lachlanhurst/dukki/scripts/mjcf_to_f360/README.md

# mjcf_to_f360

Rebuilds a MuJoCo MJCF robot (for example the microduck model in
`microduck_rl`) inside Autodesk Fusion 360 as a positioned, jointed assembly
of mesh bodies. Nothing is converted to solid CAD geometry. The result is a
reference assembly to remodel parts against.

What you get in Fusion:

- One "link" component per MJCF body (named `<body>_link`), placed at the
  body's world pose in the zero configuration, all directly under the root.
  Links attached to the world (the trunk) are grounded.
- One "part" component per mesh asset, nested inside the links, holding a
  single mesh body in the mesh's own frame and coloured from the MJCF
  material. A part that appears several times (servos, bearings) is one
  component with several occurrences, so redrawing it once as solid geometry
  updates every instance. Each occurrence carries the geom's body-relative
  pose.
- A rigid group per link (named `<link>_rigid`) binding the link's parts to
  it. Fusion's motion solver works on the flattened assembly, so without this
  the parts would stay behind when a joint is driven.
- An as-built revolute joint for every hinge (slider for every slide) between
  child and parent links, with MJCF joint ranges applied as limits. A
  construction sketch line named `axis_<joint>` in the child link marks each
  axis.

The browser tree therefore looks like:

```
root
  trunk_base_link            (grounded)
    trunk_base:1
    xl330:1
    xl330:2
    seeed_bearing__configuration__22x16x4:1
    ...
  yaw2roll_link
    yaw2roll:1
    xl330:3
    ...
```

## Files

| File | Runs where | Purpose |
| --- | --- | --- |
| `mjcf_to_f360.py` | Fusion 360 | The script. Entry point is `run(context)`. |
| `mjcf_to_f360.manifest` | Fusion 360 | Required by Fusion to recognise the folder as a script. |
| `mjcf_model.py` | both | MJCF reader, standard library only. |
| `stl_tools.py` | both | STL read/transform/write, used to bake geom poses into mesh copies. |
| `dump_assembly.py` | any Python 3 | Prints the tree and joints as the script will build them. `--bake` writes positioned STLs and `assembly.json`. |
| `check_against_mujoco.py` | needs `mujoco` | Verifies the reader against MuJoCo's own kinematics. |

## Running in Fusion 360

1. Copy this whole folder to the Fusion machine. Keep the folder name
   `mjcf_to_f360`; Fusion requires the folder, script and manifest to share it.
2. Also copy the MJCF file and its mesh folder. Mesh paths are resolved
   relative to the MJCF file through `meshdir`, so the easiest option is to
   check out `microduck_rl` on that machine.
3. In Fusion create a new empty design and save it.
4. Utilities > Add-Ins > Scripts tab > the green `+` next to "My Scripts",
   choose this folder. It appears as `mjcf_to_f360`.
5. Select it and press Run. A file dialog asks for the MJCF file. Pick
   `src/mjlab_microduck/robot/microduck/robot_walk.xml` or another variant.
6. Wait for the progress dialog. A summary lists components, mesh bodies,
   joints and warnings. The full log and the baked STL copies are written to
   the system temp folder under `mjcf_to_f360/<model name>/` unless
   `BAKE_DIR` is set.

Settings live at the top of `mjcf_to_f360.py`:

- `MJCF_PATH`: hard-code the file to skip the dialog.
- `INCLUDE_GEOM_GROUPS`: `(0, 1, 2)` imports visual meshes only. Add `3` to
  include collision meshes (in this model those duplicate visual parts).
- `SKIP_MESHES`: mesh asset names to leave out, for example `("xl330",)` when
  you would rather place a J288 model yourself.
- `CREATE_JOINTS`, `CREATE_RIGID_GROUPS`, `GROUND_ROOT_BODIES`, `APPLY_COLOURS`: switch features off
  if they cause trouble on your Fusion version.
- `SHARE_REPEATED_PARTS`: `True` gives one component per mesh asset reused
  by every occurrence. `False` gives every geom its own component, which you
  want only if instances of a part need to diverge.
- `LINK_NAME_FORMAT`, `PART_NAME_FORMAT`: component naming. Links default to
  `<body>_link` because several MJCF bodies share their name with a mesh
  asset (for example `trunk_base`), and Fusion needs component names to be
  unique.
- `RECOLOUR_ONLY`: set to `True` and run again on a design built by this
  script to apply colours without re-importing. It matches part components
  by name. The log lists which appearance library and base appearance were
  used, which helps if colours still fail.
- `SWITCH_TO_DIRECT_MODELLING`: the API only allows mesh bodies in a
  parametric design inside a base feature, so the script creates one base
  feature per part. Set this to `True` to convert the empty design to direct
  modelling instead. Direct designs have no timeline and no position
  snapshots, which sidesteps the repeat-occurrence placement problem
  described below. As-built joints exist only in parametric designs, so with
  `PARAMETRIC_AFTER_PLACEMENT` on (the default) the script converts the
  design back to parametric once all parts are placed and verified, then
  creates the joints; the placed assembly becomes the base state of the
  timeline. If that conversion is refused, or you turn the option off, the
  script creates regular joints instead, drawing the axis line at the same
  world location in both links so that applying the joint moves nothing.

## Checking the model before you go to the Fusion machine

```sh
python3 scripts/mjcf_to_f360/dump_assembly.py \
    ../microduck_rl/src/mjlab_microduck/robot/microduck/robot_walk.xml

cd ../microduck_rl && uv run python \
    ../microduck-unitree/scripts/mjcf_to_f360/check_against_mujoco.py \
    src/mjlab_microduck/robot/microduck/robot_walk.xml
```

The first command prints every body with its world position and quaternion,
every joint with its world origin and axis, and every geom that will be
imported or skipped. The second compares those numbers with MuJoCo and
reports the worst error.

## Fallback without the script

`dump_assembly.py --bake OUT_DIR --units mm` writes one STL per geom with the
body-relative pose baked in, plus `assembly.json` listing each body's world
matrix and each joint's world origin and axis. Those files can be inserted
into Fusion manually if the API route misbehaves.

## Units and conventions

- MJCF lengths are metres. The Fusion API works in centimetres. Baked STLs
  are written in millimetres by default and imported as millimetres.
- MuJoCo quaternions are `(w, x, y, z)`; the reader also accepts `euler`,
  `axisangle`, `xyaxes` and `zaxis` and follows the `<compiler>` settings for
  angle units and Euler sequence.
- Links sit flat under the root rather than nested in the kinematic tree,
  because as-built joints are simplest to create between occurrences in the
  same context. The MJCF parent is recorded in each link's description.
- Part occurrences are created with the link-relative pose, then all of them
  are moved in one call to the root component's `transformOccurrences`, which
  works on the flattened assembly with every transform relative to the root.
  Per-occurrence transform properties behaved differently for the first and
  for repeated occurrences of a shared component, so they are only a
  fallback. In a parametric design the positions are then captured with a
  snapshot so the timeline cannot revert them.
- With `VERIFY_PLACEMENT` on, the script compares every part's root-context
  bounding box in Fusion against the baked mesh under the MJCF pose and logs
  `verify ...: ok` or `OFF by ... cm` per part. The check is geometric and
  independent of transform semantics. Misplaced parts are then retried
  through a sequence of alternative placement strategies (set the proxy's
  world pose, set the native occurrence's local pose, recreate the occurrence
  in the link, recreate it under the root) until one verifies; the log
  records `repaired ... via ...` for each, checks again after the position
  capture, and runs a final check after the joints. In practice only repeated
  occurrences of shared components have been affected, and the evidence so
  far points at the parametric position capture moving them after they were
  correctly placed. Two ways around it: run with
  `SWITCH_TO_DIRECT_MODELLING = True`, or set `SHARE_REPEATED_PARTS = False`
  so no component has more than one occurrence.

## Known limits

- Only mesh geoms are imported. Primitive geoms (box, capsule, sphere) are
  listed as skipped by `dump_assembly.py`.
- Ball joints, equality constraints and sites are not created. Sites appear
  in `dump_assembly.py` output only through their parent body.
- Mesh `refpos`/`refquat` attributes are ignored.
- Baked STL copies now only carry MJCF mesh scale and the unit conversion,
  not the geom pose. `dump_assembly.py --bake` still writes fully positioned
  copies, which suits manual insertion better.
- The Fusion API calls (mesh import, mesh body appearance, joint limits) are
  wrapped so a failure produces a warning in the log rather than aborting the
  import. Check the warnings list if something looks off.
- The MJCF reading and mesh baking are verified against MuJoCo on this side.
  The flat structure and the link-and-part structure both build correctly in
  Fusion; the first link-and-part run placed parts wrongly because a
  link-relative pose was set on a root-context proxy, which is now fixed. The log file records the exact call that failed if
  anything does.
