lachlanhurst/dukki/docs/bridge-pcb.md

# Bridge carrier PCB

Design note for a trunk PCB that carries the bridge: the WeAct STM32G474 core board, the LSM6DSV16X breakout, a 5 V supply from the 6S pack, a soft start on plug-in, and the power distribution to the servo segments and the head. It replaces the trunk buck, the distribution board and the point-to-point wiring of `hardware.md` sections 5.8, 10 and 11.2 with one board.

Date: 24/10/2026. Status: rev B (section 6.6) made and assembled by JLC, ordered 17/10/2026 with the head_ext board (tag `jlc-order-2026-10-17`), and tested on the bench: the soft power switch, the PC4 hold, the PA0 rail reading and the 3 s shutdown (section 6.5), all 15 servos answering on segments A, C and D, and the head powered and linked through J6 (`hardware.md` 5.8). One fault found in bring-up: the J288 pigtail has pin 1 GND, not SIGNAL as the board was laid out for, so the segment headers are fitted turned 180 degrees. The G marks are still right; the footprints and housing outlines need turning in the next revision.

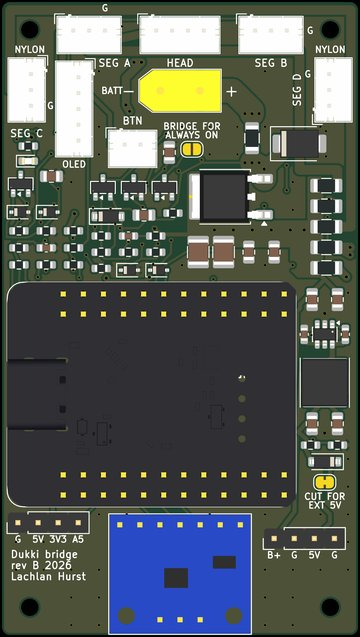
[picture p1: docs/pictures/bridge-3d-top.jpeg]
3D render of the bridge board, top face: the JST segment, head, display and button headers and the XT30 pads along the top, the soft start and buck in the middle, the WeAct core board and the LSM6DSV16X breakout at the bottom


Rev B, top face, from `hardware/bridge/bridge-3d-top.png`.

## 1. Requirements

From the decisions so far:

- Modules: the WeAct STM32G474 core board (QFN48) and the LSM6DSV16X breakout already on hand, soldered to the carrier on short sections of header pin with about a 1 mm gap underneath, so tracks and tented vias may run under them but no parts. On the bench build they sit on female headers instead.
- Battery in on a male XT30, the solder-cup cable connector (XT30U-M), not a PCB-mount part. It stands straight up from the board face, centred near the top edge: its two solder cups (2.2 mm diameter, 5.0 mm apart, measured) go through KiCad's stock XT30U-M footprint, 2.7 mm plated holes on 3.8 mm pads, soldered by hand from the back. Not fitted by JLCPCB.
- A soft start so plugging the pack in does not spark. Since rev A (12/10/2026) the soft start is also a soft power switch with a button (section 6.5); JP2 bridged restores the original always-on behaviour.
- A 5 V buck from the pack for the WeAct board's VCC input.
- SMD fuses. No current sensing.
- Every other connector is JST PH 2.0, vertical through hole (B2B/B3B/B4B/B5B-PH-K-S), soldered by hand, not by JLC. The plug enters from above, perpendicular to the board:

| Ref | Pins | Use | Pin order |
|---|---|---|---|
| J2 to J5 (segments A to D) | 3 | servo segments A to D (D not used on this robot) | board pads 1 SIGNAL, 2 +BATT, 3 GND. The J288 pigtail is the other way round, pin 1 GND (found 23/10/2026), so on rev B the header is fitted turned 180 degrees from its silkscreen outline |
| J6 (head) | 4 | head bundle (`hardware.md` 11.3) | 1 head buck +BATT, 2 GND, 3 bridge TX (PA9) to head UART7 RX, 4 bridge RX (PA10) from head UART7 TX |
| J7 (display) | 5 | status display | 1 GND, 2 3.3 V, 3 SCL (PA15), 4 SDA (PB7), the module's own order; 5 not connected. Five pins so the head bundle's 4-pin plug cannot go in it (16/10/2026) |
| J8 (button) | 2 | power and shutdown button | 1 BTN_A, 2 BTN_B: the button joins them (section 6.5) |

- Servo +BATT and GND carried on wide pours on both layers, stitched with vias.
- Board 45 mm wide by 80 mm tall, with a mounting hole in each corner. Everything tall (connectors, XT30, any capacitor over about 3 mm) in the top 20 mm; the flat modules and low parts below.
- Built by JLCPCB PCBA, parts on the top side only, preferring Basic parts. Each Extended part type adds a feeder fee of about AUD 4.60 (US$3).

## 2. Block diagram

```text
 XT30 --+-- F1 main --+-- Q1 soft start (P-FET) --+== +BATT_SW pour (both layers) ==+
        |             |                            |                                 |
       GND           TVS                        bulk C                     +--F2--> J2  seg A (PB3)
                                                   |                       +--F3--> J3  seg B (PB9)
                                                   |                       +--F4--> J4  seg C (PA2)
                                                   |                       +--F5--> J5  seg D (PC10)
                                                   |                       +--F6--> J6  head, pin 1
                                                   |
                                   U1 buck 5 V ----+---> WeAct VCC (P1-1, P1-2)
                                                          WeAct 3V3 --> IMU, OLED
                                   +BATT_SW --100k--+--10k-- GND
                                                    +--> PA0 (pack voltage), 100 nF
```

One ground node throughout: the soft start switches the positive side, so the pack's negative, the servo ground, the head's ground and the bridge's ground stay one net, as `hardware.md` 11.3 relies on.

## 3. Power

### 3.1 Current budget

PH 2.0 contacts are rated about 2 A, so the five branches cap continuous current near 9 A, with leg peaks of 2 to 3 A for short periods (`hardware.md` 11.3). The main path (XT30, F1, Q1, pours) is designed for 10 A continuous. Fifteen servos at their 1.92 A limit together (29 A) cannot pass through the connectors and is not a design case.

### 3.2 Fuses

A main fuse and one per branch. A short in a leg harness, wired in PH crimp wire, would burn the wire long before a 10 A main fuse opened, so each branch gets its own.

| Fuse | Rating | Candidate |
|---|---|---|
| F1 main | 10 A, 1206, time lag, 32 V DC, 150 A breaking | BHFUSE BSMD1206C-2100T, C41367232, Extended |
| F2 to F5 segments | 4 A, 1206, time lag, 72 V DC | BHFUSE BSMD1206C-1400T, C41367227, Extended |
| F6 head buck feed | 2 A, 1206, time lag, 72 V DC | BHFUSE BSMD1206C-1200T, C41367223, Extended |

All three are BHFUSE's BSMD1206C time-lag series (12/10/2026). The Littelfuse 0458 parts first chosen turned out to be very fast-acting, which opens within milliseconds at two to three times rating; a leg of five servos can in principle draw about 9.6 A in a stall, so a time-lag part rides through peaks a fast one would not. F1's 150 A breaking capacity is below what a 6S pack can deliver into a dead short; every 1206 fuse is in that range, and a larger fuse body (2410, or a blade) would be the step up if it ever matters. 4 A sits above the PH contact's 2 A on purpose: the fuse protects the harness wire against a short, and the contact's rating is a thermal one that short peaks do not reach. Revisit both with the measured walking draw (open item in `hardware.md` section 13). F6 went from 1 A to 2 A on 12/10/2026: the head carrier's 5 V, 3 A buck draws about 0.85 A from a nearly flat pack (about 20 V) before amplifier peaks, too close to a 1 A rating.

### 3.3 Soft start

A high-side P-channel MOSFET (Q1) whose gate is pulled down slowly, so the switched rail rises over about 30 ms instead of in microseconds. Inrush is then the downstream capacitance times the ramp rate, and the only capacitance on the XT30 side of Q1 is the TVS and the FET itself, so the plug barely arcs.

```text
 +BATT_IN ---+--------------+------ S  Q1  D ------+---- +BATT_SW
             |              |          G           |
             R2 470k     C1 2.2u       |     R3 1k + C2 47n (Miller)
             |              |          |           |
             +------+-------+----------+-----------+
                    |       |
               D1 15 V      R1 470k
              (Vgs clamp)   |
                           GND
```

- R1 and R2 set the on-state gate drive: half the pack, 10.5 to 12.6 V across a 6S discharge, inside the FET's ±20 V. D1 clamps transients.
- C2, gate to drain through R3 (1 k, which keeps C2 from loading the gate at high frequency), sets the ramp. During the Miller plateau about 38 µA leaves the gate node, so the drain rises at about 810 V/s: 25 V in about 31 ms. Inrush is about 0.8 A per mF of downstream capacitance.
- C1, gate to source, stops the FET switching on at the instant of plug-in. Without it, C2 would hold the gate at the drain's 0 V while the source jumped to 25 V. With 2.2 µF against 47 nF, the gate starts within 0.6 V of the source, below the threshold.
- Turn-on delay before the ramp is about 0.2 s, set by R1, R2 and C1.
- The FET dissipates the energy stored in the downstream capacitance during the ramp, ½CV², over 30 ms, plus whatever the servos draw as they wake. Q1's single-pulse SOA at 10 to 100 ms has to cover it. Measured 10/10/2026 with a meter's capacitance range across VCC and GND, unpowered: 64, 60 and 56 µF on three J288s, so about 60 µF each, ordinary electrolytic spread. Fifteen servos make about 0.9 mF, and the board's bulk (section 3.4) brings the worst case to about 1.2 mF. That gives about 1 A of inrush and about 0.4 J at 25 V, well under the 2 mF (0.6 J) first assumed here.

Chosen: NCE40P70K (C130101, Extended, 5,600 in stock), 40 V, 10 mΩ at 10 V, TO-252, pin 1 gate, tab drain, pin 3 source. KiCad's stock library has the TO-252 footprint and the larger package gives more pulse margin than the Diodes DMP4015SPSQ (C384564, 7 mΩ, PowerDI5060-8), which needs a footprint drawn from its datasheet; it stays the alternative if the band runs short of room. At 10 A Q1 dissipates about 1 W, which its drain pour has to spread; average current is far lower.

A TVS on the input (SMBJ26A, 26 V standoff, 28.9 V minimum breakdown) protects Q1 from plug-in ringing and regeneration spikes; it cannot protect the servos, whose 25.2 V limit is too close to a full pack for any TVS. The SMBJ30A first fitted could clamp at up to 48 V at full surge current, above Q1's 40 V; the 26 V part clamps at 42 V at its full 14 A rating and near 30 V at the currents plug-in ringing gives (changed 16/10/2026).

### 3.4 Bulk capacitance

In the schematic: two 10 µF 50 V X7R 1210 MLCCs (C3, C4) and two 2.2 µF 50 V MLCCs (C5, C6). The polymer capacitors were dropped at layout: at 7.7 mm tall they needed the top band, which the connectors fill. The servos carry about 0.9 mF between them, so the board's own bulk was only ever a supplement.

After Q1, to absorb regeneration when servos brake and to stiffen the rail at the branch connectors. Two ways, depending on height:

- Low profile: four to six 10 µF 50 V X7R 1210 MLCCs (2.5 mm tall, so they can sit outside the tall band). At 25 V they keep about 3 to 4 µF each.
- Tall: one or two 35 V polymer capacitors, 100 µF in 6.3 x 7 mm (C2982822, 66,000 in stock) or 220 µF in 8 x 9 mm, inside the tall band.

The servos carry their own input capacitors and a LiPo absorbs regeneration well, so the board's bulk is a supplement. Start with the MLCCs plus one polymer if it fits.

### 3.5 5 V buck

TI LMR51606XDBVR (C21260865, Extended, about 9,700 in stock): 4 to 65 V in, 600 mA, SOT-23-6, 400 kHz, light-load efficient mode. A 65 V rating leaves margin over a full pack plus transients, where 36 V parts such as the TPS560430 sit too close. Load is the WeAct board, IMU and OLED, under 150 mA. Output to the WeAct's VCC pins (P1-1, P1-2) through D8 and JP1; the board's own LDO makes 3.3 V. Capacitors from TI's datasheet; the inductor is TI's 33 µH in a 6 x 6 x 4.5 mm Sunlord SWPA6045S330MT (1.65 A saturation), above the converter's 1.4 A maximum current limit so a 5 V short cannot saturate it (the 4 x 4 mm SWPA4030S first chosen saturated at 1.1 A; changed 16/10/2026). Feedback 130k/22k sets 5.53 V at the buck, about 5.2 V on the rail after D8.

USB. The WeAct board feeds its USB 5 V to VCC through its own Schottky (D4, B5819W), so USB can stay plugged in with the pack connected: the buck's 5.2 V holds that diode off and nothing flows into the computer, even if a fault put pack voltage on the 5 V rail. Without D8, USB alone would feed back through the buck: from its output through L1 and the high-side switch's body diode onto the switched rail at about 4 V, charging the servos' input capacitors (about 0.9 mF) and running fifteen J288s below their 6.4 V minimum from the USB port, with a few volts on the XT30's + pin. D8 (B5819W, C8598, Basic) between the buck's output and JP1 blocks that path. With both connected, the buck and USB share through their two diodes.

### 3.6 Backup 5 V

In case the on-board buck does not work, the board can take an external step-down instead:

- J9, four plated wire pads at 2.54 mm in the bottom-right corner, silkscreened B+ G 5V G: pin 1 is the switched rail (+BATT_SW, after the soft start, so the external module also gets the inrush limit), 2 ground, 3 the 5 V rail in, 4 ground.
- JP1, a solder jumper bridged by a copper trace, joins the buck's output (net 5V_BUCK: L1, C11, C12 and the feedback divider, then through D8) to the 5 V rail that feeds the WeAct board. Silkscreen beside it: CUT FOR EXT 5V. Cutting it isolates the buck, which then regulates only its own output capacitors.
- To use the backup: cut JP1, wire the external module's input to J9 pins 1 and 2 and its output to pins 3 and 4. The switched rail and the servos are unaffected.
- If the soft start itself ever fails, the servos lose power regardless of the 5 V; the fix then is a wire across Q1, from its source pad to its tab.

### 3.7 Pack voltage

100 k from +BATT_SW, 10 k to ground, 100 nF at PA0, as `hardware.md` 5.8 specifies. Full scale 36 V.

## 4. Signals

The pin allocation is `hardware.md` section 5.8, with the carrier's additions: PC4 the power hold, PB5 the button sense through Q3, PA5 the J10 breakout, and fused +BATT on each segment connector's pin 2 (5.8 notes them).

| Net | WeAct pin | To |
|---|---|---|
| Segment A, B, C, D data | PB3, PB9, PA2, PC10 | J2 to J5 pin 1, each through a 0 R link with room for a series resistor (hardware.md 5.6). The 5.6 V zener footprints first planned were dropped 12/10/2026 to make room for the soft power switch; they were never fitted and the bench runs without them |
| Link TX, RX | PA9, PA10 | J6 pins 3 and 4 |
| IMU SCK, MOSI, MISO, CS, INT1 | PB13, PB15, PB14, PA4, PA8 | breakout SCL, SDA, AD0, CS, INT1; VCC to 3V3 |
| OLED SCL, SDA | PA15, PB7 | J7 |
| Button sense | PB5 | Q3 drain (J8 is BTN_A and BTN_B, section 6.5) |
| Power hold | PC4 | D11 to PWR_ON (section 6.5) |
| PA5 breakout | PA5 | J10 |
| Pack voltage | PA0 | divider |

The IMU breakout's three-pin row (SDX, SCX, INT2), measured 12.0 mm from the 7-pin row, gets plated holes but no connections: header pins there support the breakout against vibration (footprint in `hardware/kicad/`, see its README).

## 5. Floor plan

As laid out (11/10/2026), board coordinates in mm from the top-left corner:

```text
  0 +---------------------------------------------+  top edge
    | (o)  SEG A      HEAD      SEG B         (o) |  row 1: J2, J6, J3
    | SEG C OLED  BATT [ XT30 ]           SEG D   |  J4, J7, J1, J5: side connectors and the display turned along their edges
    |               BTN          F1  TVS          |  J8, main fuse, input TVS
 20 +---------------------------------------------+  end of the tall band
    | LED, divider,  gate     Q1        branch    |  low parts only
    | data-line      network  (TO-252)  fuses     |
    | R, power switch        bulk MLCC F2..F6     |
 36 +------------------------------------+--------+
    |                                    |        |
    |  WeAct G474 core board, horizontal | 5 V    |  1 mm stand-off
    |  36.3 x 28.1, USB-C at left edge   | buck   |
    |                                    | JP1    |
 64 +-------+--------------------+-------+--------+
    |       |  LSM6DSV16X        |                |
    | (o)   |  breakout, pins up |  J9 backup (o) |  between the lower holes
 80 +-------+--------------------+----------------+  bottom edge
```

- (o) are the four M2 mounting holes (2.2 mm), centres 3.5 mm from each edge. Use nylon screws (or nylon washers) in the top two, H1 and H2, marked NYLON on the silkscreen: segment C's fused +BATT feed runs round the top edge under their screw heads, about 1.9 mm from the hole centres.
- The head connector is top centre and the XT30 second-row centre (swapped 11/10/2026 for better head and battery cable runs).
- SEG C and SEG D are turned 90° outward, pin rows along the left and right edges with the housing's latch side facing the edge. The display connector (J7) is turned the same way as SEG C and stands beside it.
- Ground pins that carry current connect solid to both pours, not through thermal spokes: the XT30's ground pad, the ground pins of the five servo and head connectors, and the WeAct board's ground header pins. Spokes (0.5 mm, at most four a layer) would have choked the battery return, about 10 A through one pad. Solid pads take a hotter iron: 60 W or more and a large tip for the XT30.
- Locked 2.5 mm ground copper on both layers runs from the XT30's ground pad towards the + pad and up and down, so no signal track passes between or beside the pads, and stitching vias ring the pad.
- The WeAct board is horizontal, as the user asked, with its USB-C at the left board edge so a cable reaches it from the side. Its long side does not fit between the corner holes, so it sits between the top band and the IMU.
- The IMU breakout sits at the bottom, centred between the lower holes, turned 180° so its pin row faces the WeAct's P1 row (PB13 to PB15 and PA8 are there). In this orientation the chip's X axis points left and Y down the board; the mount quaternion must use that (hardware.md 6.1).
- The high-current path (XT30 +, F1, Q1, the switched-rail trunk and the fuse column) stays in the top band and the right of the middle band.

### 5.1 Fitting the tall band

The through-hole PH connectors (9.0 x 5.6 mm courtyard for 3 pins, 11.0 x 5.6 for 4) are far smaller than the SMD ones first chosen (11.4 x 8.5), which let the display and button return to connectors and still leaves room in the band for F1 and the TVS.

## 6. Parts so far

| Function | Part | LCSC | Library |
|---|---|---|---|
| 5 V buck | TI LMR51606XDBVR | C21260865 | Extended |
| Buck inductor | Sunlord SWPA6045S330MT, 33 µH, 6 x 6 x 4.5 mm | C83451 | Extended |
| Soft-start FET | NCE40P70K, TO-252 | C130101 | Extended |
| Main fuse | BHFUSE BSMD1206C-2100T, 10 A time lag | C41367232 | Extended |
| Segment fuses | BHFUSE BSMD1206C-1400T, 4 A time lag | C41367227 | Extended |
| Head feed fuse | BHFUSE BSMD1206C-1200T, 2 A time lag | C41367223 | Extended |
| Bulk | 10 µF 50 V X7R 1210 | C596319 | Extended |
| Input TVS | SMBJ26A (hongjiacheng) | C19077580 | Preferred |
| Gate clamp | BZT52C15, SOD-123 | C19077412 | Preferred |
| Power LED | KT-0603G, green | C12624 | Extended |
| XT30, male, solder cup | Amass XT30U-M | hand fitted, cups through 2.7 mm plated holes | |
| PH connectors | JST B3B-PH-K-S (x4), B4B-PH-K-S, B5B-PH-K-S, B2B-PH-K-S | hand fitted | |

Resistors (except R9 130k and R21 2.2M, which are Preferred: no fee) and the 100 nF, 47 nF, 1 µF, 2.2 µF and 22 µF capacitors are Basic parts; the schematic carries every LCSC number. That makes 8 non-Preferred Extended part types (U1, L1, Q1, the three fuse types, the 10 µF 1210 and the LED), about AUD 37 in feeder fees per order (JLC waives the fee for Preferred parts), of which the LED (dispensable) and the three fuse types are the easiest to trim. Genuine JST through-hole PH headers fit the servo pigtails' housings for certain; buy them with the XT30.

## 6.1 Schematic

`hardware/bridge/bridge.kicad_sch` (KiCad 10), PDF beside it. Bootstrapped by `scripts/kicad/gen_bridge_sch.py`, which every pin connects through a net label, power symbol or no-connect flag, so there are no wires; from now on the schematic file is the source and the script refuses to overwrite it. ERC: no violations. Project symbols (the LMR51606, from KiCad's LMR50410 with the same pinout, and a TO-252-numbered P-MOSFET) are in `hardware/kicad/Dukki.kicad_sym`.

Not in the BOM, fitted by hand or not parts at all: the XT30 (J1), all seven PH connectors (J2 to J8), the WeAct board (U2), the IMU breakout (U3) and the mounting holes.

## 6.2 Layout

`hardware/bridge/bridge.kicad_pcb`, 2 layers, 45 x 80 mm, 1 mm corner radius. Bootstrapped by two scripts run on the KiCad VM, after which the board file is the source:

- `scripts/kicad/gen_bridge_pcb.py` builds the board from the schematic netlist, the same links "Update PCB from Schematic" makes, places every part (the `PLACE` table holds the floor plan), draws the outline and puts the hand-assembly labels on the silkscreen. Reference designators are on the fab layer only: JLC places by the CPL file.
- `scripts/kicad/route_bridge_pcb.py` sets the net classes (segment feeds 1.2 mm, head feed 1.0 mm, buck switch node 0.6 mm, other power 0.5 mm, signals 0.25 mm), draws and locks the high-current copper by hand on both layers, tied with via pairs (XT30 + to F1 and F1 to Q1's source at 3 mm each side, necking to 1.6 mm for the last 1.5 mm into the fuse's pads, which are only 2.9 mm apart; the switched-rail trunk at 2 mm on top plus its pour and 3 mm underneath; the fuse column at 2 mm on top plus the pour). By IPC-2221 one 3 mm track of 1 oz copper carries about 5 A for a 10 degree rise and 2 mm about 4 A, so a single layer would have run 40 to 50 degrees warm at the 10 A design current; two layers bring it to about 10 °C. 2 oz copper is the alternative if it is ever needed. The script also routes the four segment feeds by hand, each in its own lane (left to the autorouter, they knocked one another out once the power copper was locked; SEG C's runs round the outside of the board on the top layer, right edge, top edge, left edge, so it walls nothing off), then autoroutes the rest with Freerouting, pours ground on both layers and a solid switched-rail pour over the trunk, and stitches the ground pours with a via grid wherever clearance allows.

Freerouting 2.5.0 needs Java 25. Both live in `~/opt` on the VM (an Eclipse Temurin JRE and the release jar from GitHub, no system install). DRC on the routed board: no copper errors and nothing unconnected.

## 6.3 Fabrication package and cost

`scripts/kicad/export_jlc.py` (on the VM) writes `hardware/bridge/fab/`: `bridge-gerbers.zip` (copper, mask, paste, silkscreen, outline, separate PTH and NPTH Excellon files), `bridge-bom.csv` and `bridge-cpl.csv` in JLC's column formats. Only parts with an LCSC number, in the BOM and not DNP go to assembly.

Checked against JLC's 2-layer limits: narrowest track 0.187 mm (limit 0.127), clearance 0.2 mm (0.127), smallest via 0.6 mm on a 0.3 mm drill (ring 0.15, limit 0.13), smallest plated hole 0.75 mm, copper to edge 0.25 mm. Silkscreen text is 0.8 to 0.9 mm high (0.6 mm for the pin names inside J6 and J7), strokes 0.15 mm, against JLC's recommended 1.0 mm: legible, but small.

`hardware/bridge/bridge-polarity.png` (from `scripts/kicad/polarity_check.py`) is a top render with every assembled polarised part's pin 1 or cathode ringed and its CPL rotation labelled, to check against JLC's placement preview before confirming the order.

`scripts/kicad/jlc_cost.py` prices the BOM from JLC's live parts library (11/10/2026), with JLC's published Economic PCBA fees (US$8 setup, US$1.50 stencil, US$0.0016 a joint, US$3 per Extended part type, Preferred exempt), at A$1.44 per US$:

| Boards assembled | Parts | Fees | Assembly total |
|---|---|---|---|
| 5 | A$34 | A$49 | about A$83 |
| 2 | A$19 | A$49 | about A$68 |

Not included: the bare boards (2 layers, 45 x 80 mm, a few dollars for five), shipping to Australia and GST, which JLC's cart adds, and the hand-fitted parts (XT30U-M, seven JST PH-K headers). Of the fees, A$35 is the eight Extended part types (the buck, its inductor, Q1, three fuse values, the 10 µF bulk capacitors and the LED); dropping the LED or making the four segment fuses and the head fuse one value would each save A$4.30.

Before ordering, check in JLC's placement preview that the polarised parts sit the right way round: U1 (pin 1), Q1 (tab), D1 and D2 (cathode bar), D3 (LED cathode). KiCad and JLC disagree on the zero rotation of some packages.

## 6.4 3D model

`hardware/bridge/bridge.step` (about 3 MB, committed 22/10/2026) holds the assembled board and every part, in millimetres from the board's lower-left corner (the fab files' origin) with z = 0 on the top face. It is written by `python3 scripts/kicad/export_step.py bridge` from the repo root on the VM, which exports a temporary copy of the board with the WeAct board's model swapped for `CoreBoard_STM32G474_standin.step` (outline, MCU, USB-C receptacle and pins at the same height), as WeAct's model carries no licence and is not ours to redistribute. For a local file with WeAct's own model, run `kicad-cli pcb export step --subst-models --drill-origin -o bridge.step bridge.kicad_pcb` in `hardware/bridge/` and do not commit it. KiCad's library supplies the SMD parts, the PH headers and the wire-pad header; `scripts/kicad/gen_3d_models.py` supplies the rest: the WeAct board from WeAct's own model (or the stand-in), lifted to the 1 mm stand-off on short pins with its tall headers removed; the IMU breakout (outline, holes, chip, both pin rows, also at 1 mm); and an approximate XT30U-M (housing to the footprint outline, 11 mm tall, cups through the board), which KiCad's library lacks.

The board's drill and placement origin is its lower-left corner, and `export_jlc.py` writes the Gerbers, drill files and placement file relative to it. The first placement file measured from that corner while the Gerbers used KiCad's page coordinates; JLC flagged the offset and corrected it automatically.

## 6.5 Soft power switch and PA5 breakout (12/10/2026)

The soft start is now also an on/off switch (schematic block 9). Off means everything downstream of Q1 is off (servos, buck, bridge, LED, head feed), which answers the overnight drain in hardware.md section 10.

| Ref | Part | Job |
|---|---|---|
| Q2 | 2N7002 | grounds R1 (net PWR_LO): Q1 is on only while Q2 is on |
| JP2 | solder jumper, open | bridge it (silkscreen BRIDGE FOR ALWAYS ON) to ground PWR_LO permanently: the old behaviour, on whenever a pack is plugged in, soft start intact. It also keeps Q5 and Q4 off |
| R14, J8 | 100k, the button | the button joins BTN_A, fed from the pack through R14, to BTN_B. It switches about 250 µA, and only while held, so R14's value costs nothing at rest (470k, then 220k, until 16/10/2026: with 100k a tap of about 70 ms latches at an 18 V pack with worst-case parts and the bridge's PC4 asserted within 0.5 s, about 45 ms if PC4 is asserted early; 220k needed about 150 ms); the contacts see pack voltage while open, which any tactile switch handles at that current, and R14 limits a pinched or shorted lead to microamps. J8's pins are BTN_A and BTN_B, no longer PB5 and ground |
| D9, R15, C14 | 12 V zener, 1M, 1 µF X7R 0805 | clamp BTN_B to 12 V and hold the button sense on for about a second after release. X7R keeps most of its 1 µF at 12 V; the X5R 0603 first fitted kept about half |
| D12 | 1N4148WS | BTN_B to Q2's gate (PWR_ON) |
| D11, R13, C15 | BAT54WS, 1M, 1 µF X7R 0805 | the bridge's hold: PC4 (PWR_HOLD) to PWR_ON, about 3 V; the diode keeps BTN_B's 12 V off PC4. C15 with R13 (about 1 s) stretches a tap: a short tap charges PWR_ON to a few volts through D12 (about 11 V only after a press of half a second or more), which keeps Q2 on long enough after release for the bridge to boot and assert PC4. It also holds Q2 on through a bridge reset (watchdog, fault, software reset) for 0.22 s worst case (0.76 s typical, 1.4 s best: PWR_ON starts at 3.2 V, Q2's threshold is 1.0 to 2.6 V), so a reset does not cut the servos and the head as long as the firmware re-asserts PC4 within milliseconds. As PWR_ON decays Q5 and Q4 snap Q1 off while it is still fully on, so C15's slow decay cannot leave Q1 half on (added 16/10/2026) |
| Q3 | 2N7002 | button sense: pulls PB5 low while BTN_B is high. PB5 sees only its pull-up and Q3, and a press reads low as on the breadboard, so one firmware build runs on both. Because of C14, PB5 stays low for about a second after release |
| R20, D13, Q5 | 1M, 12 V zener, 2N7002 | with Q2 off, PWR_LO rises to Q1's gate voltage; Q5 turns on |
| Q4, R21, R22 | MMBT3906, 2.2M, 1M | Q5 turns Q4 on, pulling Q1's gate to its source in about 20 ms (C1 alone would take about a second, with Q1 half on meanwhile). Q4 also holds Q1 firmly off at plug-in |

Off-state leakage is about 20 µA (Q4's base current and R1, R20 into D13), decades for a pack, below its self-discharge. All parts are JLC Basic or Preferred: no new feeder fees.

PA5 breakout (J10): four plated wire pads at 2.54 mm in the bottom-left corner, silkscreened G 5V 3V3 A5. The board name block moved down below it.

Firmware rules, as implemented in `src/bridge/src/power.rs` and `button.rs` (23/10/2026). The same build runs on the breadboard, where PC4 and PA0 are unconnected and the hold is a no-op; tie A0 to ground through 10 k there, or the floating pin makes the boot decision a guess.

- At boot, set the PC4 hold if the button is pressed or PA0 shows the switched rail live (above 6 V; C15 has held it on through a reset). That re-latches after a watchdog or software reset, and leaves power off when only USB is plugged in. It runs as soon as the clocks are up, a few milliseconds after reset, well inside C15's 0.22 s worst case; reading PA0 needs the ADC, so it cannot come before clock setup.
- A press already down at boot does not count towards a shutdown until it is released, and neither does the press that turns the power on from USB; only a fresh press can start the 3 s shutdown hold.
- On USB with the hold off, a fresh press sets the hold and turns the robot on.
- A completed 3 s hold commits a shutdown. Release PC4 once the head reports off; at once if no compute module has spoken since the bridge started; or after the request's 10 s lapse if a running or stalled head does not acknowledge it. After that no press counts. If the bridge is still running 3 s later, the display shows "RELEASE BUTTON" if it is held, otherwise "POWER OFF, unplug pack" (USB, JP2 bridged, or the breadboard). Once the rail reads dead with the button up (on USB), the hold is off again and a fresh press turns the robot back on.
- C14 keeps PB5 low for about a second after release, so a press of a little over 2 s completes the 3 s hold, and the display's countdown runs on after release.
- The IWDG runs with a 1 s timeout, pet every 10 ms by the power task: a hung bridge resets and lets the hold go instead of keeping the robot on until the pack is unplugged. A system reset stops it, so the console's `U` and DFU flashing still work (checked 23/10/2026).
- Flash over SWD or DFU with USB connected or JP2 bridged: entering the bootloader releases PC4, and on pack power alone the board turns itself off 0.2 to 1.4 s later.
- The OLED's top line shows the switched rail from PA0, and the console's `power:` line the hold state, the rail and what the boot decision saw.
- Low-voltage shutdown, still to do: on the 10 s average of PA0 below the threshold, request the same shutdown the button does, so robotd sits the robot and halts the CM4, then release PC4. A lower hard floor (about 3.3 V a cell under load) cuts power after a short delay even if the head does not answer. The low-battery warning already reads PA0 (battery.rs): it took the servos' 0.5 V readings until 23/10/2026, and a servo that lost power kept its last reply, taken as the rail fell, so the warning came on after every power-off.

Bench check on the assembled rev B board, 23/10/2026, with no servos: the hold, the 3 s shutdown and power-on from USB all work, and PA0 reads 12.1 V from a 12 V supply.

## 6.6 Rev B: pre-order review (16/10/2026)

A review before ordering found the WeAct footprint wrong and a handful of smaller issues. The board was regenerated from the generators and re-routed; the name block now reads rev B.

- WeAct footprint: P1 (the VCC side) had its rows swapped. `gen_weact_kicad.py` assumed odd pins on the inner row of both headers, but the two headers are the same part placed the same way round, so P1's odd pins are on its outer row and P2's on its inner row; the silkscreen's two label lines read as the rows beside them, and the user confirmed PB13 on P1's inner row. On the rev A layout every P1 signal would have met its column neighbour: PA9/PA10 swapped, SPI2 SCK on PB12, segment B's data on BOOT0. The breadboard was never affected: it is wired by the labels.
- J7 (display) is a 5-pin PH, pin 5 unconnected, so the 4-pin head bundle cannot be plugged into it. With both 4-pin, the head cable in J7 shorted 3.3 V through F6, and the display cable in J6 put 25 V across the module backwards.
- C15 (1 µF on PWR_ON) holds the power switch through a bridge reset and does the tap stretching; C14 is now X7R 0805; R14 is 100k (section 6.5).
- L1 is now the SWPA6045S330MT (1.65 A saturation) and D2 an SMBJ26A (section 3.3, 3.5).
- Buck column re-laid in current order: input capacitors C7/C8 (switched-rail pads up, ground pads down), U1 turned 270 degrees so its GND pin faces them and SW and CB face the inductor, the boot capacitor C9 beside CB and SW, the 100 nF C10 beside VIN, L1 on end with its switch-node pad up, then the output capacitors, divider, D8 and JP1. The feedback trace was re-routed after a second review: it drops to the bottom layer at U1's FB pin and runs down the west side to the divider, 17 mm long and at least 1.9 mm from any switch-node copper (it had run between U1's CB and SW pins and 0.22 mm beside L1's switch pad).
- Bulk capacitors C3 to C6 stood on end under Q1: switched-rail pad up into the extended rail pour, ground pad down into ground, solid to both. Lying flat they had cut the pour into slivers.
- Ground pads of the power capacitors (C3 to C8, C10 to C12) and U1 connect solid, not through thermal spokes.
- The head feed VHEAD has its own 1.0 mm net class (it was in the 0.6 mm class and Freerouting necked it to 0.45 mm in places); two of its four layer changes have a second via (the other two had no room).
- Second review, local copper only: F3's segment B vias moved 0.15 mm off its output pad (they overlapped it, so solder could wick away from a 4 A joint); D2's ground pad solid with two stitching vias; the XT30's + pad has 0.75 mm clearance to everything else and the ground bar beside it is shorter (a slipping iron there shorts the pack); JP2's ground pad on thermal spokes so it can be bridged with an iron.
- H1 and H2 take nylon screws (section 5); segment C's feed still runs round the top edge.
- A G beside each segment connector's ground pin (pin 3), outside the housing so it shows with a plug in: a pigtail crimped the wrong way round swaps SIGNAL and GND, and the mark lets each harness be checked with a meter before it goes in.
- Pin names inside the head (J6: B+, G, TX, RX, the bridge's own TX and RX) and display (J7: G, 3V3, SCL, SDA, NC) connectors' housings on the front, in 0.6 mm text to fit between the pads and the outline (the board's minimum silkscreen height lowered to 0.5 mm for them; JLC recommends 0.8 to 1.0 mm, so they print a little soft). Hidden once the connectors are fitted: a reference on an unpopulated board.
- Pin labels for both modules on the front silkscreen (`scripts/kicad/module_labels.py`): the WeAct board's in its own style, two lines per column between the header rows with the upper line naming the upper row, so the board reads like the module sitting on it; the IMU breakout's beside each pin, vertical (the SPI half of its dual names: MISO, MOSI, SCLK). They lie under the modules once fitted, for checking orientation as each goes on.
- JP1 (cut to isolate the buck) turned 180 degrees so D8's output pad faces JP1's buck-side pad; the 5V_D feed had crossed the cut line diagonally. A top-layer keep-out strip now runs across its gap, 1.5 mm past the link either side, so nothing but the link itself lies where a knife could slip (`route_bridge_pcb.py` adds it after autorouting; JP1's two links are drawn by hand).
- Not changed: the segment connectors stay single-contact PH 2.0 (about 2 A a contact against 4 A fuses), by the user's choice.

Routing: `route_bridge_pcb.py`, then the head board's tidy script on the bridge (`python3 scripts/kicad/tidy_head_pcb.py <stage> bridge`, stages unstitch, dedupe, straighten until it reports 0, widen, stitch; not unground, since on this board the autorouted ground tracks join pockets of the packed middle band that the pours cannot reach). It straightened 231 joints and replaced the 2.2 mm stitching grid with a sparser 3.5 mm one. Its pad check was tightened: a joint on a pad of the net is never straightened (it had cut C1 out of Q1_G). `scripts/kicad/route_one_net.py` now takes `PCB=` and `W=` from the environment for stragglers; this run needed none. DRC with schematic parity: no violations, nothing unconnected. 31 BOM lines, 54 placements; the new parts are Basic (C28323, C22961) or Preferred (C19077580), so the feeder fees are unchanged.

## 7. Open items

- XT30 polarity: KiCad's XT30U-M footprint marks pad 1 (square) as − and pad 2 as +, and the schematic follows it (pin 1 GND, pin 2 +BATT). Check against the connector's moulded marks before soldering.
- Strain-relief holes beside the display and button pads, if wanted.
- Height limit outside the band: the WeAct's USB-C and buttons stand about 3.5 mm above the carrier plus the 1 mm stand-off, so anything under that should be fine.
- Review the routed board in the KiCad GUI before fabrication outputs: track routes Freerouting chose, the pours, and the silkscreen labels.
- Q1's SOA curve against about 0.4 J over 30 ms (section 3.3).
- Branch fuse ratings, from the measured walking draw.
- The WeAct board's underside: anything that stops it sitting flat.
