lachlanhurst/dukki/hardware/bridge/bridge-3d-top.png

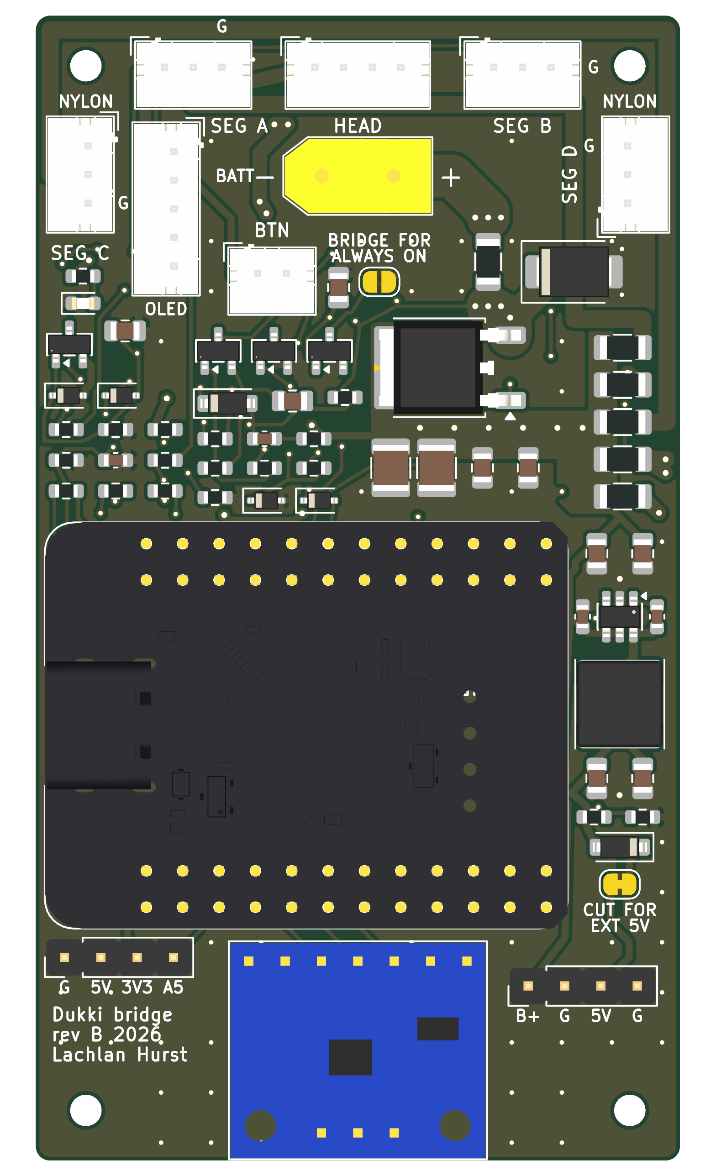
hardware/bridge/bridge-3d-top.png
