lachlanhurst/dukki/hardware/bridge/bridge-polarity.png

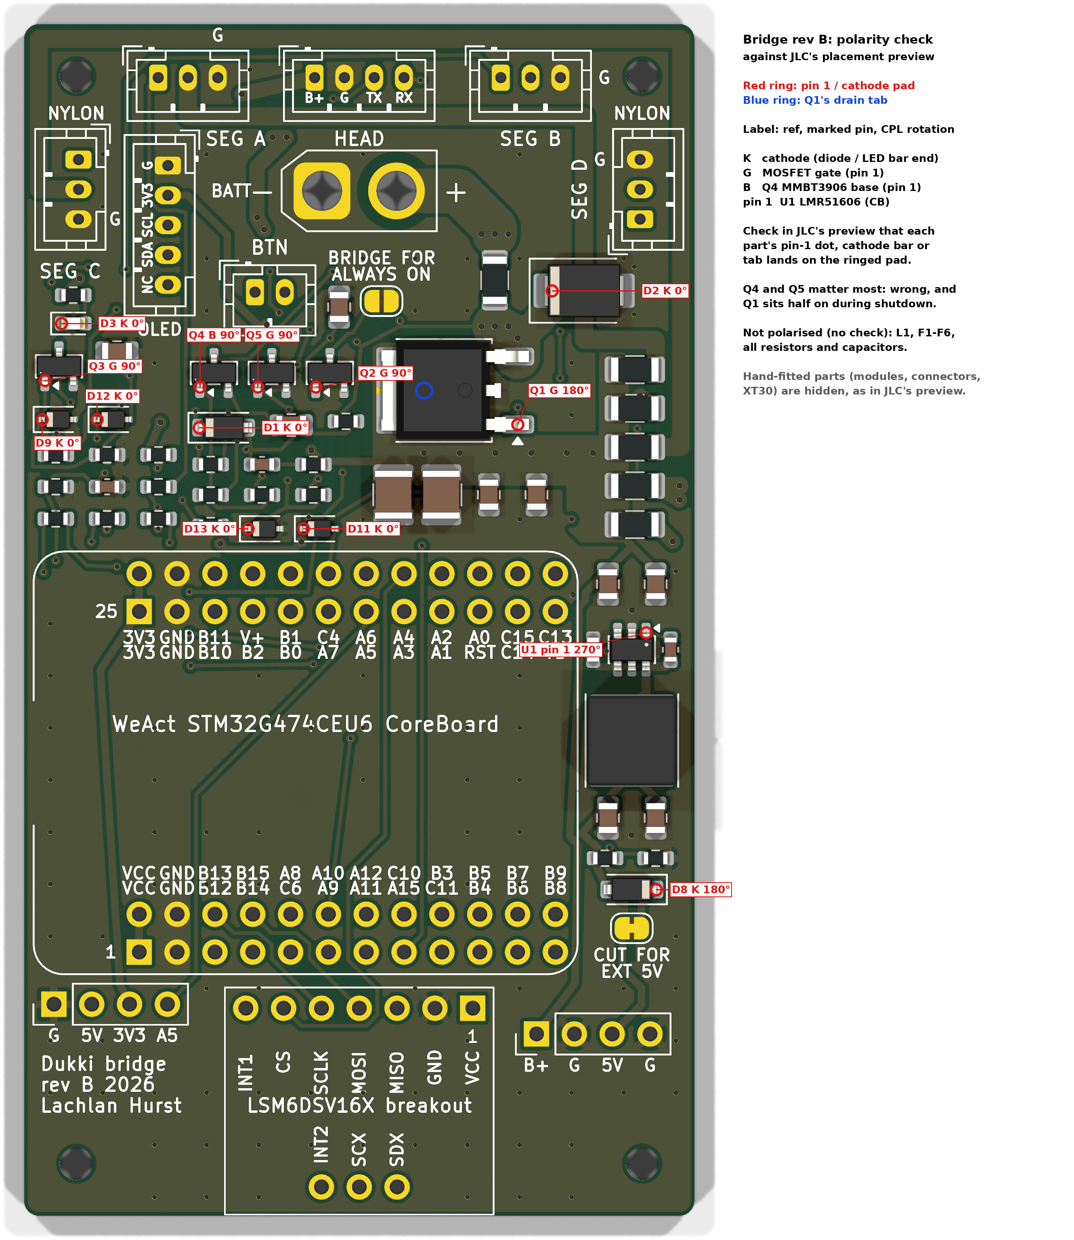
hardware/bridge/bridge-polarity.png
