lachlanhurst/dukki/hardware/head/head-3d-bottom.png

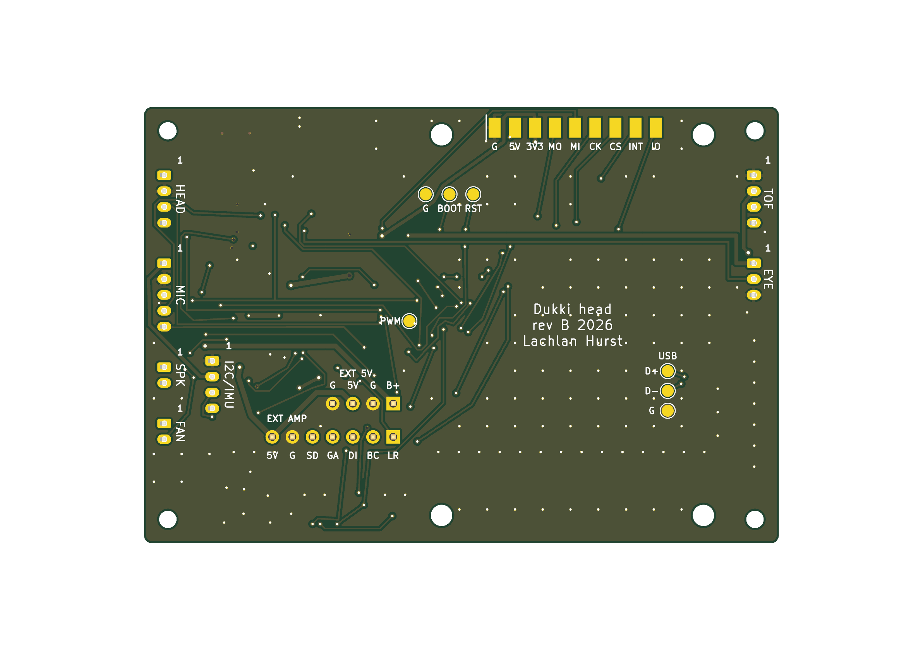
hardware/head/head-3d-bottom.png
