lachlanhurst/dukki/hardware/head/head-3d-top.png

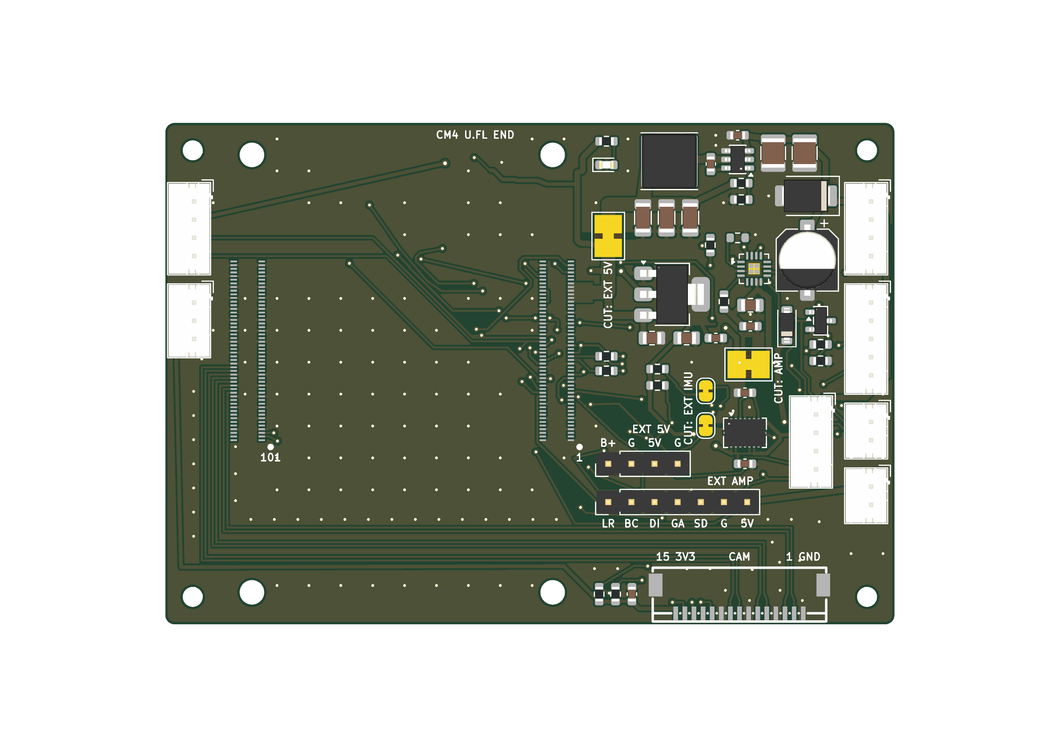
hardware/head/head-3d-top.png
