lachlanhurst/dukki/hardware/head/head-polarity.png

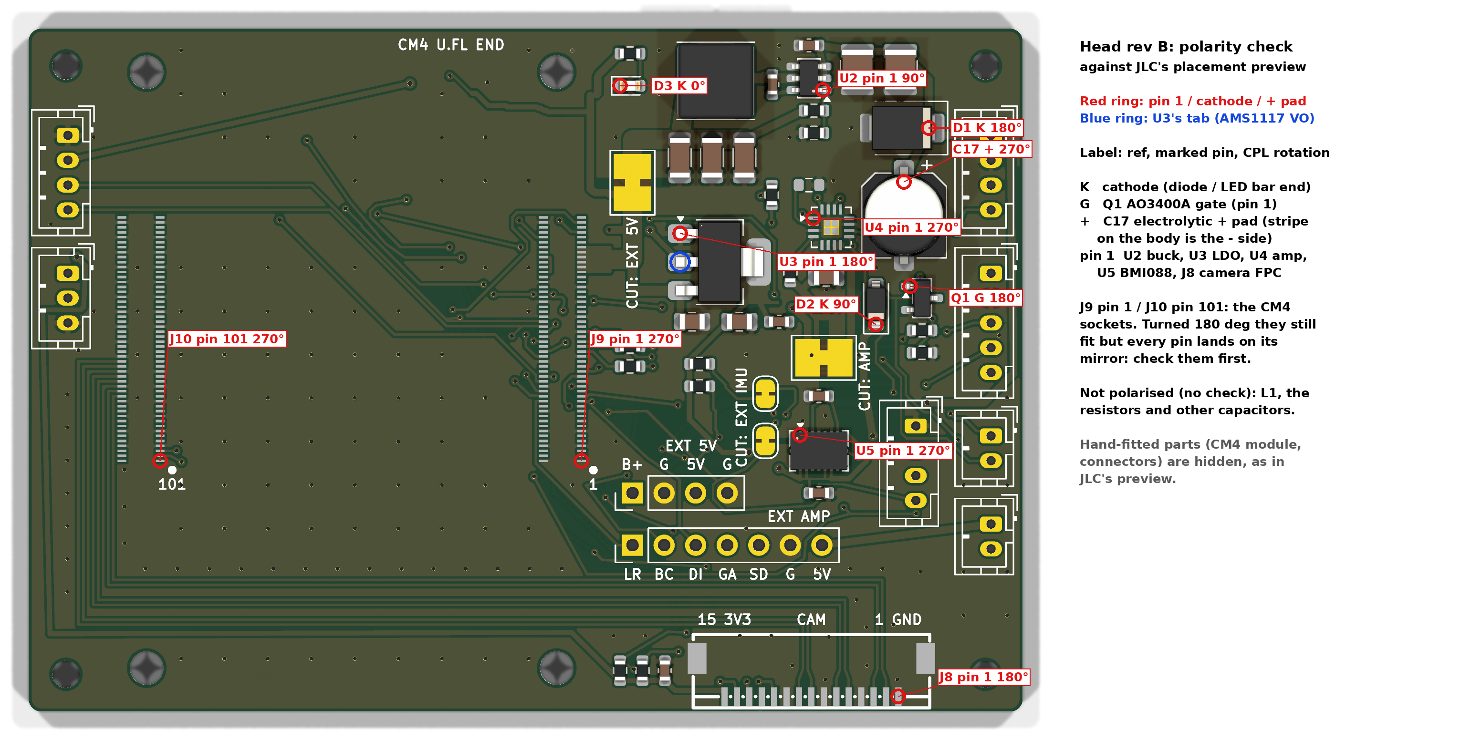
hardware/head/head-polarity.png
