lachlanhurst/dukki/hardware/head/fab/head-bom.csv

Comment | Designator | Footprint | LCSC Part #
10u 50V X7R | C1,C2 | C_1210_3225Metric | C596319
100n 50V | C4,C5,C11,C13,C14,C15,C16 | C_0603_1608Metric | C14663
47u 10V | C6,C7,C8 | C_1206_3216Metric | C96123
10u 25V | C9,C12 | C_0805_2012Metric | C15850
22u 25V | C10 | C_0805_2012Metric | C45783
47u 50V | C17 | CP_Elec_6.3x7.7 | C970679
SMBJ30A | D1 | D_SMB | C19077584
B5819W | D2 | D_SOD-123 | C8598
green | D3 | LED_0603_1608Metric | C12624
Camera | J8 | FPC_XUNPU_FPC-1.0HF-15PWAR-H20_1x15-1MP_P1.0mm | C19269369
CM4 socket 1-100 | J9 | DF40C_Socket_CM4_1-100 | C597931
CM4 socket 101-200 | J10 | DF40C_Socket_CM4_101-200 | C597931
4.7u | L1 | L_Sunlord_SWPA6045S | C78804
AO3400A | Q1 | SOT-23 | C20917
82k | R1 | R_0603_1608Metric | C23254
15k | R2 | R_0603_1608Metric | C22809
1M | R3 | R_0603_1608Metric | C22935
100R | R5 | R_0603_1608Metric | C22775
100k | R6 | R_0603_1608Metric | C25803
330R | R7,R14 | R_0603_1608Metric | C23138
4.7k | R8,R9,R10,R11 | R_0603_1608Metric | C23162
1k | R12,R13 | R_0603_1608Metric | C21190
LMR51635YDDCR | U2 | TSOT-23-6 | C45262770
AMS1117-3.3 | U3 | SOT-223-3_TabPin2 | C6186
MAX98357AETE+T | U4 | TQFN-16-1EP_3x3mm_P0.5mm_EP1.23x1.23mm | C910544
BMI088 | U5 | Bosch_LGA-16_4.5x3mm_P0.5mm_LayoutBorder7x1y_ClockwisePinNumbering | C194919
