lachlanhurst/dukki/hardware/bridge/fab/bridge-bom.csv

Comment | Designator | Footprint | LCSC Part #
2.2u 50V | C1,C5,C6,C7,C8 | C_0805_2012Metric | C377773
47n 50V | C2 | C_0603_1608Metric | C1622
10u 50V X7R | C3,C4 | C_1210_3225Metric | C596319
100n 50V | C9,C10,C13 | C_0603_1608Metric | C14663
22u 25V | C11,C12 | C_0805_2012Metric | C45783
1u 50V X7R | C14,C15 | C_0805_2012Metric | C28323
BZT52C15 | D1 | D_SOD-123 | C19077412
SMBJ26A | D2 | D_SMB | C19077580
green | D3 | LED_0603_1608Metric | C12624
B5819W | D8 | D_SOD-123 | C8598
BZT52C12S | D9,D13 | D_SOD-323 | C19077447
BAT54WS | D11 | D_SOD-323 | C7502694
1N4148WS | D12 | D_SOD-323 | C2128
10A | F1 | Fuse_1206_3216Metric | C41367232
4A | F2,F3,F4,F5 | Fuse_1206_3216Metric | C41367227
2A | F6 | Fuse_1206_3216Metric | C41367223
33u | L1 | L_Sunlord_SWPA6045S | C83451
NCE40P70K | Q1 | TO-252-2 | C130101
2N7002 | Q2,Q3,Q5 | SOT-23 | C8545
MMBT3906 | Q4 | SOT-23 | C7420354
470k | R1,R2 | R_0603_1608Metric | C23178
1k | R3 | R_0603_1608Metric | C21190
10k | R4,R12 | R_0603_1608Metric | C25804
0R | R5,R6,R7,R8 | R_0603_1608Metric | C21189
130k | R9 | R_0603_1608Metric | C22795
22k | R10 | R_0603_1608Metric | C31850
100k | R11,R14 | R_0603_1608Metric | C25803
1M | R13,R15,R20,R22 | R_0603_1608Metric | C22935
2.2M | R21 | R_0603_1608Metric | C22938
LMR51606XDBVR | U1 | SOT-23-6 | C21260865
