lachlanhurst/dukki/hardware/bridge/bridge.step

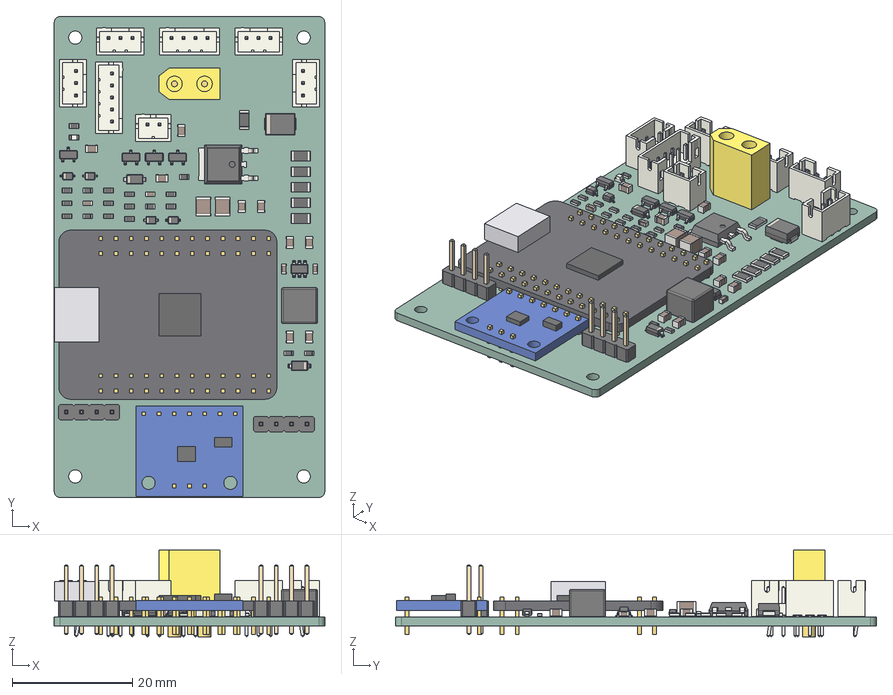
[picture p9: CAD file, 2026-10-21]
hardware/bridge/bridge.step
45.0 x 80.0 x 14.4 mm
D_SOD-323 x 4
C_1210_3225Metric x 2
C_0603_1608Metric x 4
C_0805_2012Metric x 9
JST_B3B_PH_K x 4
R_0603_1608Metric x 18
SOT-23 x 4
D_SOD-123 x 2
LED_0603_1608Metric
932d09b3-9c39-11ed-93f0-dde97e994e83_part
932d09b4-9c39-11ed-93f0-dde97e994e83_part
932d09b5-9c39-11ed-93f0-dde97e994e83_part
pcb x 2
stm32g474
usb_c
pins x 2
Fuse_1206_3216Metric x 6
a6c163e6-8551-11ed-a139-00155d22e2d7_part
a6c16512-8551-11ed-a139-00155d22e2d7_part
a6c16594-8551-11ed-a139-00155d22e2d7_part
JST_B4B_PH_K
housing
contacts
JST_B2B_PH_K
D_SMB
SOT-23-6
PinHeader_1x04_P254mm_Vertical x 2
JST_B5B_PH_K
lsm6dsv16x
regulator
bridge-step-export_PCB
