lachlanhurst/dukki/hardware/cad/stl/neck_pitch_link.stl

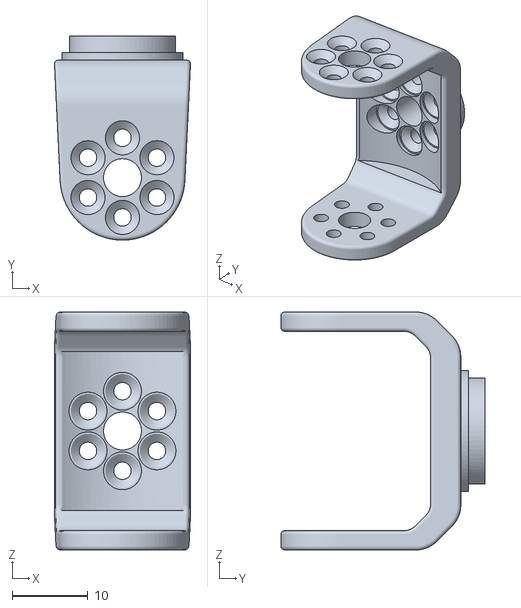
[picture p10: CAD file, 2026-11-07]
hardware/cad/stl/neck_pitch_link.stl
17.9 x 26.9 x 31.4
