lachlanhurst/dukki/hardware/head_ext/head_ext.step

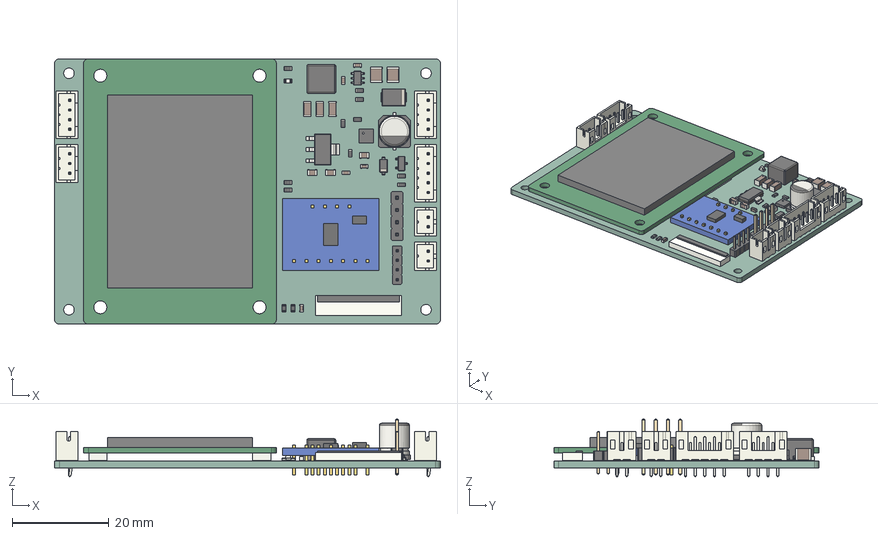
[picture p11: CAD file, 2026-10-21]
hardware/head_ext/head_ext.step
80.0 x 55.0 x 11.9 mm
pcb x 2
bmi088
regulator
pins
R_0603_1608Metric x 12
C_0603_1608Metric x 5
JST_B4B_PH_K x 2
SOT-223
SOT-23
LED_0603_1608Metric
C_1206_3216Metric x 3
D_SOD-123
JST_B2B_PH_K x 2
D_SMB
df40c_mated x 2
C_0805_2012Metric x 3
C_1210_3225Metric x 2
PinHeader_1x04_P254mm_Vertical
housing
actuator
components_envelope
TSOT-23-6
JST_B5B_PH_K
CP_Elec_63x77
PinHeader_1x04_P200mm_Vertical
TQFN_16_1EP_3x3mm_P05mm_EP16x16mm
a6c163e6-8551-11ed-a139-00155d22e2d7_part
a6c16512-8551-11ed-a139-00155d22e2d7_part
a6c16594-8551-11ed-a139-00155d22e2d7_part
JST_B3B_PH_K
head_ext-step-export_PCB
