lachlanhurst/dukki/hardware/kicad/3d/DF40C_Socket_CM4.step

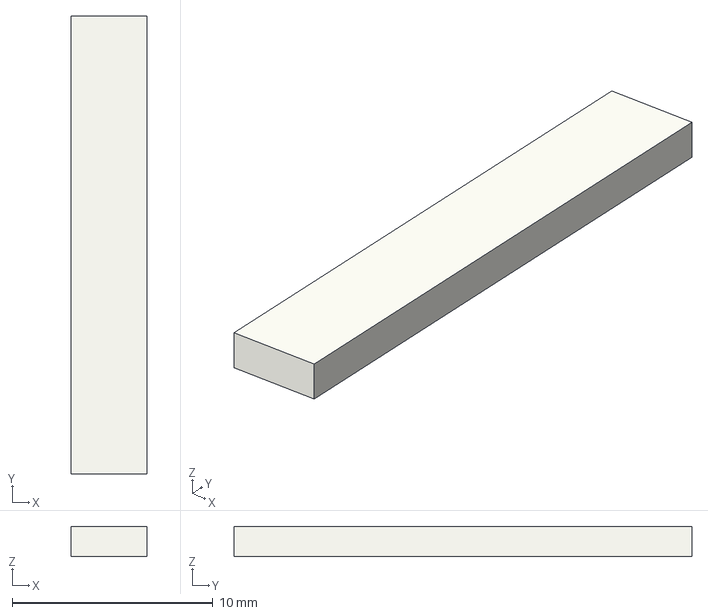
[picture p12: CAD file, 2026-10-21]
hardware/kicad/3d/DF40C_Socket_CM4.step
3.78 x 22.8 x 1.50 mm
