lachlanhurst/dukki/hardware/cad/stl/sole_left_mirrored.stl

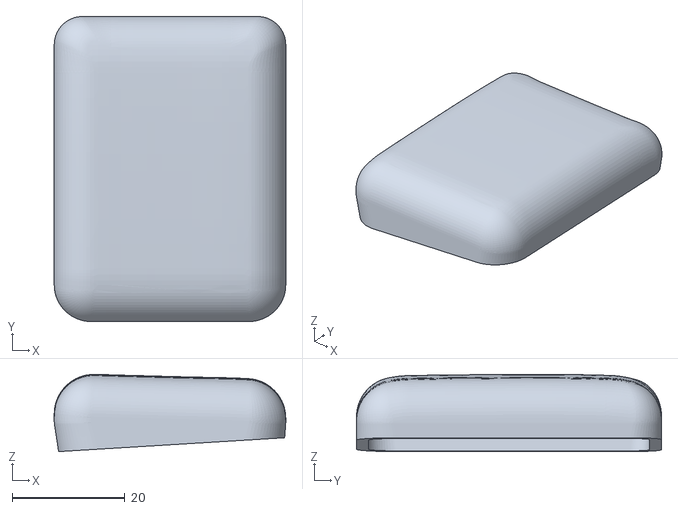
[picture p13: CAD file, 2026-11-07]
hardware/cad/stl/sole_left_mirrored.stl
41.0 x 54.0 x 13.7
