lachlanhurst/dukki/hardware/kicad/3d/BMI088_Module.step

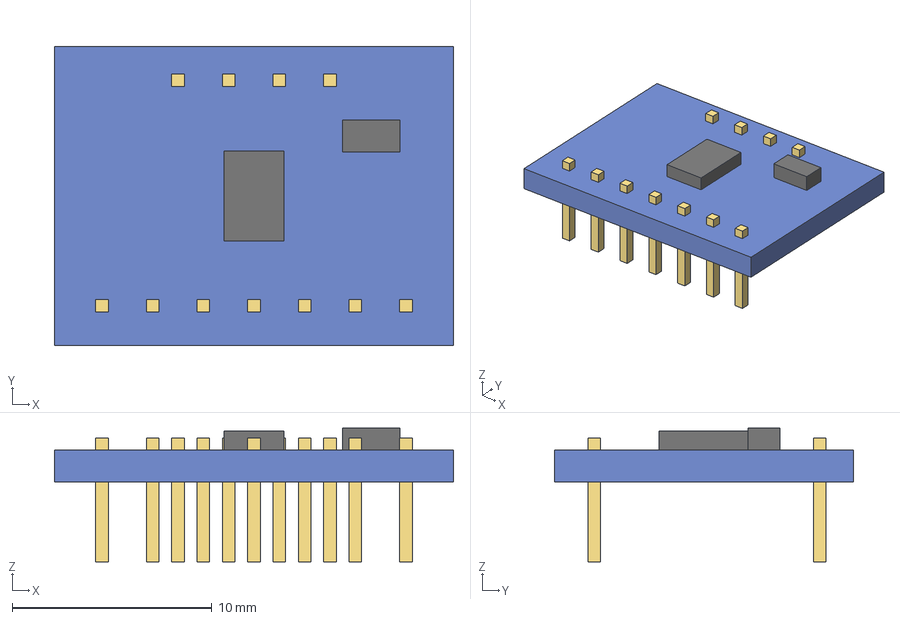
[picture p14: CAD file, 2026-10-21]
hardware/kicad/3d/BMI088_Module.step
20.0 x 15.0 x 6.70 mm
pcb
bmi088
regulator
pins
