lachlanhurst/dukki/hardware/cad/stl/bearing_roll.stl

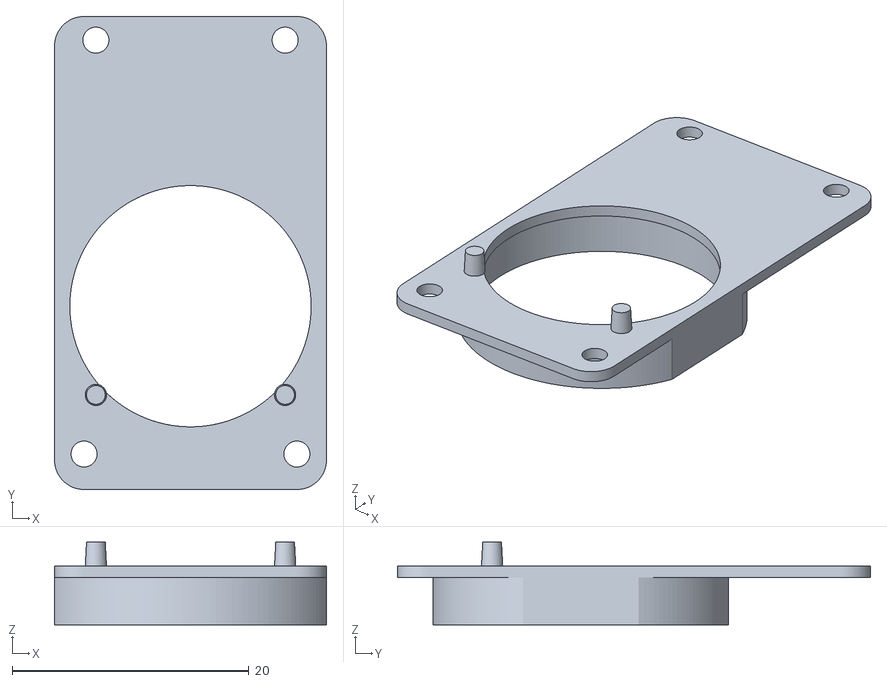
[picture p15: CAD file, 2026-11-07]
hardware/cad/stl/bearing_roll.stl
23.0 x 40.0 x 7.00
