lachlanhurst/dukki/hardware/kicad/3d/FPC_XUNPU_1x15_P1.0mm_H2.0.step

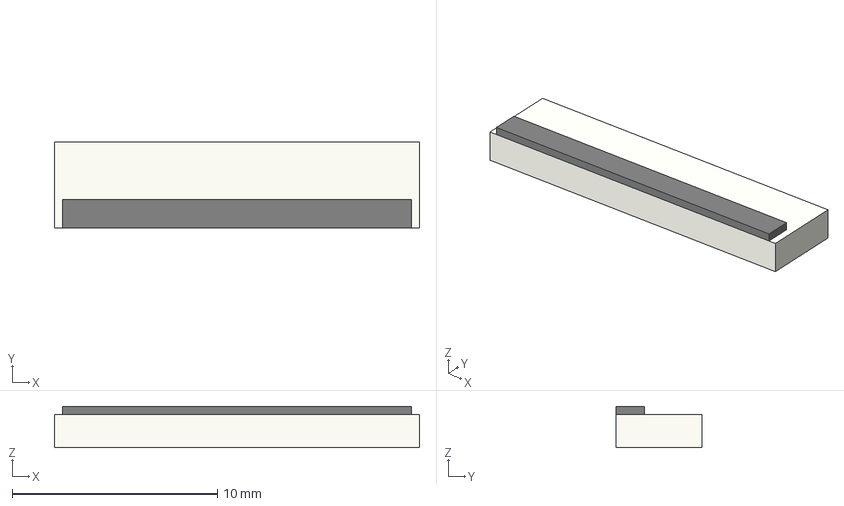
[picture p16: CAD file, 2026-10-21]
hardware/kicad/3d/FPC_XUNPU_1x15_P1.0mm_H2.0.step
17.8 x 4.20 x 2.00 mm
housing
actuator
