lachlanhurst/dukki/hardware/cad/stl/left_upper_leg_mirrored.stl

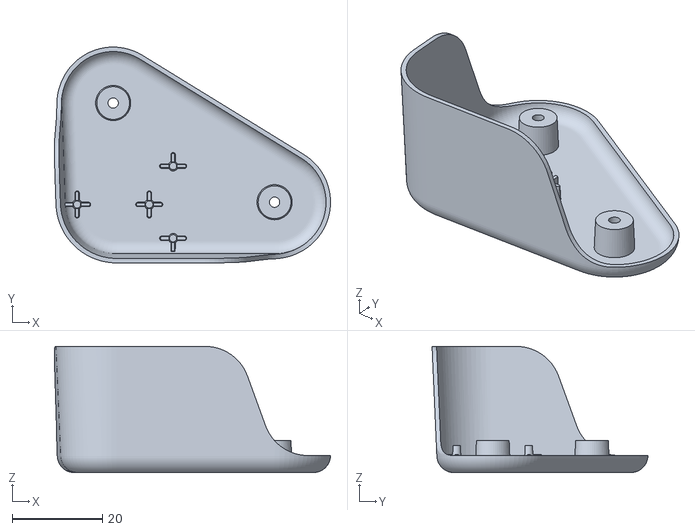
[picture p17: CAD file, 2026-11-07]
hardware/cad/stl/left_upper_leg_mirrored.stl
61.2 x 47.9 x 28.0
