lachlanhurst/dukki/hardware/kicad/3d/Radxa_CM4_Module.step

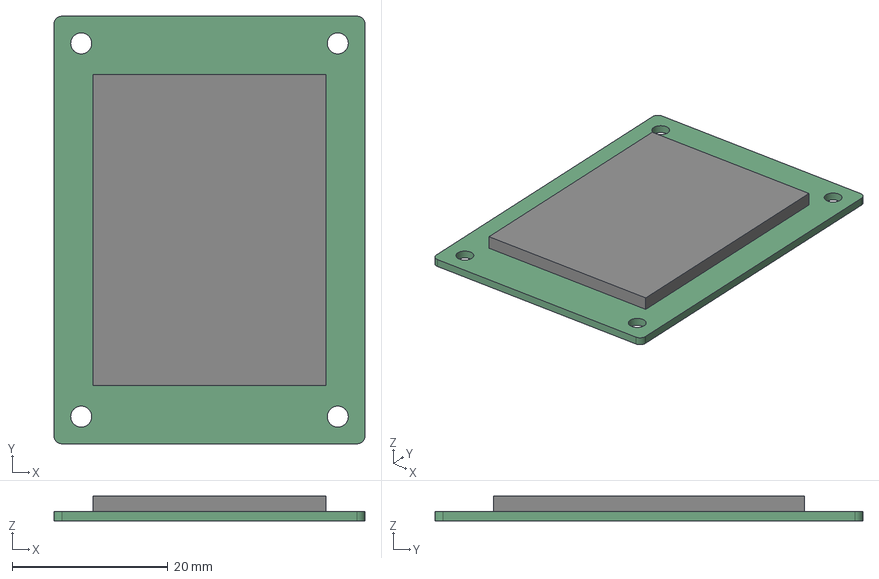
[picture p18: CAD file, 2026-10-21]
hardware/kicad/3d/Radxa_CM4_Module.step
40.0 x 55.0 x 3.20 mm
pcb
components_envelope
