lachlanhurst/dukki/hardware/cad/stl/top_head_shell.stl

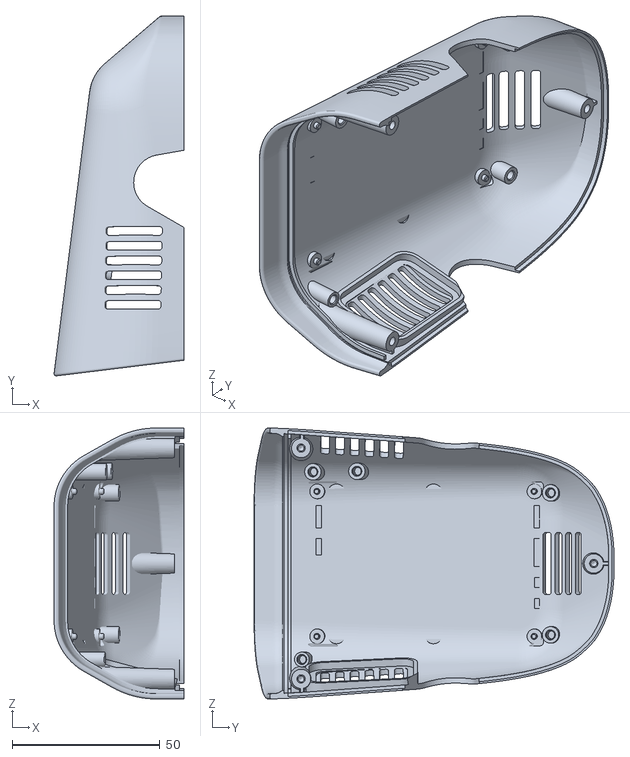
[picture p19: CAD file, 2026-11-07]
hardware/cad/stl/top_head_shell.stl
43.9 x 121.6 x 91.6
