lachlanhurst/dukki/hardware/kicad/3d/CoreBoard_STM32G474_standin.step

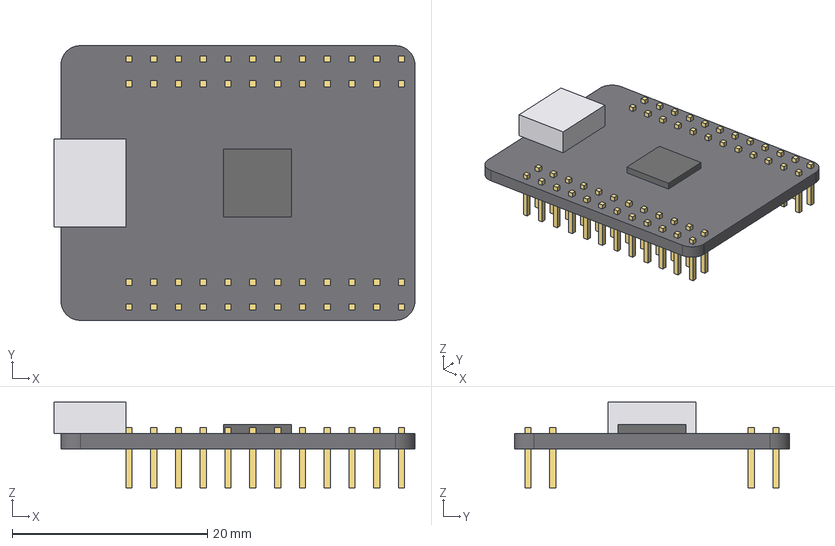
[picture p20: CAD file, 2026-10-21]
hardware/kicad/3d/CoreBoard_STM32G474_standin.step
37.0 x 28.1 x 8.79 mm
pcb
stm32g474
usb_c
pins
