lachlanhurst/dukki/hardware/cad/stl/bottom_head_shell.stl

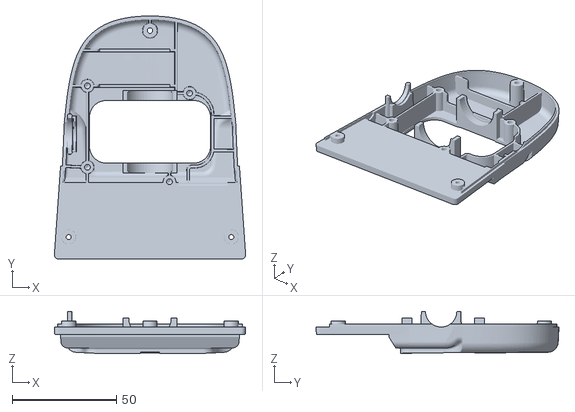
[picture p21: CAD file, 2026-11-07]
hardware/cad/stl/bottom_head_shell.stl
91.7 x 116.5 x 20.2
