lachlanhurst/dukki/hardware/kicad/3d/LSM6DSV16X_Breakout.step

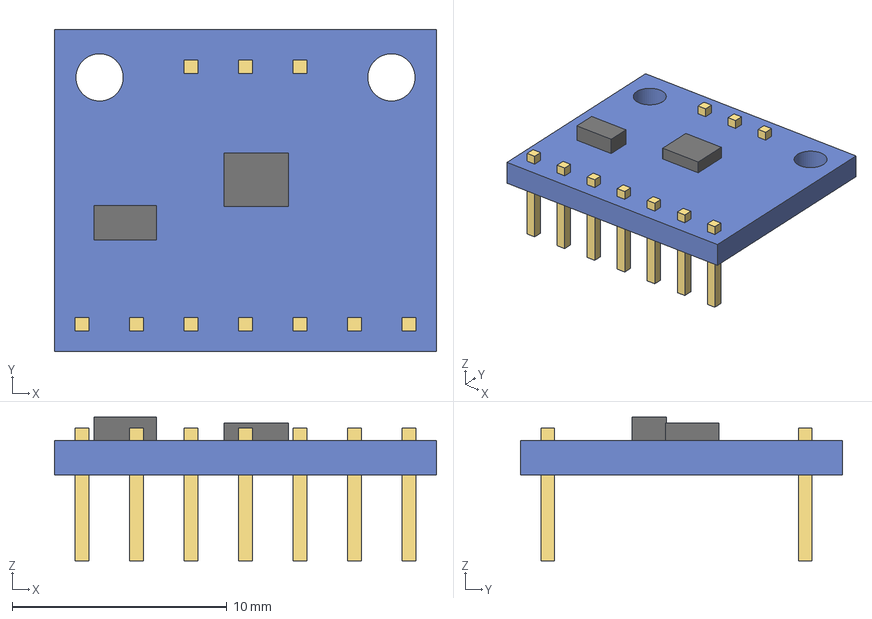
[picture p22: CAD file, 2026-10-11]
hardware/kicad/3d/LSM6DSV16X_Breakout.step
17.8 x 15.0 x 6.70 mm
pcb
lsm6dsv16x
regulator
pins
