lachlanhurst/dukki/hardware/cad/stl/leg.stl

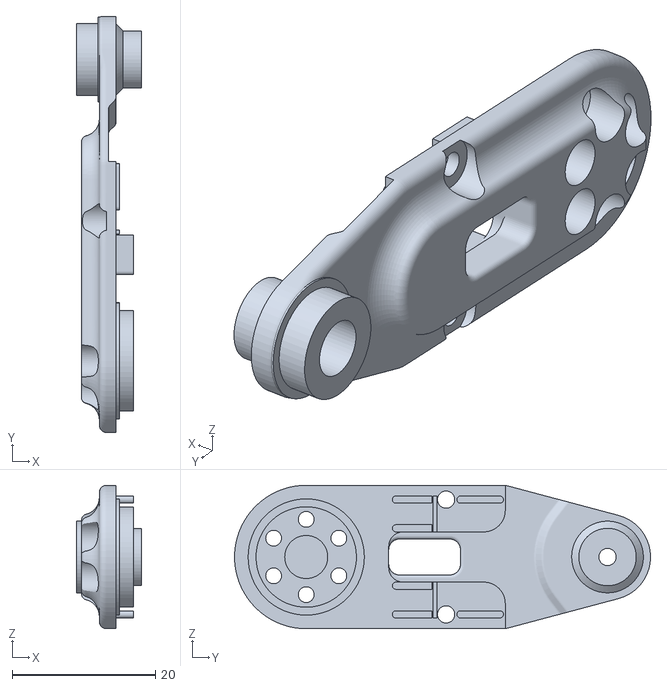
[picture p23: CAD file, 2026-11-07]
hardware/cad/stl/leg.stl
9.10 x 58.0 x 20.0
