lachlanhurst/dukki/hardware/kicad/3d/AMASS_XT30U-M.step

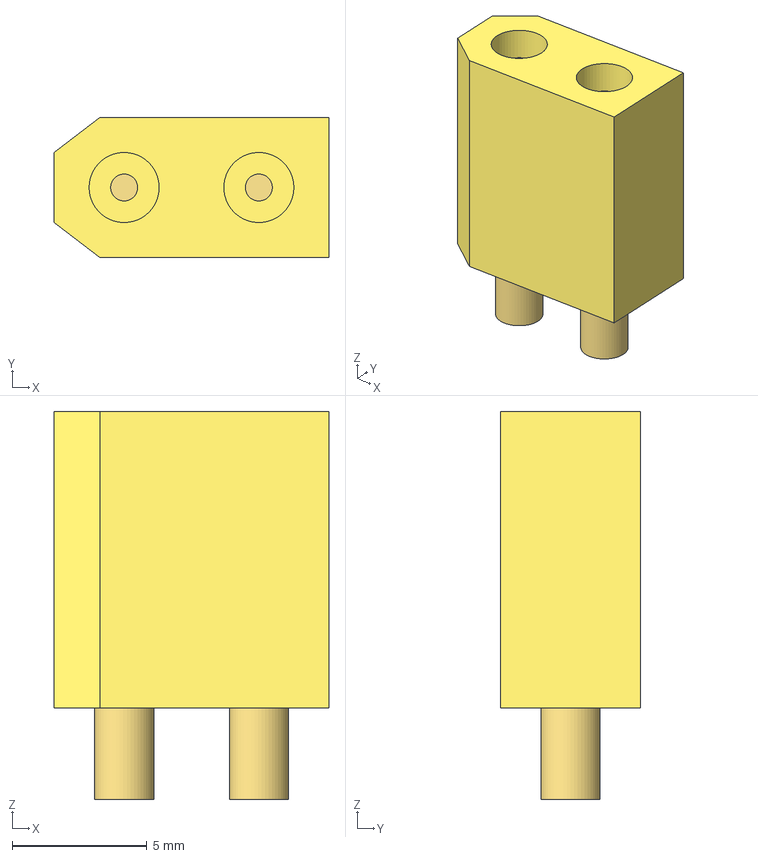
[picture p24: CAD file, 2026-10-11]
hardware/kicad/3d/AMASS_XT30U-M.step
10.2 x 5.20 x 14.4 mm
housing
contacts
