lachlanhurst/dukki/hardware/cad/stl/right_shell.stl

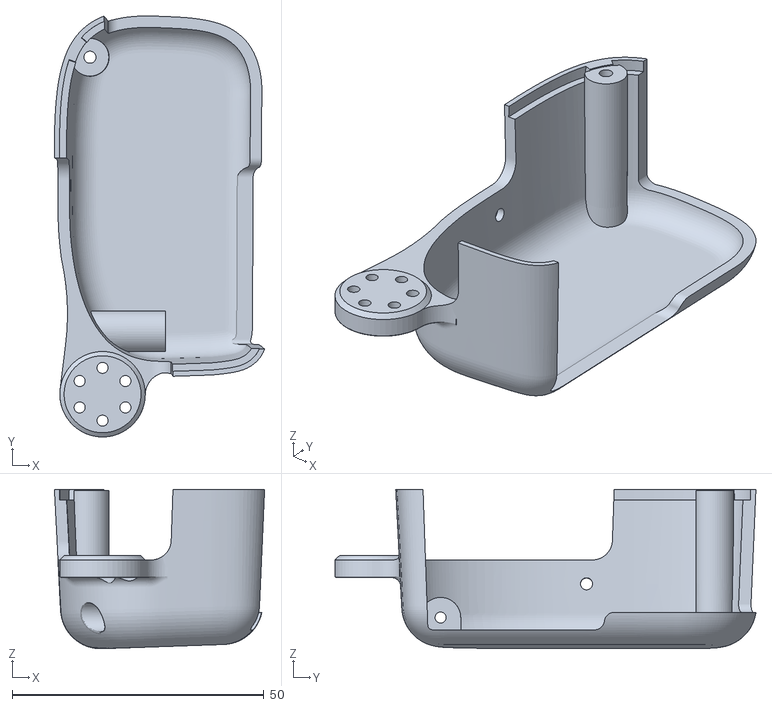
[picture p25: CAD file, 2026-11-07]
hardware/cad/stl/right_shell.stl
41.8 x 83.7 x 31.7
