lachlanhurst/dukki/hardware/cad/stl/trunk_base.stl

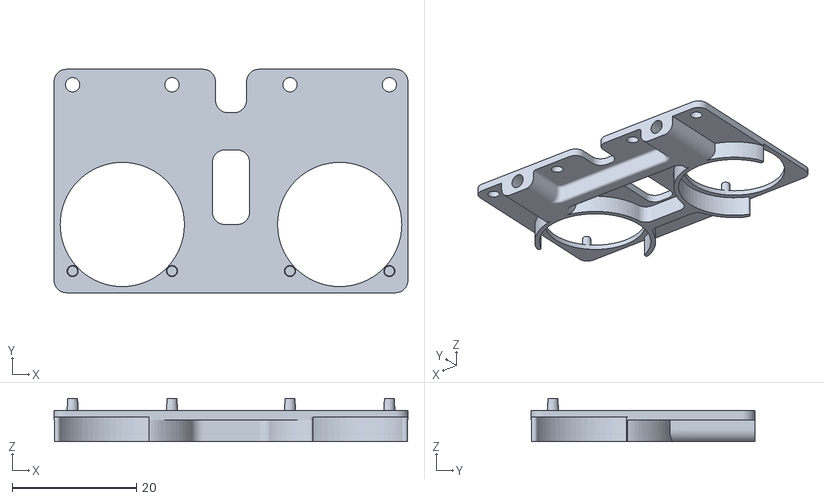
[picture p26: CAD file, 2026-11-07]
hardware/cad/stl/trunk_base.stl
57.0 x 36.0 x 7.00
