lachlanhurst/dukki/hardware/cad/stl/neck_holder.stl

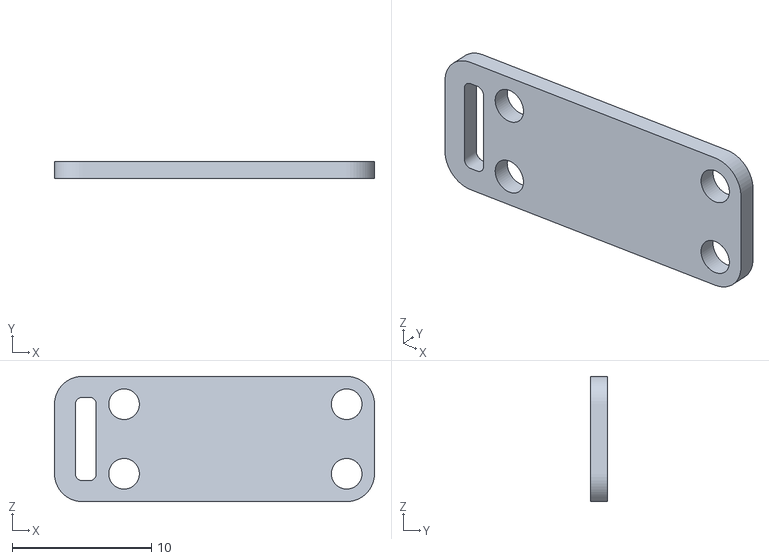
[picture p27: CAD file, 2026-11-07]
hardware/cad/stl/neck_holder.stl
23.0 x 1.20 x 9.00
