lachlanhurst/dukki/hardware/cad/stl/noenoeil.stl

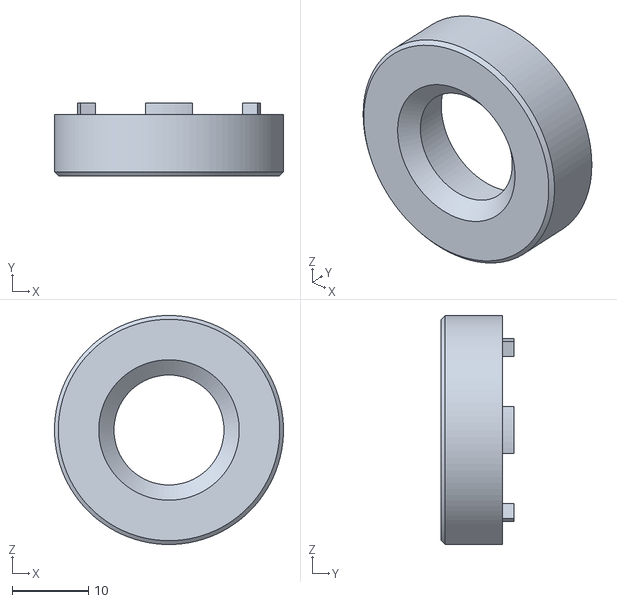
[picture p28: CAD file, 2026-11-07]
hardware/cad/stl/noenoeil.stl
30.0 x 9.50 x 30.0
