lachlanhurst/dukki/hardware/cad/stl/upper_leg_rigidity_plate_mirrored.stl

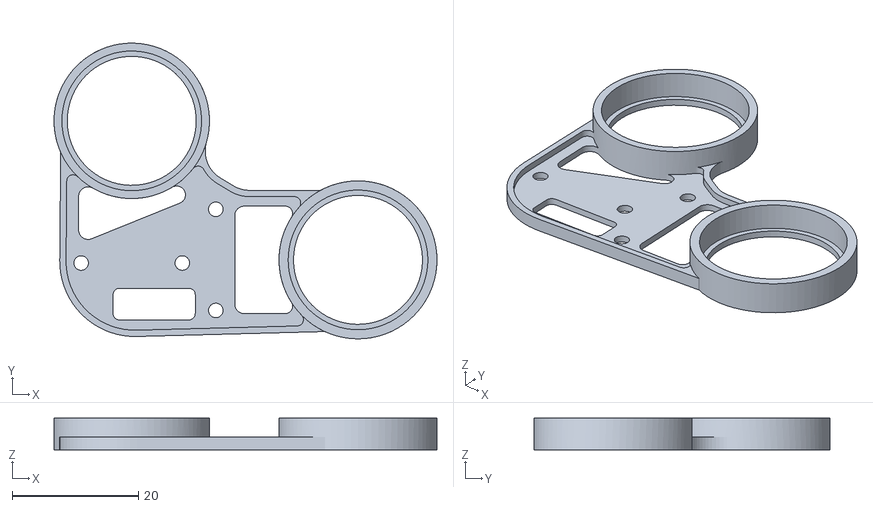
[picture p29: CAD file, 2026-11-07]
hardware/cad/stl/upper_leg_rigidity_plate_mirrored.stl
60.6 x 46.8 x 5.00
