lachlanhurst/dukki/hardware/cad/stl/hip_I.stl

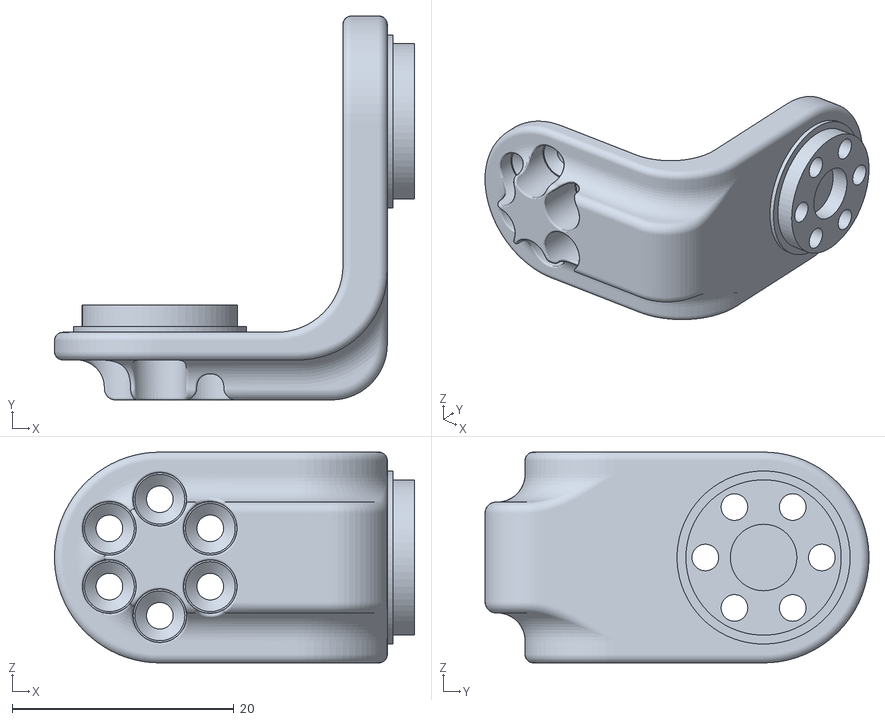
[picture p30: CAD file, 2026-11-07]
hardware/cad/stl/hip_I.stl
32.4 x 34.6 x 19.0
