lachlanhurst/dukki/hardware/cad/stl/yaw2roll.stl

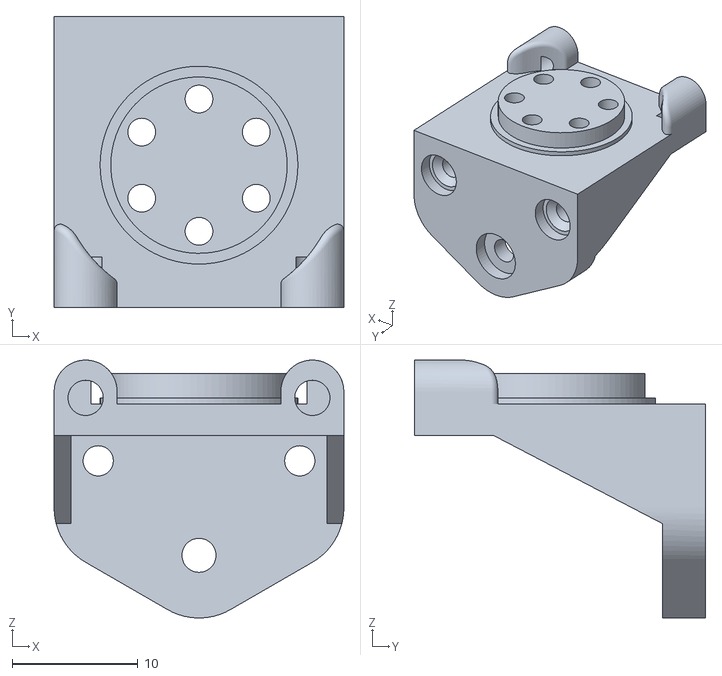
[picture p31: CAD file, 2026-11-07]
hardware/cad/stl/yaw2roll.stl
23.0 x 23.1 x 20.5
