lachlanhurst/dukki/hardware/cad/stl/bridge_mount.stl

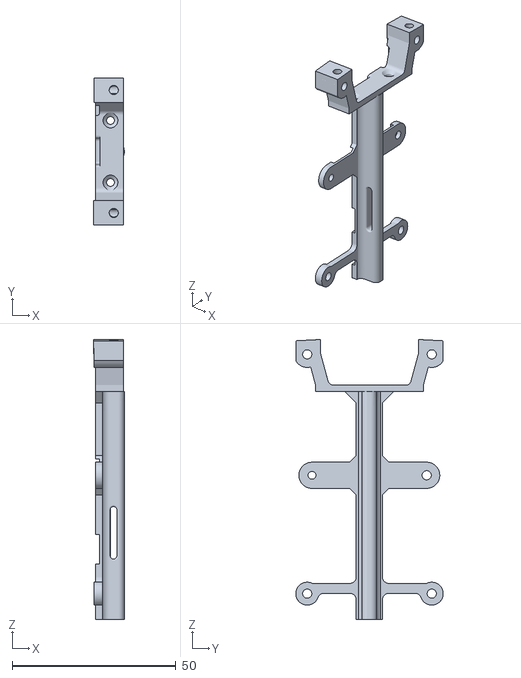
[picture p32: CAD file, 2026-11-07]
hardware/cad/stl/bridge_mount.stl
9.31 x 45.0 x 85.4
