lachlanhurst/dukki/hardware/cad/stl/jaw.stl

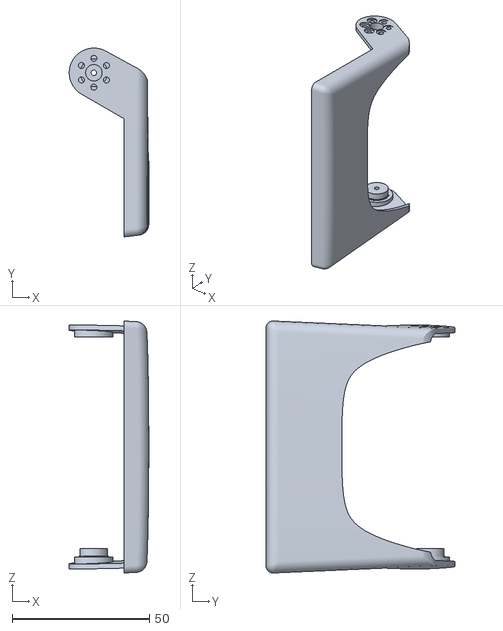
[picture p33: CAD file, 2026-11-07]
hardware/cad/stl/jaw.stl
29.0 x 68.8 x 91.8
