lachlanhurst/dukki/hardware/cad/stl/motor_support.stl

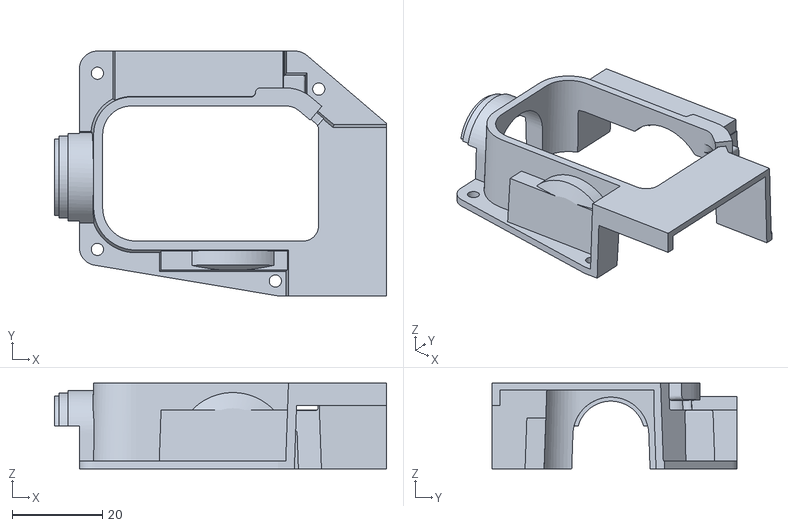
[picture p34: CAD file, 2026-11-07]
hardware/cad/stl/motor_support.stl
73.5 x 54.2 x 19.0
