lachlanhurst/dukki/hardware/cad/stl/head_compute_clamp.stl

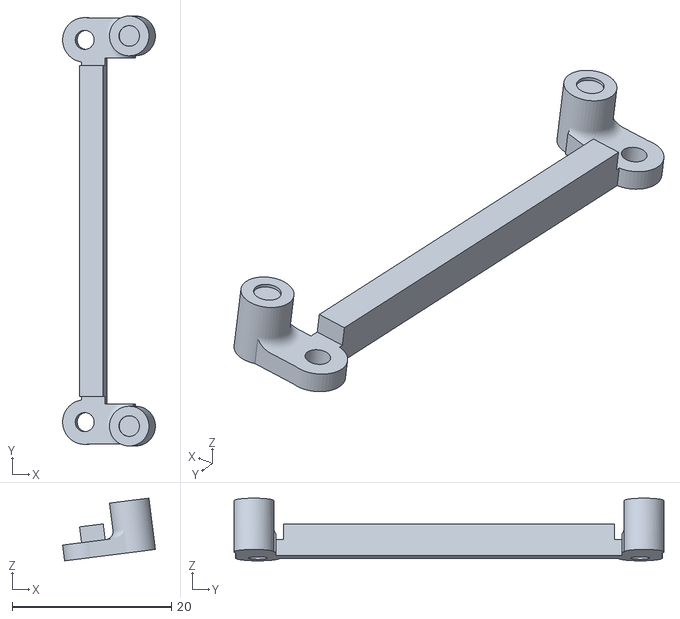
[picture p35: CAD file, 2026-11-07]
hardware/cad/stl/head_compute_clamp.stl
11.7 x 54.0 x 7.88
