lachlanhurst/dukki/hardware/cad/stl/face_part.stl

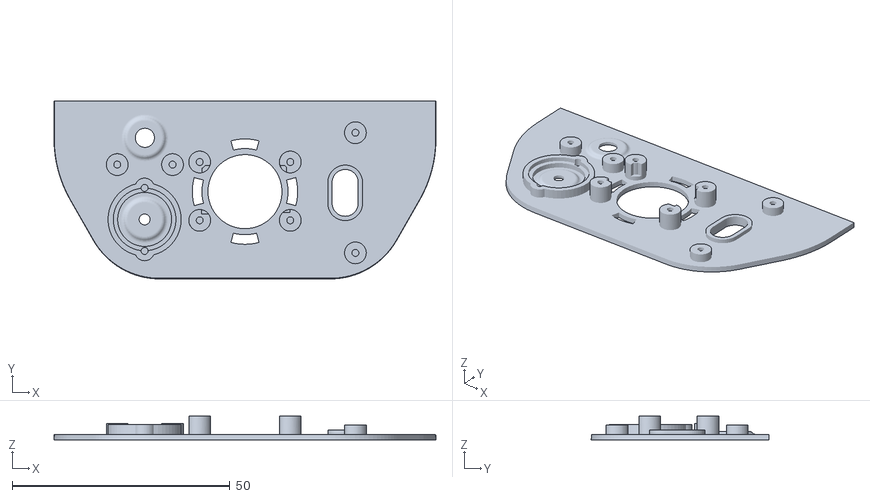
[picture p36: CAD file, 2026-11-07]
hardware/cad/stl/face_part.stl
87.7 x 40.9 x 5.50
