lachlanhurst/dukki/hardware/cad/stl/jaw_soft.stl

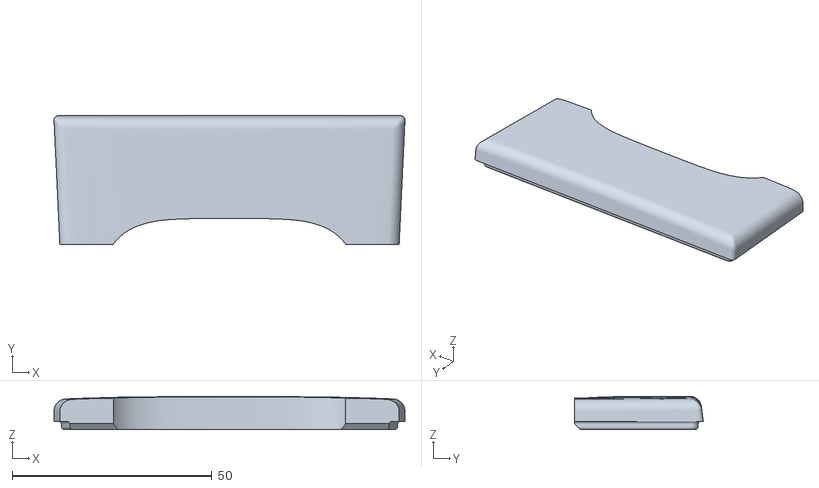
[picture p37: CAD file, 2026-11-07]
hardware/cad/stl/jaw_soft.stl
87.9 x 32.2 x 8.38
