lachlanhurst/dukki/hardware/cad/stl/yaw_roll_motion.stl

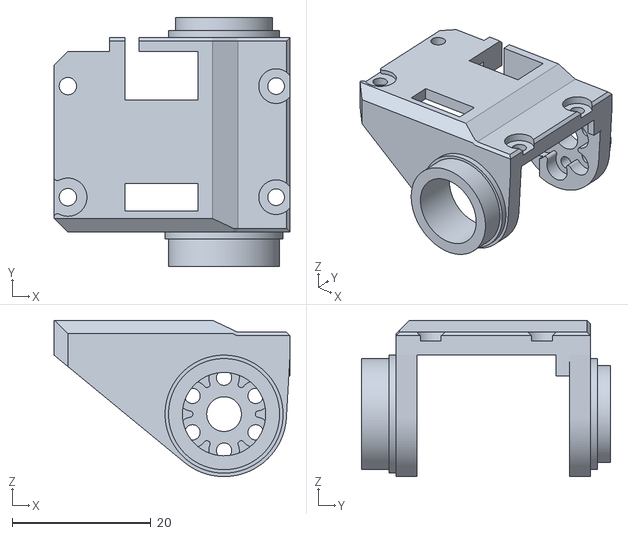
[picture p38: CAD file, 2026-11-07]
hardware/cad/stl/yaw_roll_motion.stl
34.0 x 35.9 x 22.5
