lachlanhurst/dukki/hardware/cad/stl/soft_mouth_top.stl

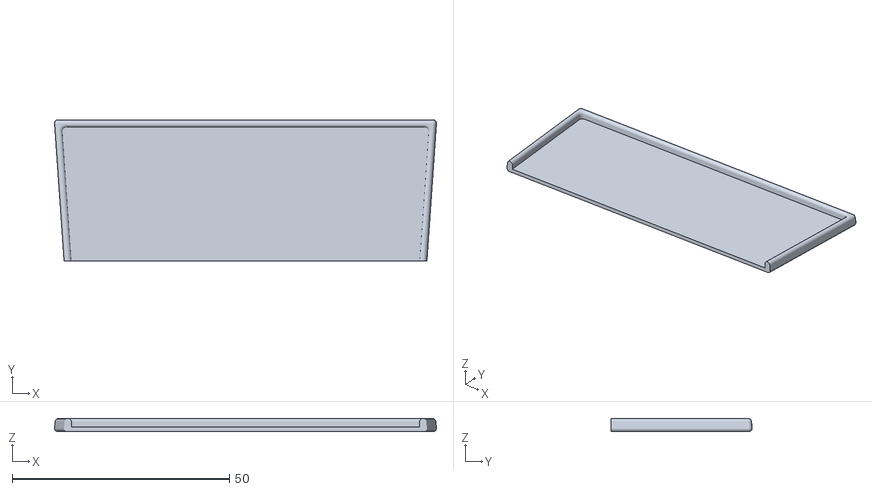
[picture p39: CAD file, 2026-11-07]
hardware/cad/stl/soft_mouth_top.stl
88.0 x 32.5 x 3.00
