lachlanhurst/dukki/hardware/cad/stl/left_shell_mirrored.stl

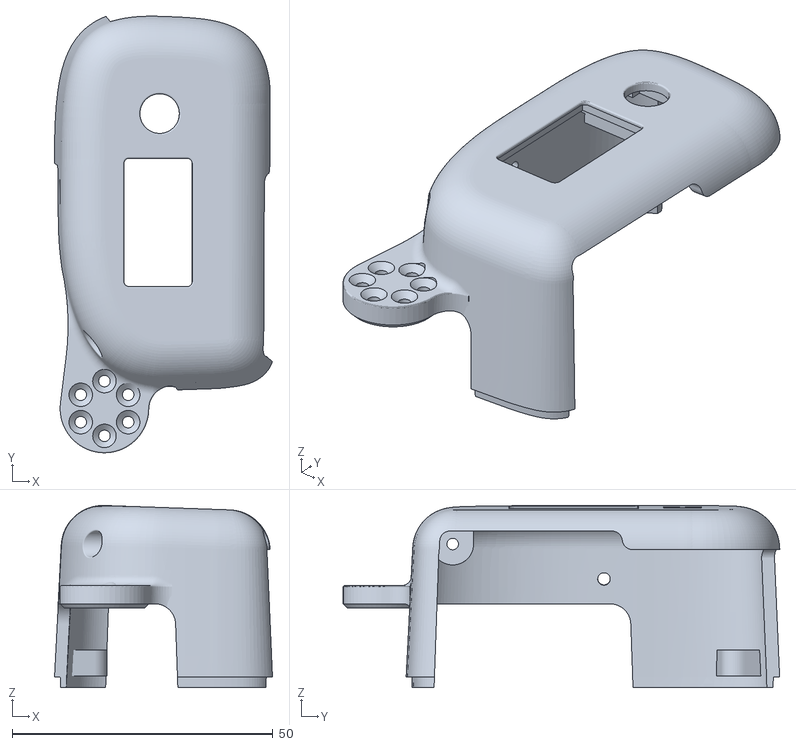
[picture p40: CAD file, 2026-11-07]
hardware/cad/stl/left_shell_mirrored.stl
41.8 x 83.7 x 34.9
