lachlanhurst/dukki/hardware/cad/stl/foot_ankle_left.stl

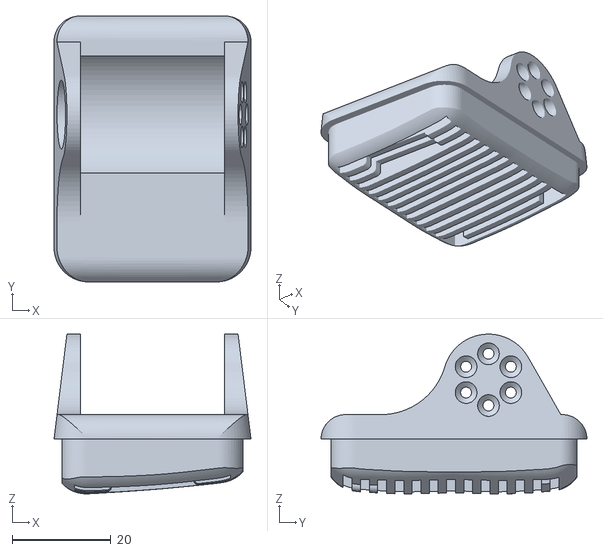
[picture p41: CAD file, 2026-11-07]
hardware/cad/stl/foot_ankle_left.stl
40.0 x 54.0 x 32.4
