lachlanhurst/dukki/hardware/cad/stl/head_compute_front_clamp.stl

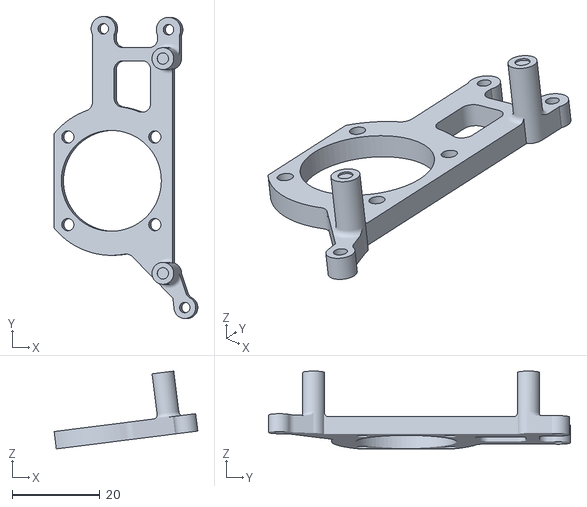
[picture p42: CAD file, 2026-11-07]
hardware/cad/stl/head_compute_front_clamp.stl
32.8 x 68.9 x 17.8
