lachlanhurst/dukki/(list of files, cad)

Other CAD files:
hardware/cad/stl/left_upper_leg.stl
hardware/cad/stl/upper_leg_rigidity_plate.stl
hardware/cad/stl/sole_left.stl
hardware/cad/stl/foot_ankle_left_mirrored.stl
