lachlanhurst/dukki/hardware/head/head-layout.pdf

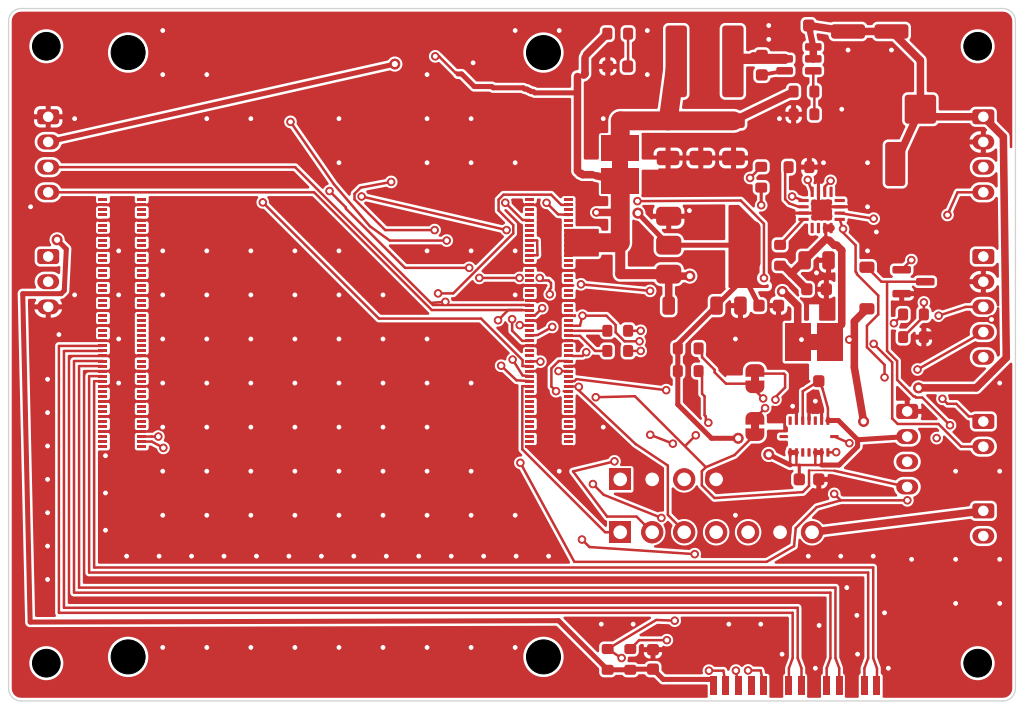
[picture p44: page 1]
D Date:; KiCad E.D.A. 10.0.6; Size: A4; Rev:; Title:; File: head.kicad_pcb; Sheet:

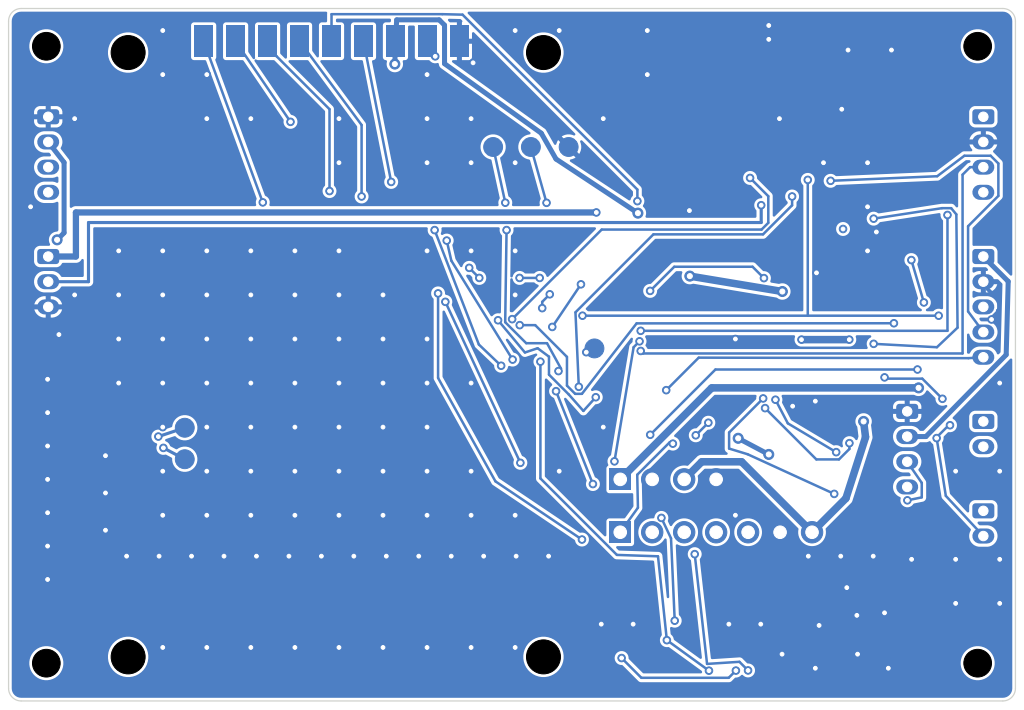
[picture p45: page 2]
D Date:; Title:; File: head.kicad_pcb; Sheet:

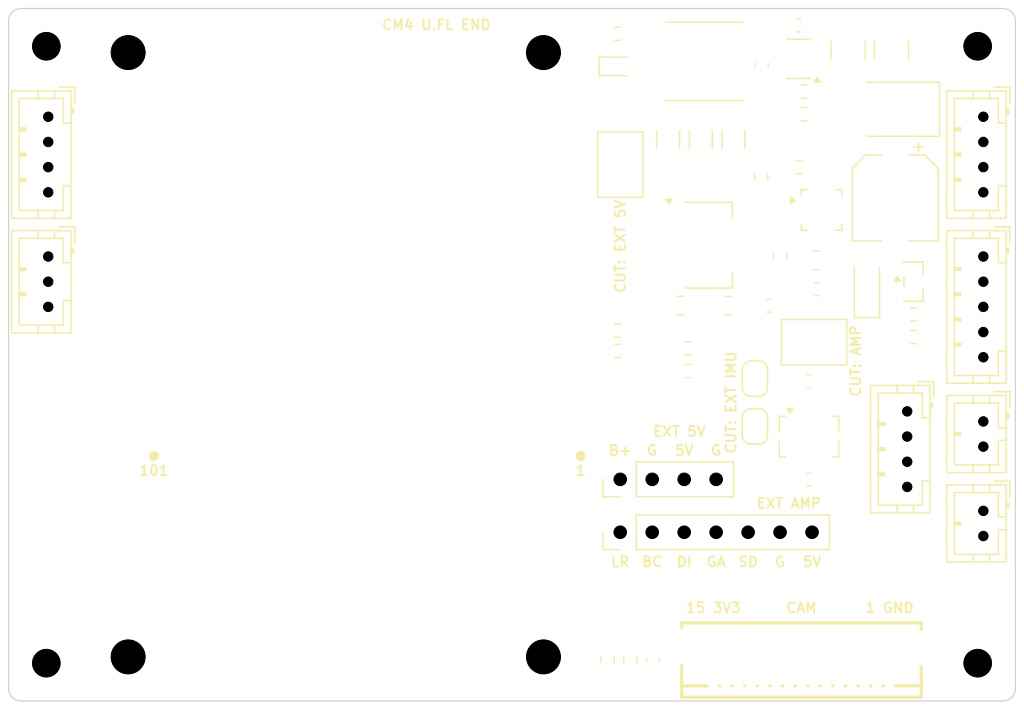
[picture p46: page 3]
D Date:; Title:; File: head.kicad_pcb; Sheet:; CM4 U.FL END; EXT 5V 5VDI15 3V3 G; EXT AMP; CAM; 1 GND CUT: EXT 5V; CUT: EXT IMU; CUT: AMP

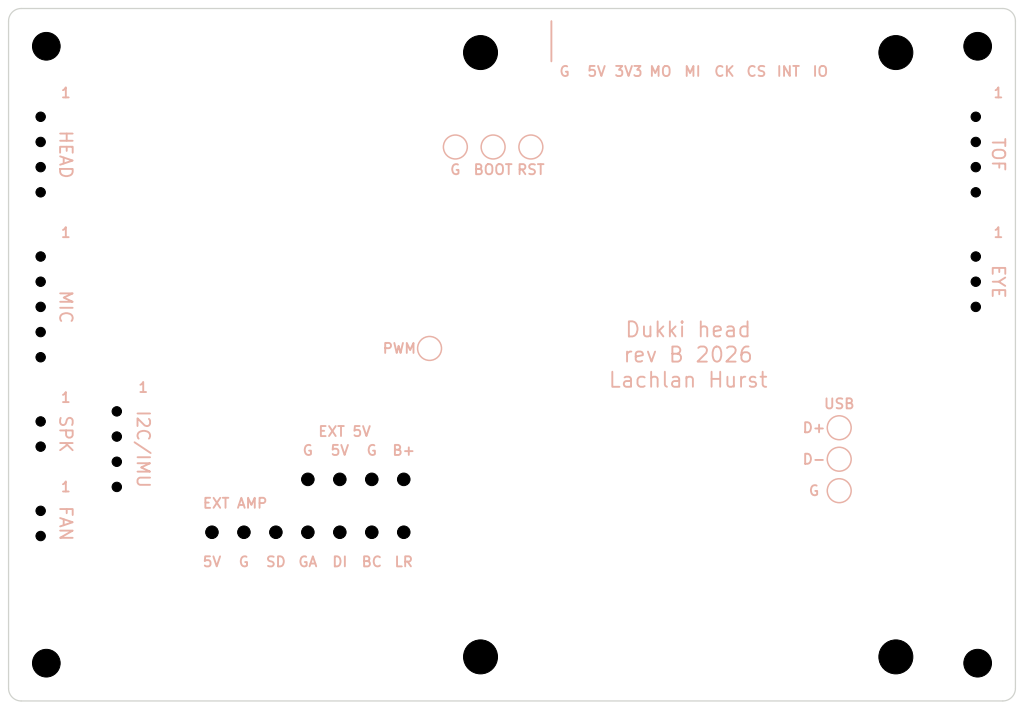
[picture p47: page 4]
D Date:; Title:; File: head.kicad_pcb; Sheet:; 1 USB; G BOOT RST B+; PWM; EXT 5V 5VDI G; TOF EYE I2C/IMU HEAD MIC SPK FAN; Dukki head; rev B 2026

Lachlan Hurst G 5V 3V3 MO MI CK CS INT IO

G SD GA EXT AMP

R6 C4

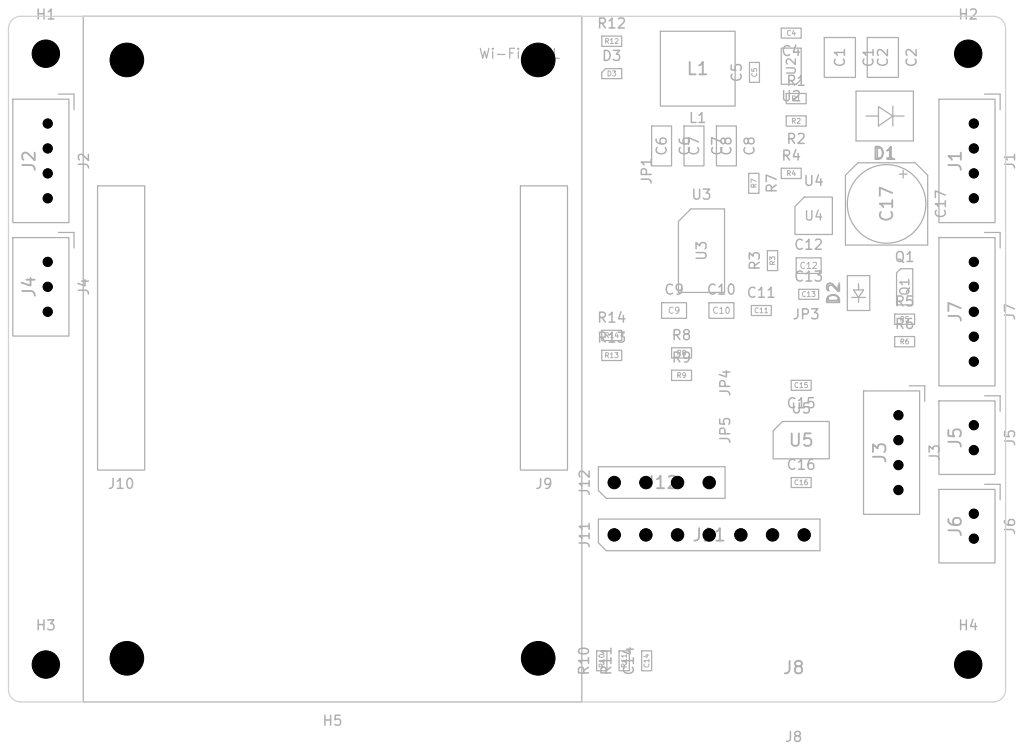
[picture p48: page 5]

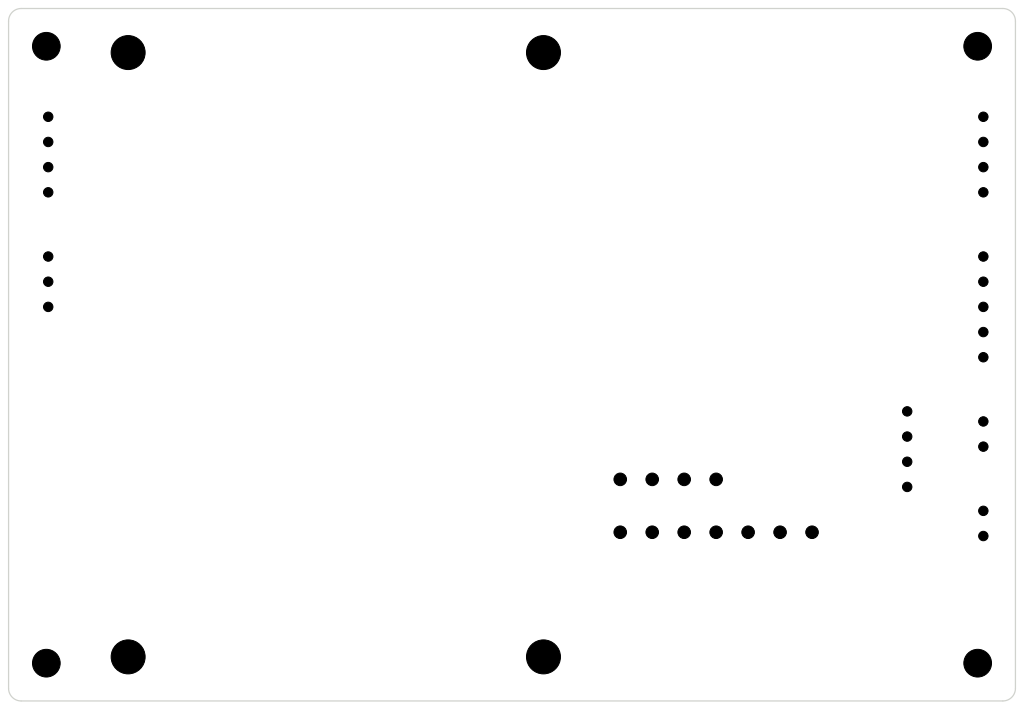
[picture p49: page 6]
D Date:; Title:; File: head.kicad_pcb; Sheet:
