lachlanhurst/dukki/hardware/head/head-schematic.pdf

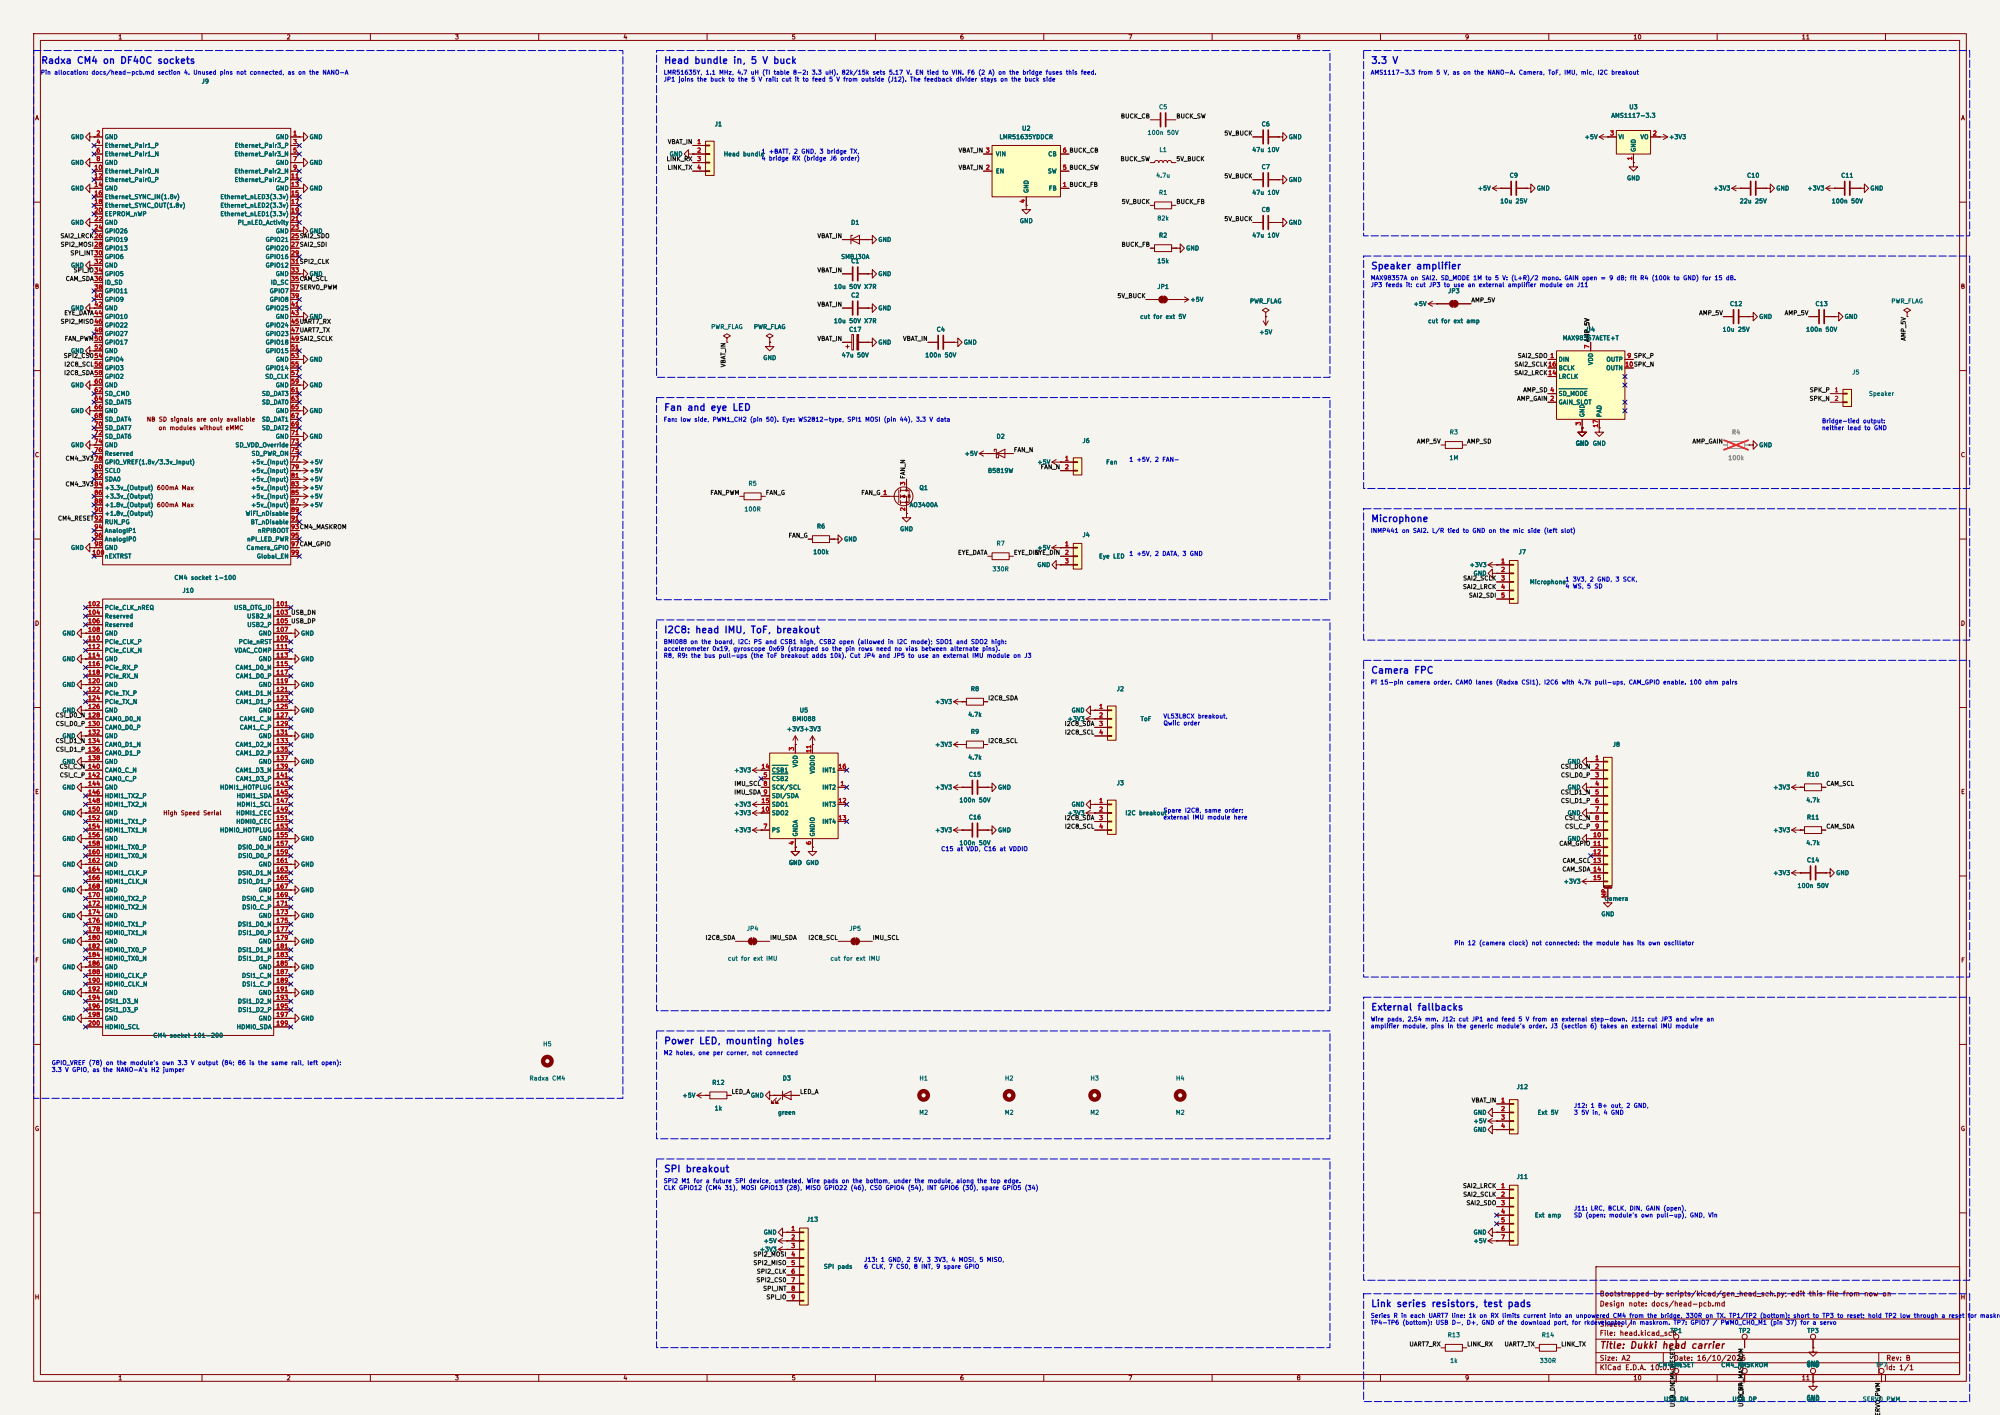
[picture p50: page 1]

Head bundle in, 5 V buck

Pin allocation: docs/head-pcb.md section 4. Unused pins not connected, as on the NANO-A

LMR51635Y, 1.1 MHz, 4.7 uH (TI table 8-2: 3.3 uH). 82k/15k sets 5.17 V. EN tied to VIN. F6 (2 A) on the bridge fuses this feed. JP1 joins the buck to the 5 V rail: cut it to feed 5 V from outside (J12). The feedback divider stays on the buck side

AMS1117-3.3 from 5 V, as on the NANO-A. Camera, ToF, IMU, mic, I2C breakout

47u 10V GND
1 +BATT, 2 GND, 3 bridge TX, 4 bridge RX (bridge J6 order)

cut for ext amp +5V 1

Fan and eye LED

600mA Max 600mA Max NB SD signals are only available on modules without eMMC

Fan: low side, PWM1_CH2 (pin 50). Eye: WS2812-type, SPI1 MOSI (pin 44), 3.3 V data

Bridge-tied output: neither lead to GND

INMP441 on SAI2. L/R tied to GND on the mic side (left slot)

1 3V3, 2 GND, 3 SCK, 4 WS, 5 SD

I2C8: head IMU, ToF, breakout

BMI088 on the board, I2C: PS and CSB1 high, CSB2 open (allowed in I2C mode); SDO1 and SDO2 high: accelerometer 0x19, gyroscope 0x69 (strapped so the pin rows need no vias between alternate pins).

R8, R9: the bus pull-ups (the ToF breakout adds 10k). Cut JP4 and JP5 to use an external IMU module on J3

Pi 15-pin camera order. CAM0 lanes (Radxa CSI1), I2C6 with 4.7k pull-ups, CAM_GPIO enable. 100 ohm pairs Pin 12 (camera clock) not connected: the module has its own oscillator

Spare I2C8, same order; external IMU module here

C15 at VDD, C16 at VDDIO

cut for ext IMU

J12: 1 B+ out, 2 GND, 3 5V in, 4 GND External fallbacks

Wire pads, 2.54 mm. J12: cut JP1 and feed 5 V from an external step-down. J11: cut JP3 and wire an
amplifier module, pins in the generic module's order. J3 (section 6) takes an external IMU module

Power LED, mounting holes

M2 holes, one per corner, not connected

GPIO_VREF (78) on the module's own 3.3 V output (84; 86 is the same rail, left open): 3.3 V GPIO, as the NANO-A's H2 jumper

SPI2 M1 for a future SPI device, untested. Wire pads on the bottom, under the module, along the top edge. CLK GPIO12 (CM4 31), MOSI GPIO13 (28), MISO GPIO22 (46), CS0 GPIO4 (54), INT GPIO6 (30), spare GPIO5 (34)

J11: LRC, BCLK, DIN, GAIN (open), SD (open: module's own pull-up), GND, Vin

J13: 1 GND, 2 5V, 3 3V3, 4 MOSI, 5 MISO, 6 CLK, 7 CS0, 8 INT, 9 spare GPIO

Bootstrapped by scripts/kicad/gen_head_sch.py; edit this file from now on

R13 | Design note: docs/head-pcb.md

Sheet: /
File: head.kicad_sch
Title: Dukki head carrier

Size: A2 | Rev: B
TP6 TP6 TP7 KiCad E.D.A. 10.0.6 | Id: 1/1
