lachlanhurst/dukki/hardware/head_ext/head_ext-layout.pdf

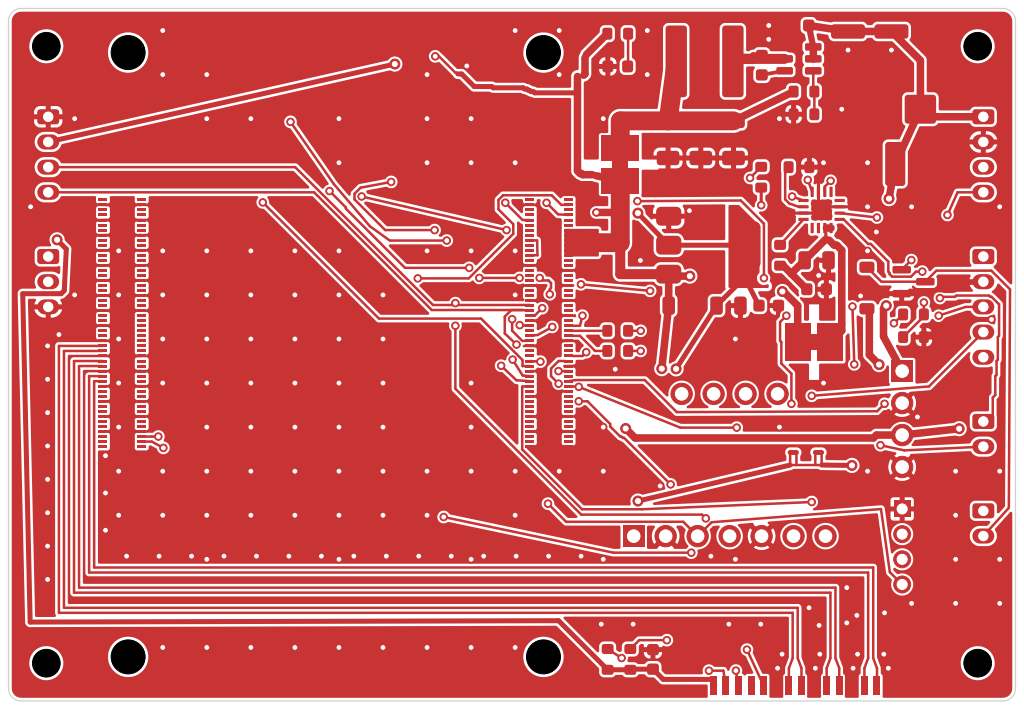
[picture p51: page 1]
D Date:; KiCad E.D.A. 10.0.6; Size: A4; Rev:; Title:; File: head_ext.kicad_pcb; Sheet:

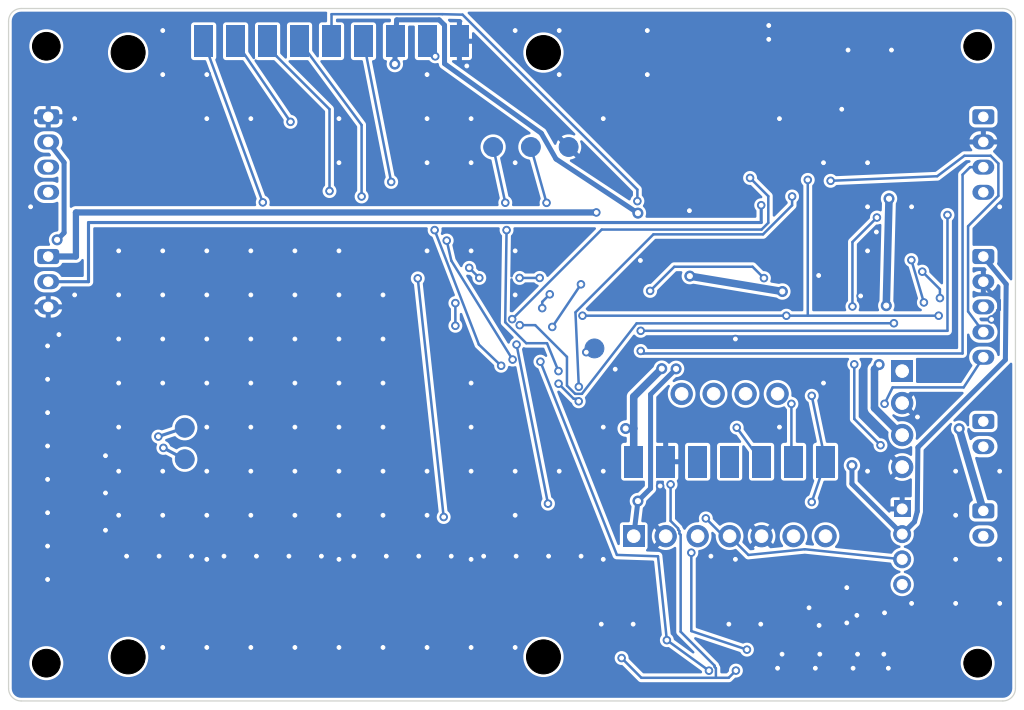
[picture p52: page 2]
D Date:; Title:; File: head_ext.kicad_pcb; Sheet:

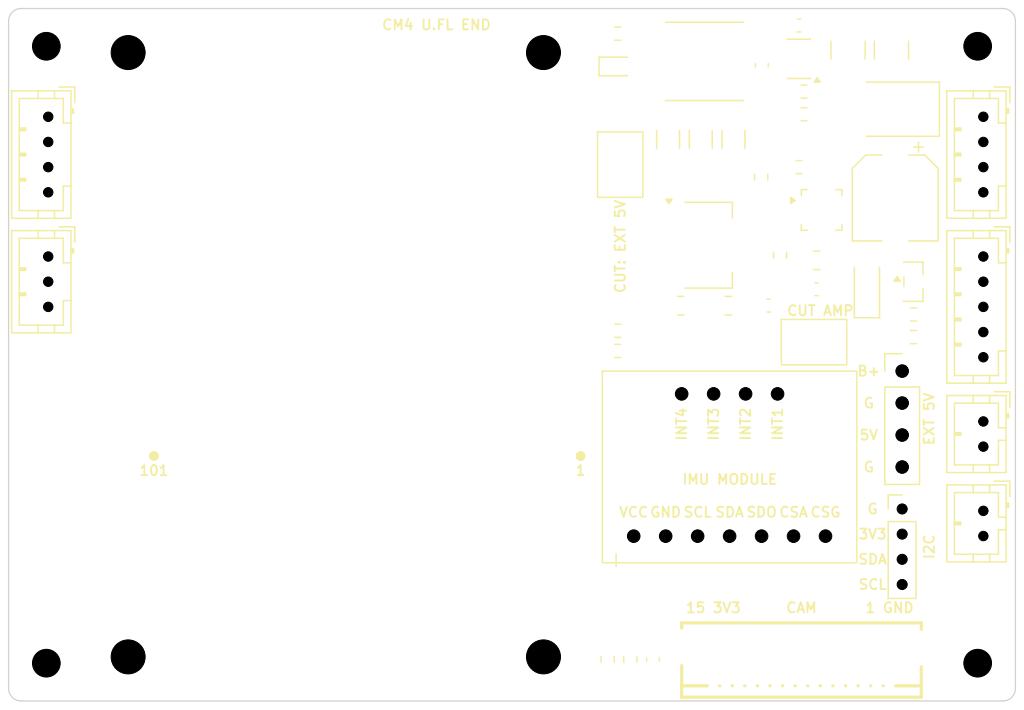
[picture p53: page 3]
D Date:; Title:; File: head_ext.kicad_pcb; Sheet:; CM4 U.FL END; SDA; CUT AMP; CSG; SDA SCL 1 GND CUT: EXT 5V; INT4; INT3; INT2; INT1; EXT 5V I2C

IMU MODULE SDO CSA CAM

VCC GND SCL 15 3V3

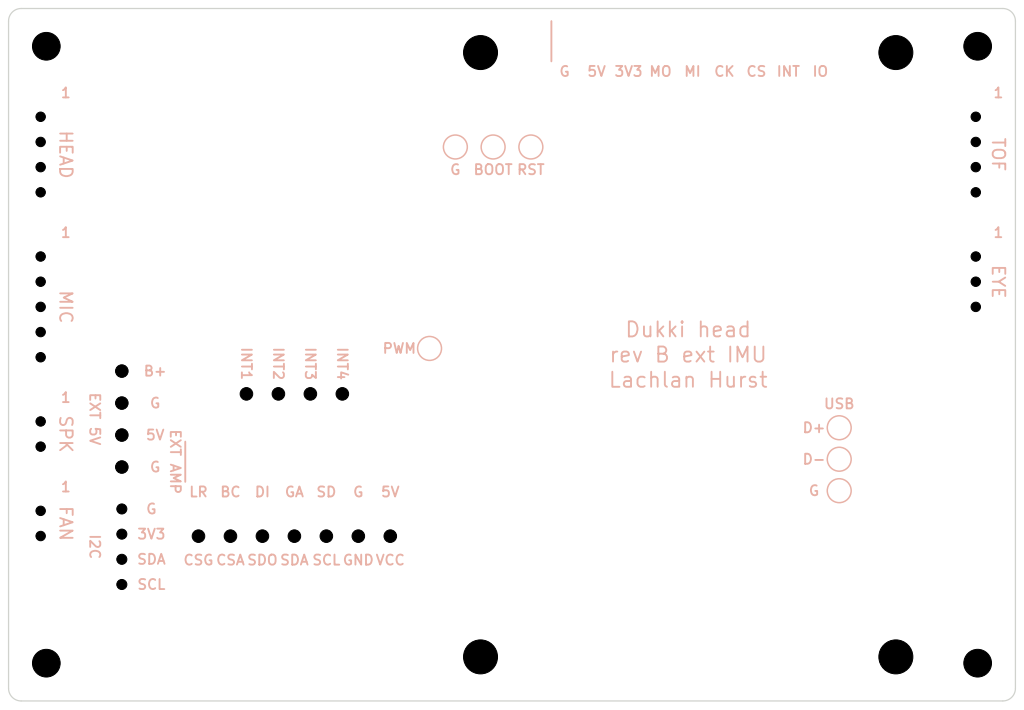
[picture p54: page 4]
D Date:; Title:; File: head_ext.kicad_pcb; Sheet:; 1 USB; SDA SCL 1; INT1; INT2; INT3; INT4 EXT AMP EXT 5V I2C; TOF EYE HEAD MIC SPK FAN; Dukki head

Lachlan Hurst G 5V 3V3 MO MI CK CS INT IO

G BOOT RST PWM

rev B ext IMU

CSG CSA SDO SDA SCL GND VCC

R6 C4
R4 | C1 | C1 C17 | C17 J3J3

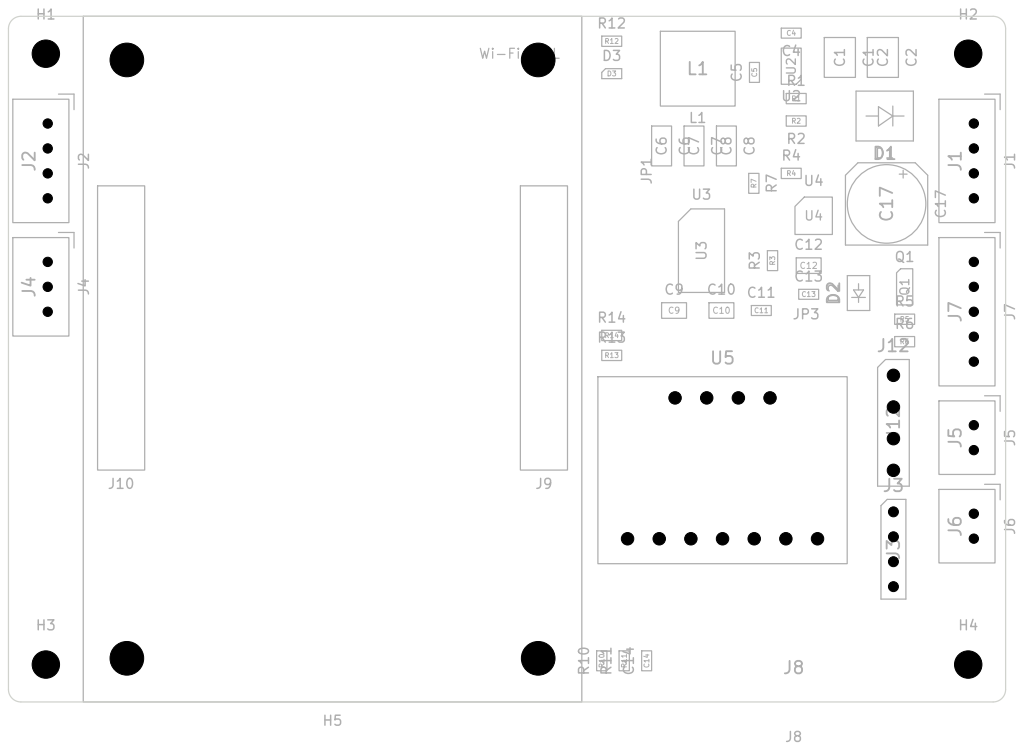
[picture p55: page 5]

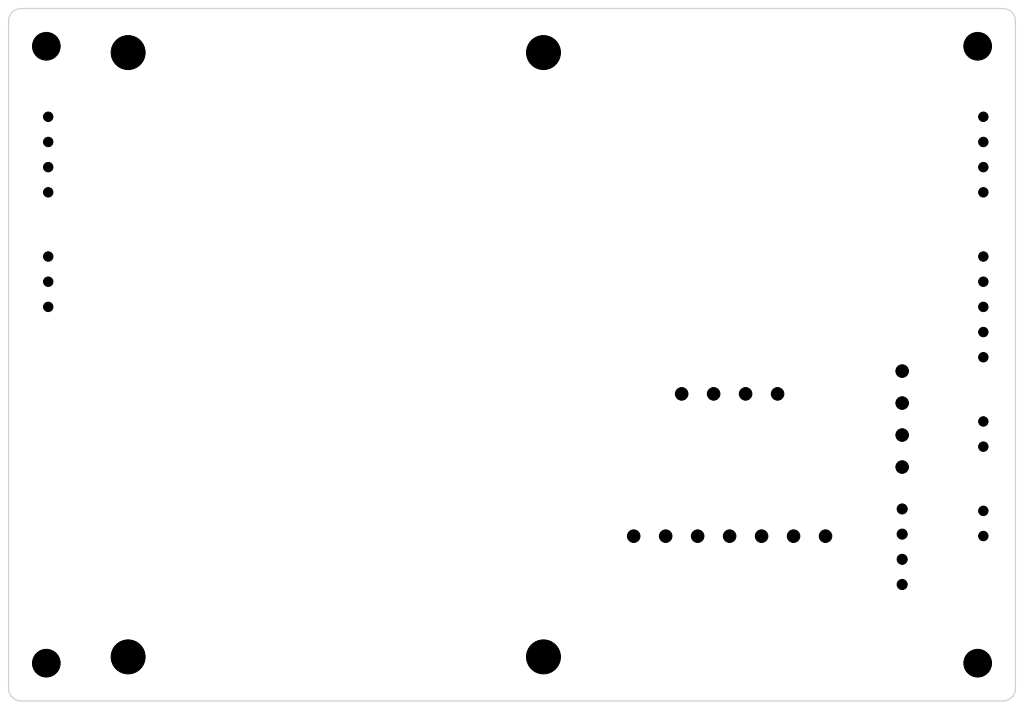
[picture p56: page 6]
D Date:; Title:; File: head_ext.kicad_pcb; Sheet:
