lachlanhurst/dukki/hardware/head_ext/head_ext-schematic.pdf

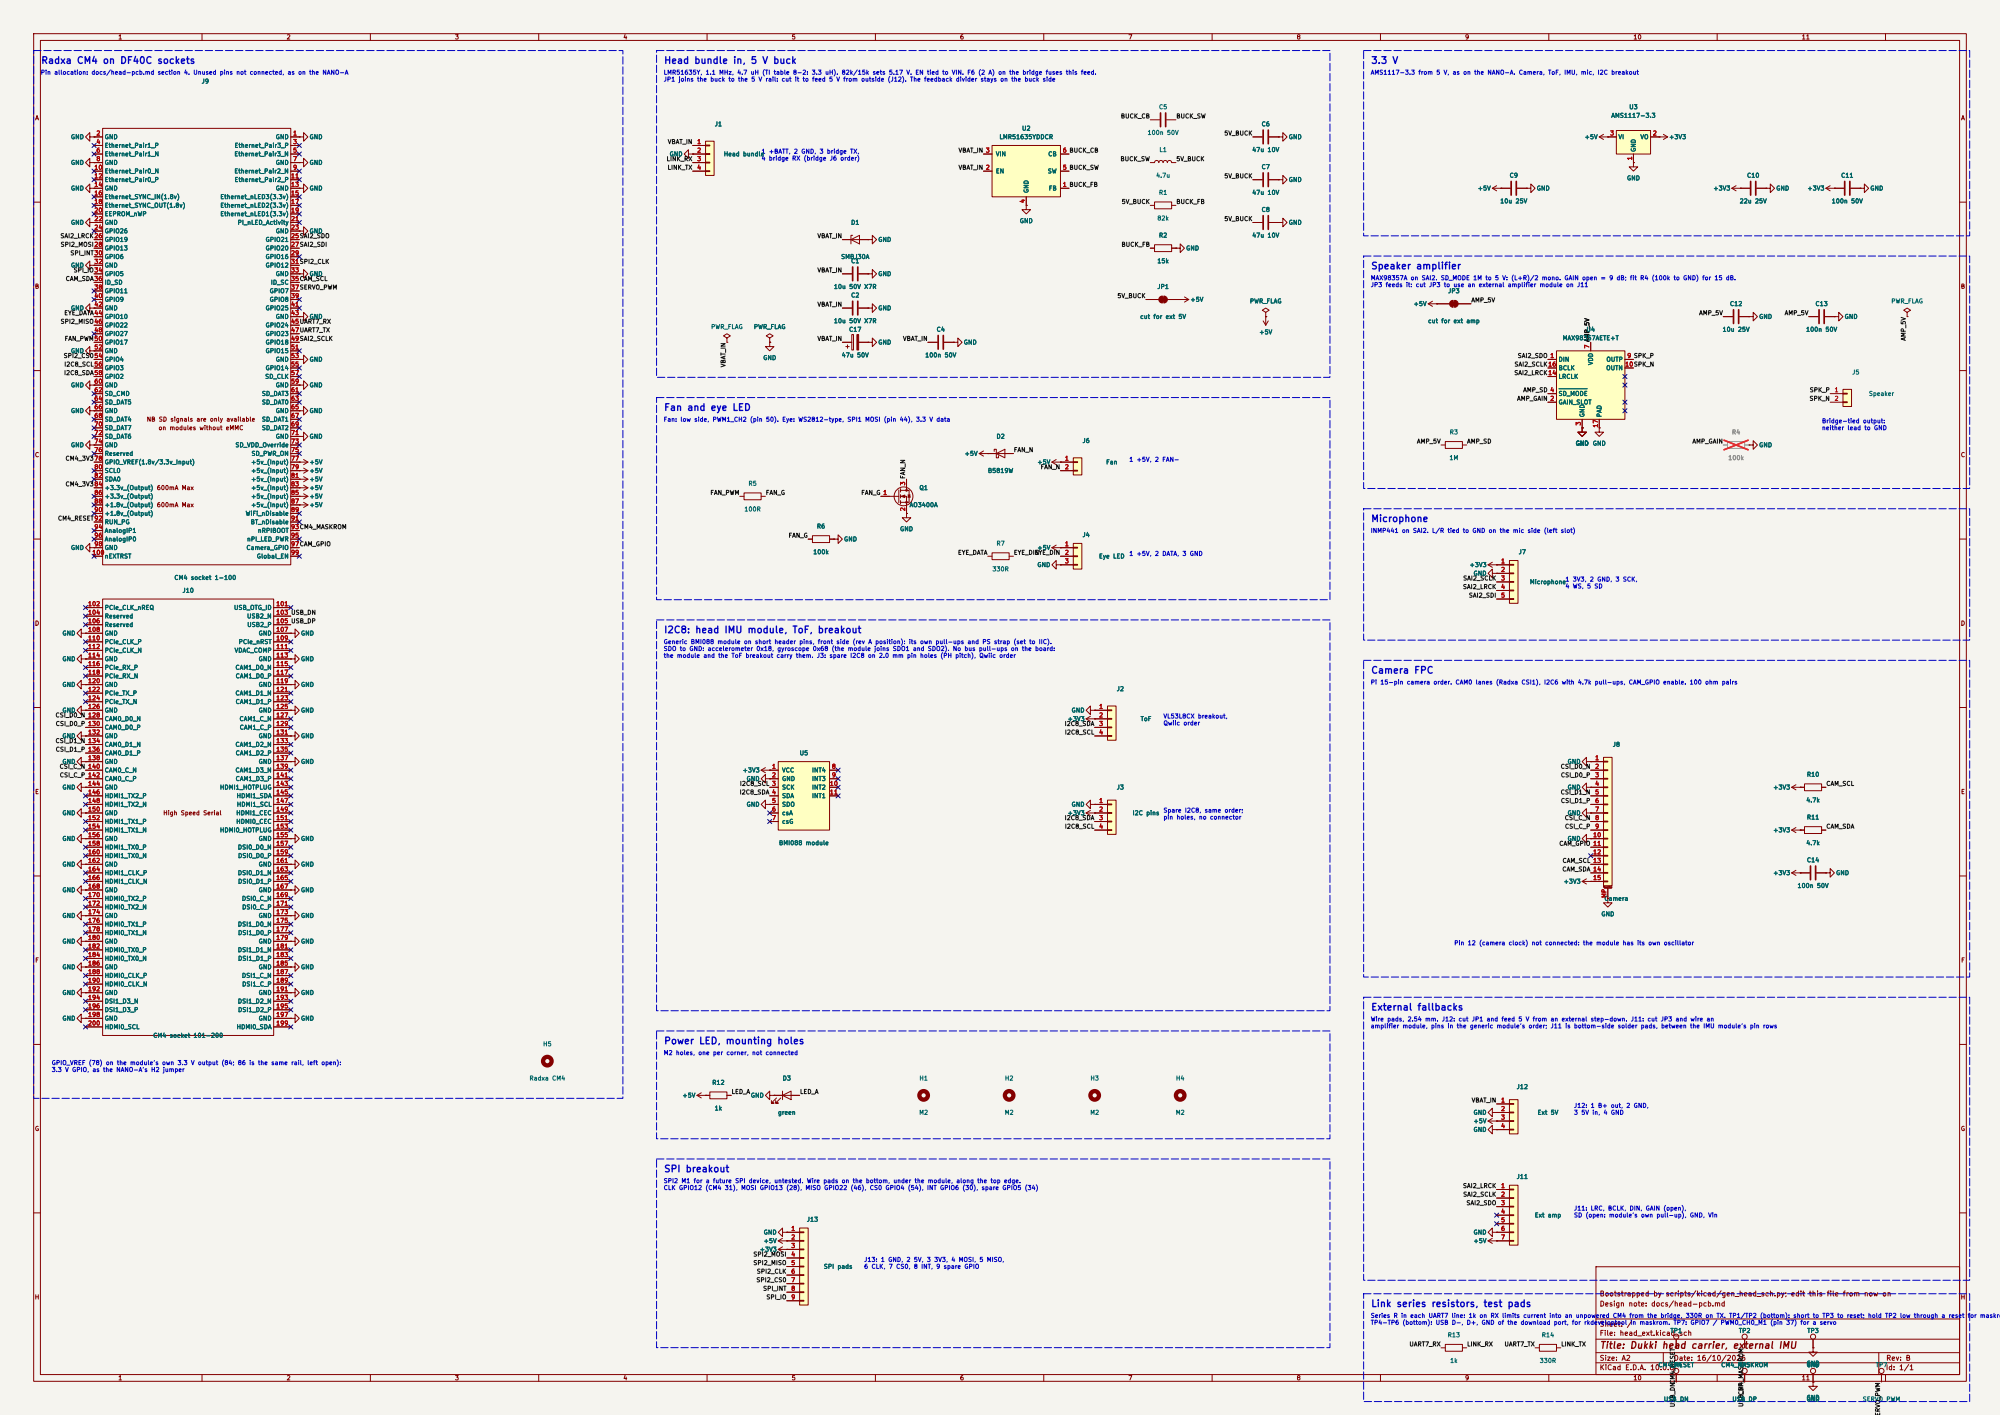
[picture p57: page 1]

1 +5V, 2 FAN- Radxa CM4 on DF40C sockets

Head bundle in, 5 V buck
LMR51635Y, 1.1 MHz, 4.7 uH (TI table 8-2: 3.3 uH). 82k/15k sets 5.17 V. EN tied to VIN. F6 (2 A) on the bridge fuses this feed. JP1 joins the buck to the 5 V rail: cut it to feed 5 V from outside (J12). The feedback divider stays on the buck side

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

1 +BATT, 2 GND, 3 bridge TX, 4 bridge RX (bridge J6 order)

Speaker amplifier
MAX98357A on SAI2. SD_MODE 1M to 5 V: (L+R)/2 mono. GAIN open = 9 dB; fit R4 (100k to GND) for 15 dB. JP3 feeds it: cut JP3 to use an external amplifier module on J11
cut for ext amp R3

600mA Max 600mA Max NB SD signals are only available on modules without eMMC

Fan: low side, PWM1_CH2 (pin 50). Eye: WS2812-type, SPI1 MOSI (pin 44), 3.3 V data Generic BMI088 module on short header pins, front side (rev A position): its own pull-ups and PS strap (set to IIC). SDO to GND: accelerometer 0x18, gyroscope 0x68 (the module joins SDO1 and SDO2). No bus pull-ups on the board: the module and the ToF breakout carry them. J3: spare I2C8 on 2.0 mm pin holes (PH pitch), Qwiic order

Bridge-tied output: neither lead to GND

Microphone
INMP441 on SAI2. L/R tied to GND on the mic side (left slot)

1 3V3, 2 GND, 3 SCK, 4 WS, 5 SD

pin holes, no connector I2C8: head IMU module, ToF, breakout M2 holes, one per corner, not connected

Camera FPC
Pi 15-pin camera order. CAM0 lanes (Radxa CSI1), I2C6 with 4.7k pull-ups, CAM_GPIO enable. 100 ohm pairs

Pin 12 (camera clock) not connected: the module has its own oscillator

GND
amplifier module, pins in the generic module's order; J11 is bottom-side solder pads, between the IMU module's pin rows GPIO_VREF (78) on the module's own 3.3 V output (84; 86 is the same rail, left open): 3.3 V GPIO, as the NANO-A's H2 jumper

Power LED, mounting holes

J12: 1 B+ out, 2 GND, 3 5V in, 4 GND

SPI breakout
SPI2 M1 for a future SPI device, untested. Wire pads on the bottom, under the module, along the top edge. CLK GPIO12 (CM4 31), MOSI GPIO13 (28), MISO GPIO22 (46), CS0 GPIO4 (54), INT GPIO6 (30), spare GPIO5 (34)

J11: LRC, BCLK, DIN, GAIN (open), SD (open: module's own pull-up), GND, Vin Link series resistors, test pads

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

Bootstrapped by scripts/kicad/gen_head_sch.py; edit this file from now on

Series R in each UART7 line: 1k on RX limits current into an unpowered CM4 from the bridge, 330R on TX. TP1/TP2 (bottom): short to TP3 to reset; hold TP2 low through a reset for maskrom. TP4-TP6 (bottom): USB D-, D+, GND of the download port, for rkdeveloptool in maskrom. TP7: GPIO7 / PWM0_CH0_M1 (pin 37) for a servo R13 | Design note: docs/head-pcb.md

Sheet: /
File: head_ext.kicad_sch
Title: Dukki head carrier, external IMU

Size: A2 | Rev: B
TP7 KiCad E.D.A. 10.0.6 | Id: 1/1
