lachlanhurst/dukki/hardware/bridge/bridge-layout.pdf

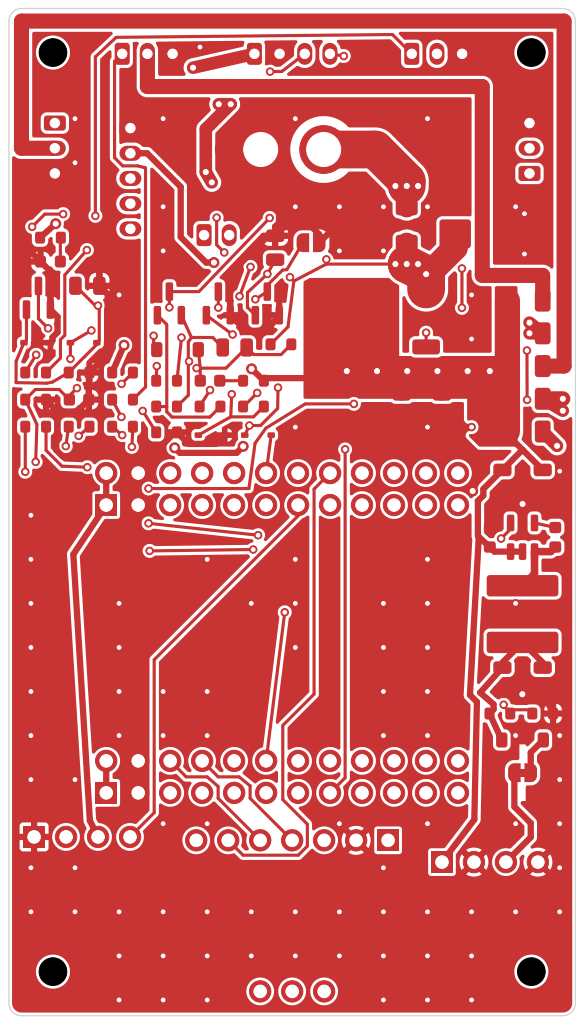
[picture p58: page 1]

Size: A4 | Rev:
KiCad E.D.A. 10.0.6 | Id: 1/5

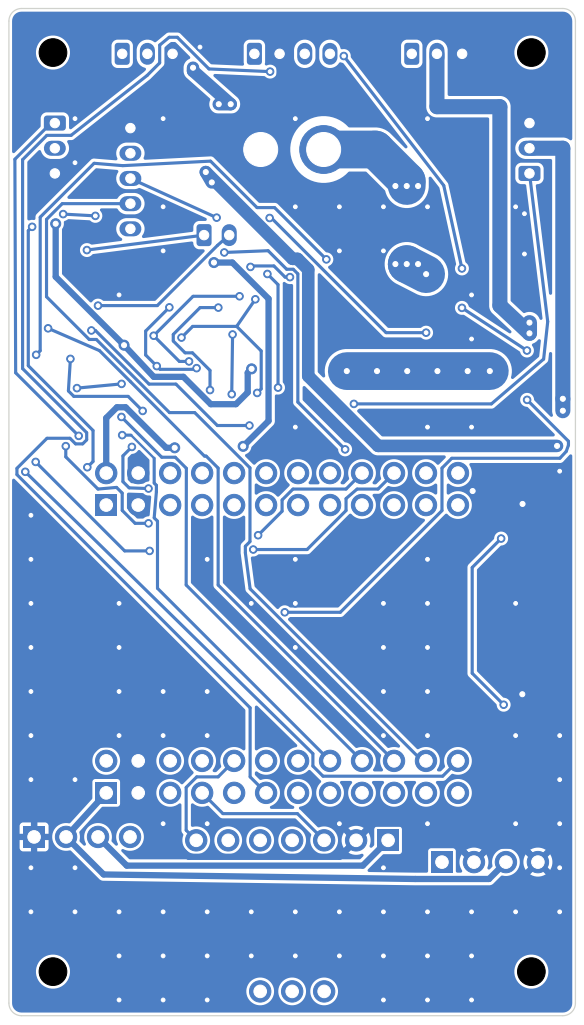
[picture p59: page 2]

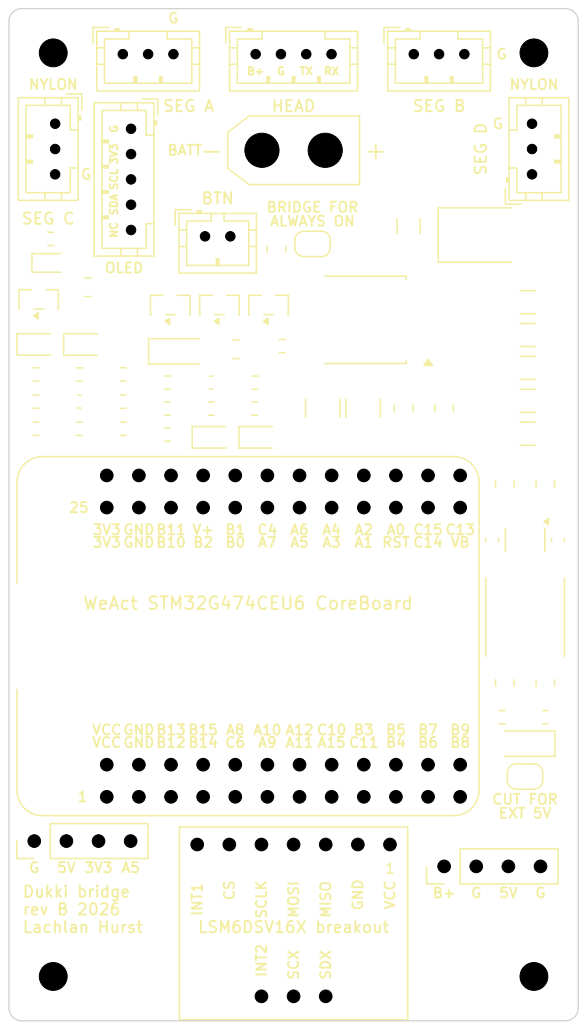
[picture p60: page 3]

5V CUT FOR EXT 5V NYLON

SEG B SEG D WeAct STM32G474CEU6 CoreBoard

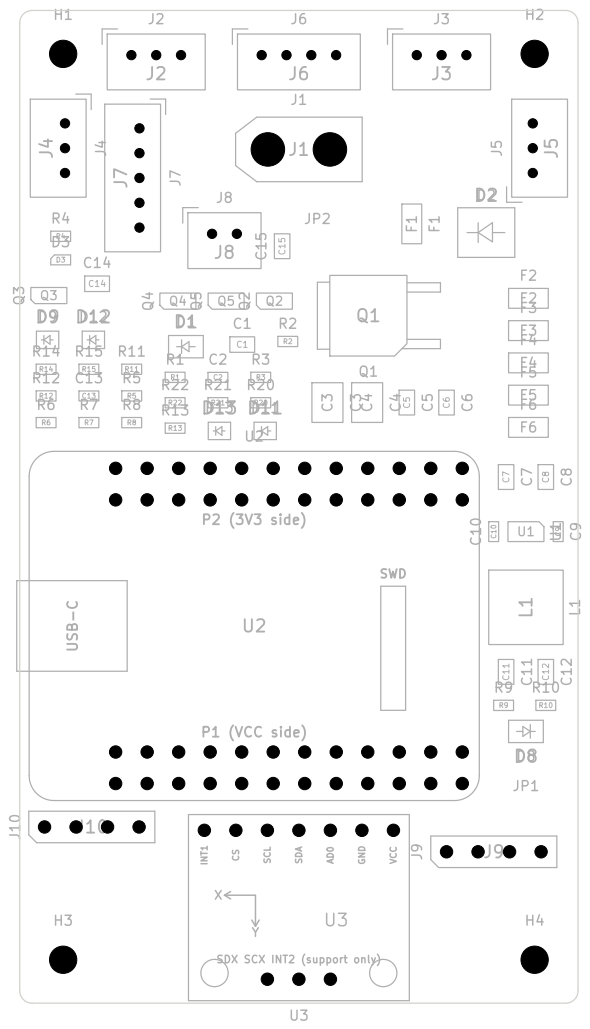
[picture p61: page 4]

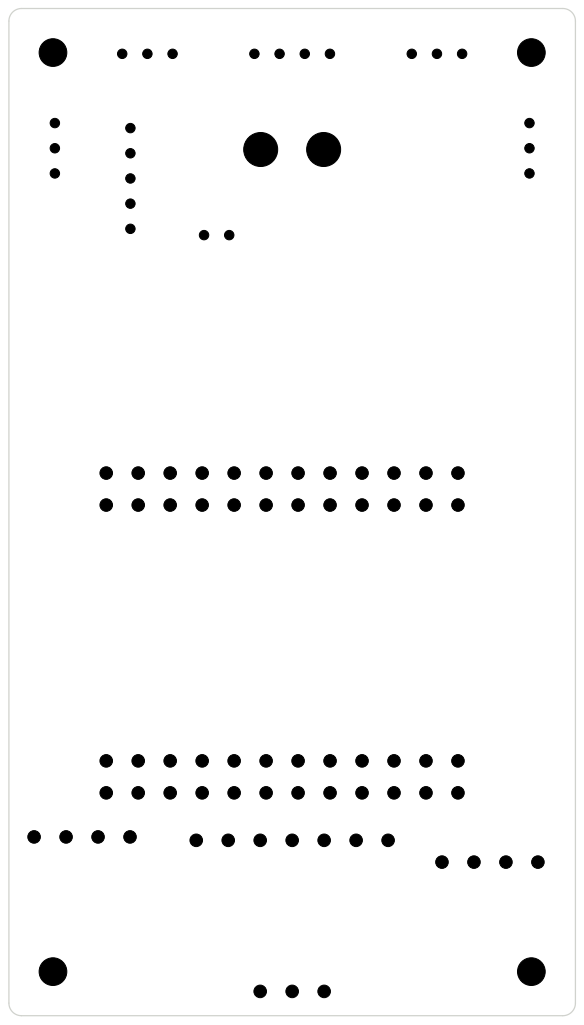
[picture p62: page 5]
