lachlanhurst/dukki/hardware/bridge/bridge-schematic.pdf

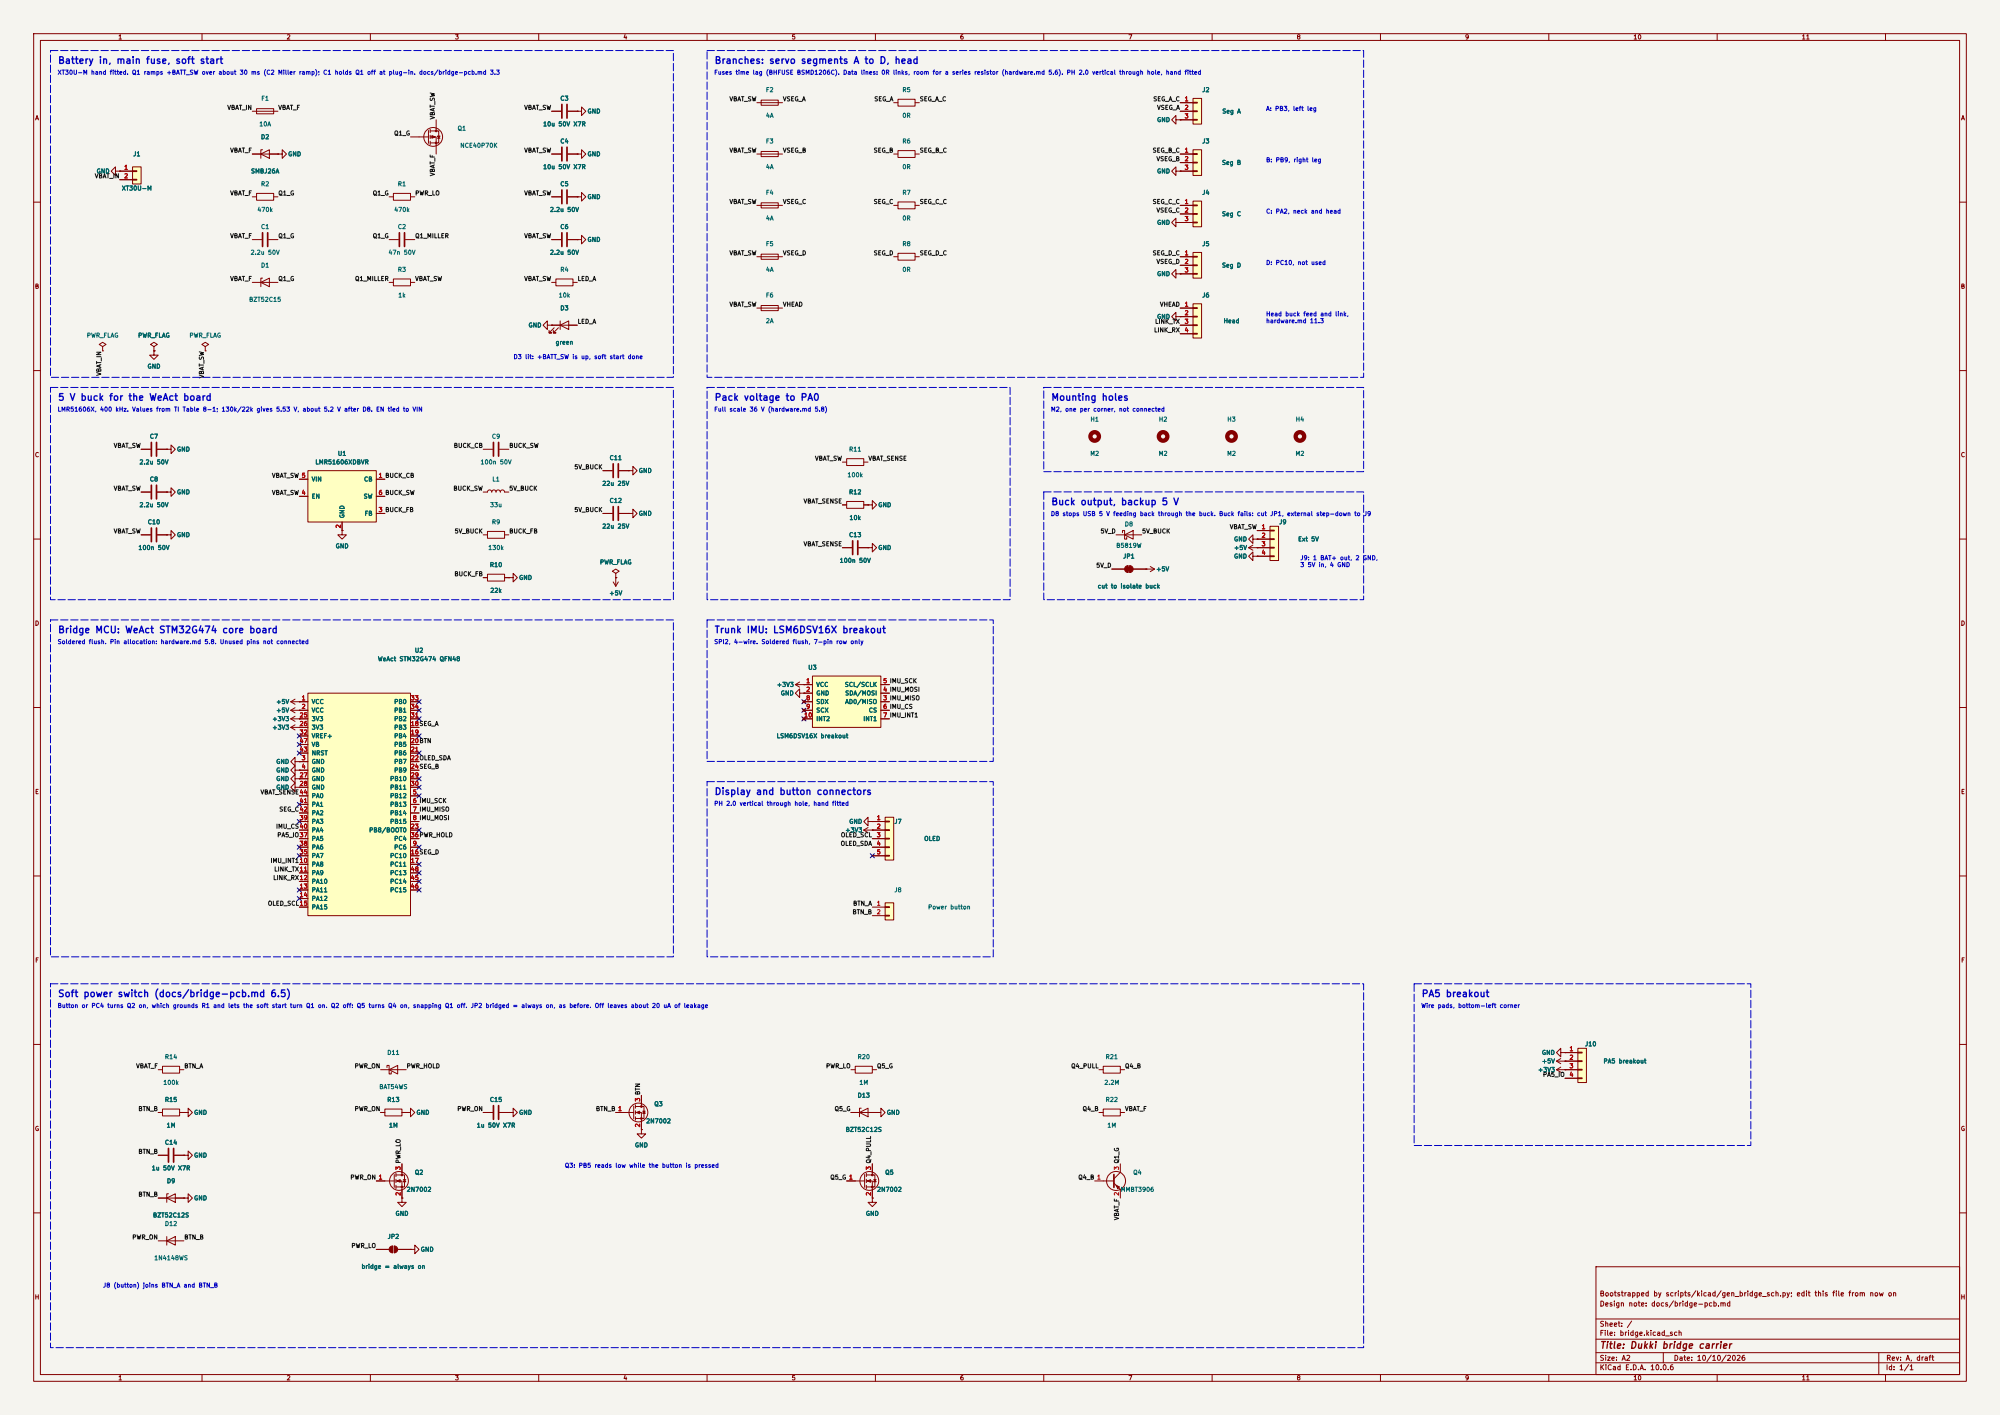
[picture p63: page 1]

C: PA2, neck and head Branches: servo segments A to D, head

B: PB9, right leg D: PC10, not used

Head buck feed and link, hardware.md 11.3

D3 lit: +BATT_SW is up, soft start done

LMR51606X, 400 kHz. Values from TI Table 8-1; 130k/22k gives 5.53 V, about 5.2 V after D8. EN tied to VIN

Full scale 36 V (hardware.md 5.8)
M2, one per corner, not connected SPI2, 4-wire. Soldered flush, 7-pin row only

J9: 1 BAT+ out, 2 GND, 3 5V in, 4 GND Buck output, backup 5 V

cut to isolate buck+5V

Bridge MCU: WeAct STM32G474 core board

Trunk IMU: LSM6DSV16X breakout Button or PC4 turns Q2 on, which grounds R1 and lets the soft start turn Q1 on. Q2 off: Q5 turns Q4 on, snapping Q1 off. JP2 bridged = always on, as before. Off leaves about 20 uA of leakage

OLED_SCL Soldered flush. Pin allocation: hardware.md 5.8. Unused pins not connected

PH 2.0 vertical through hole, hand fitted Display and button connectors

Soft power switch (docs/bridge-pcb.md 6.5)

Wire pads, bottom-left corner PA5 breakout

Q3: PB5 reads low while the button is pressed

Bootstrapped by scripts/kicad/gen_bridge_sch.py; edit this file from now on
Design note: docs/bridge-pcb.md

Sheet: /
File: bridge.kicad_sch
Title: Dukki bridge carrier

Size: A2 | Rev: A, draft
KiCad E.D.A. 10.0.6 | Id: 1/1
