lachlanhurst/dukki/hardware/head/head.kicad_pcb

## KiCad design hardware/head/head.kicad_pcb (2026-10-17)

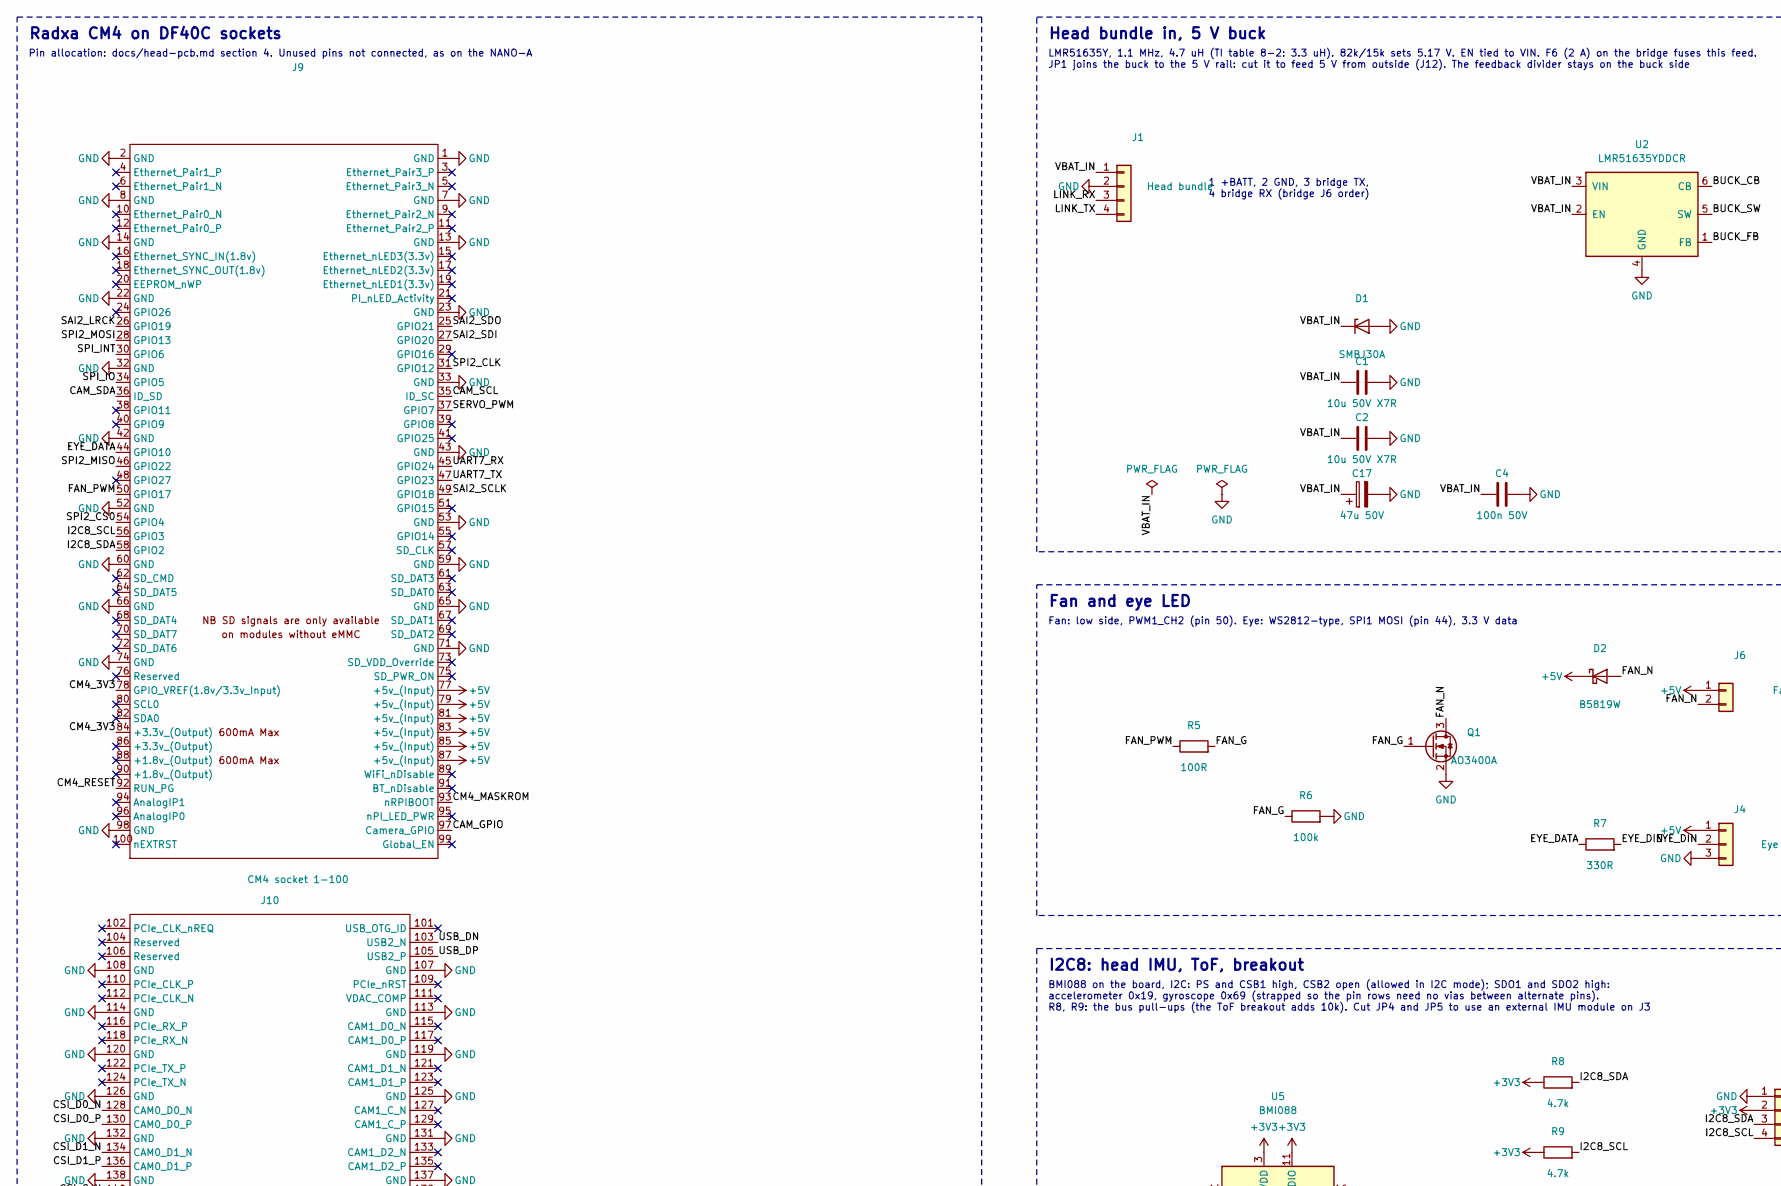
[picture p64: schematic head.kicad_sch, Dukki head carrier, part in row 1, column 1]

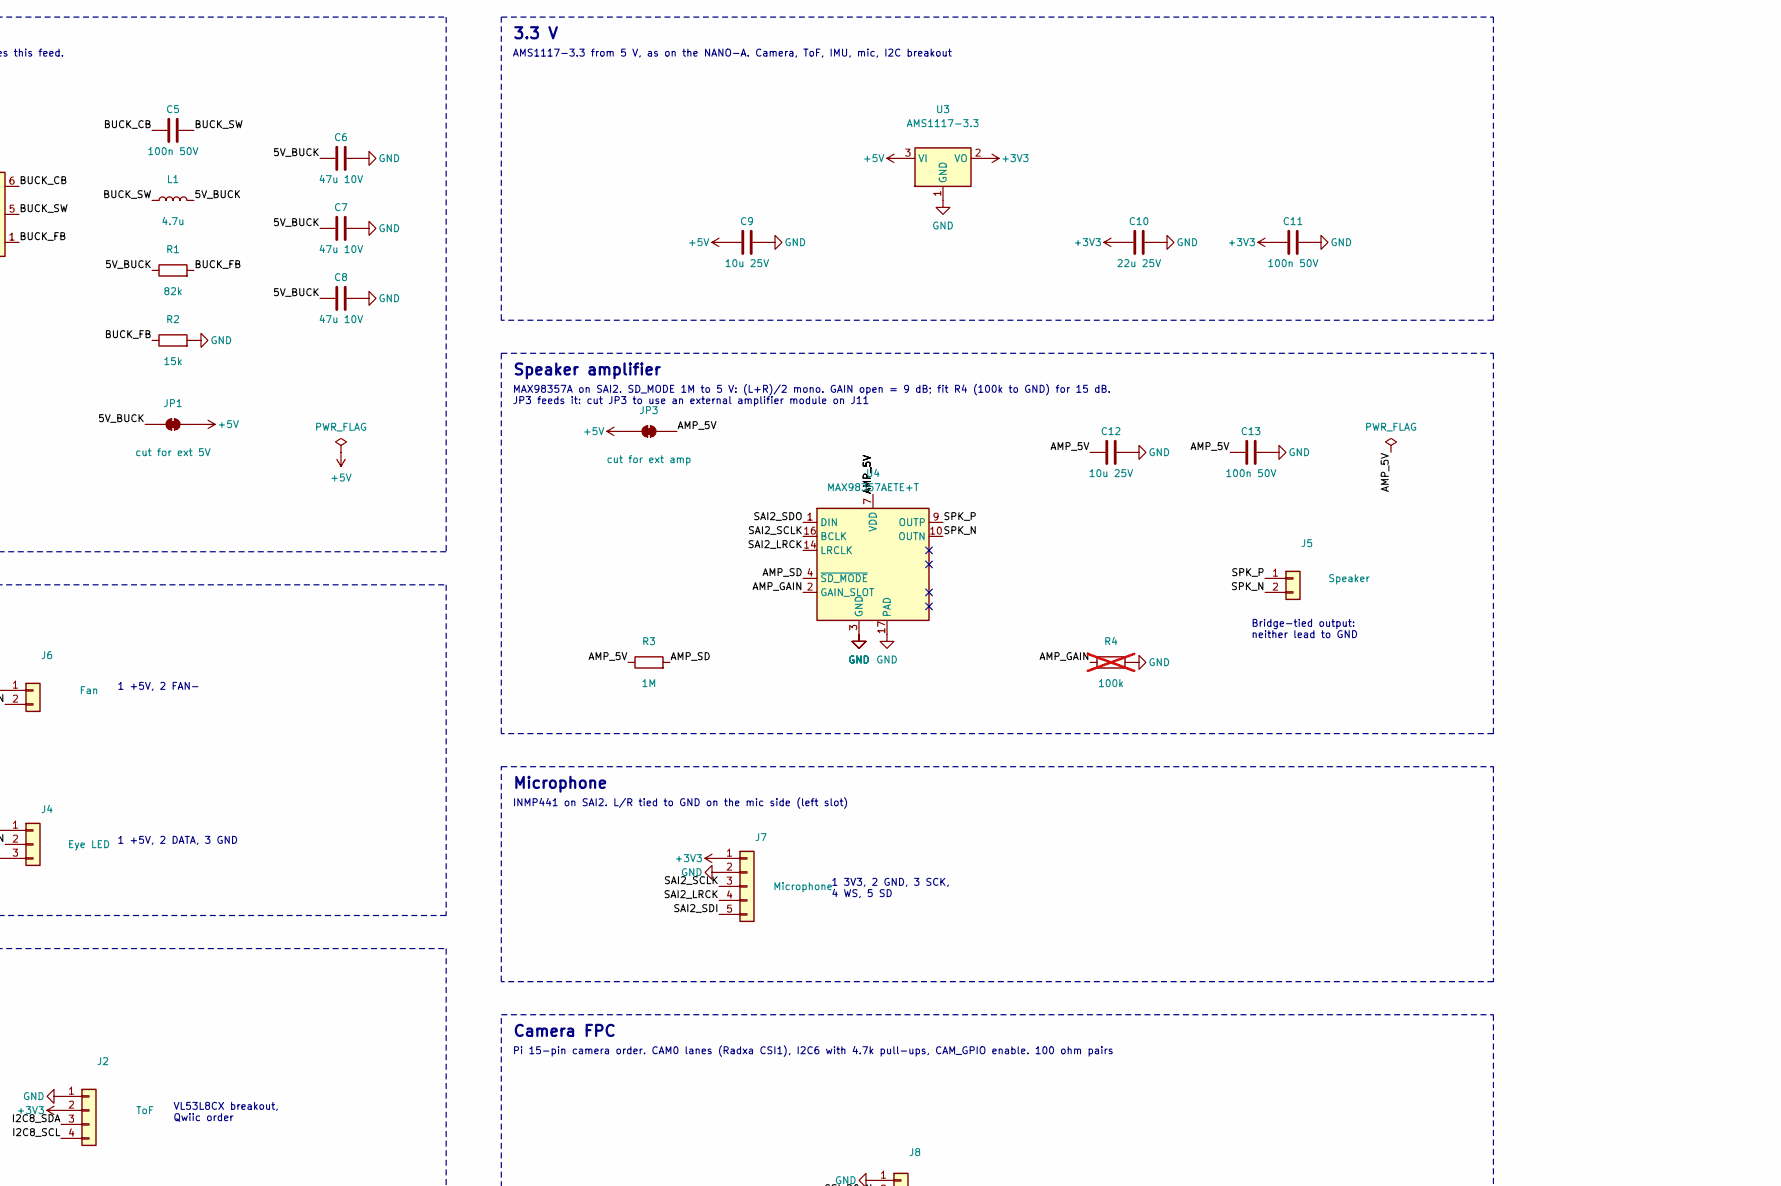
[picture p65: schematic head.kicad_sch, Dukki head carrier, part in row 1, column 2]

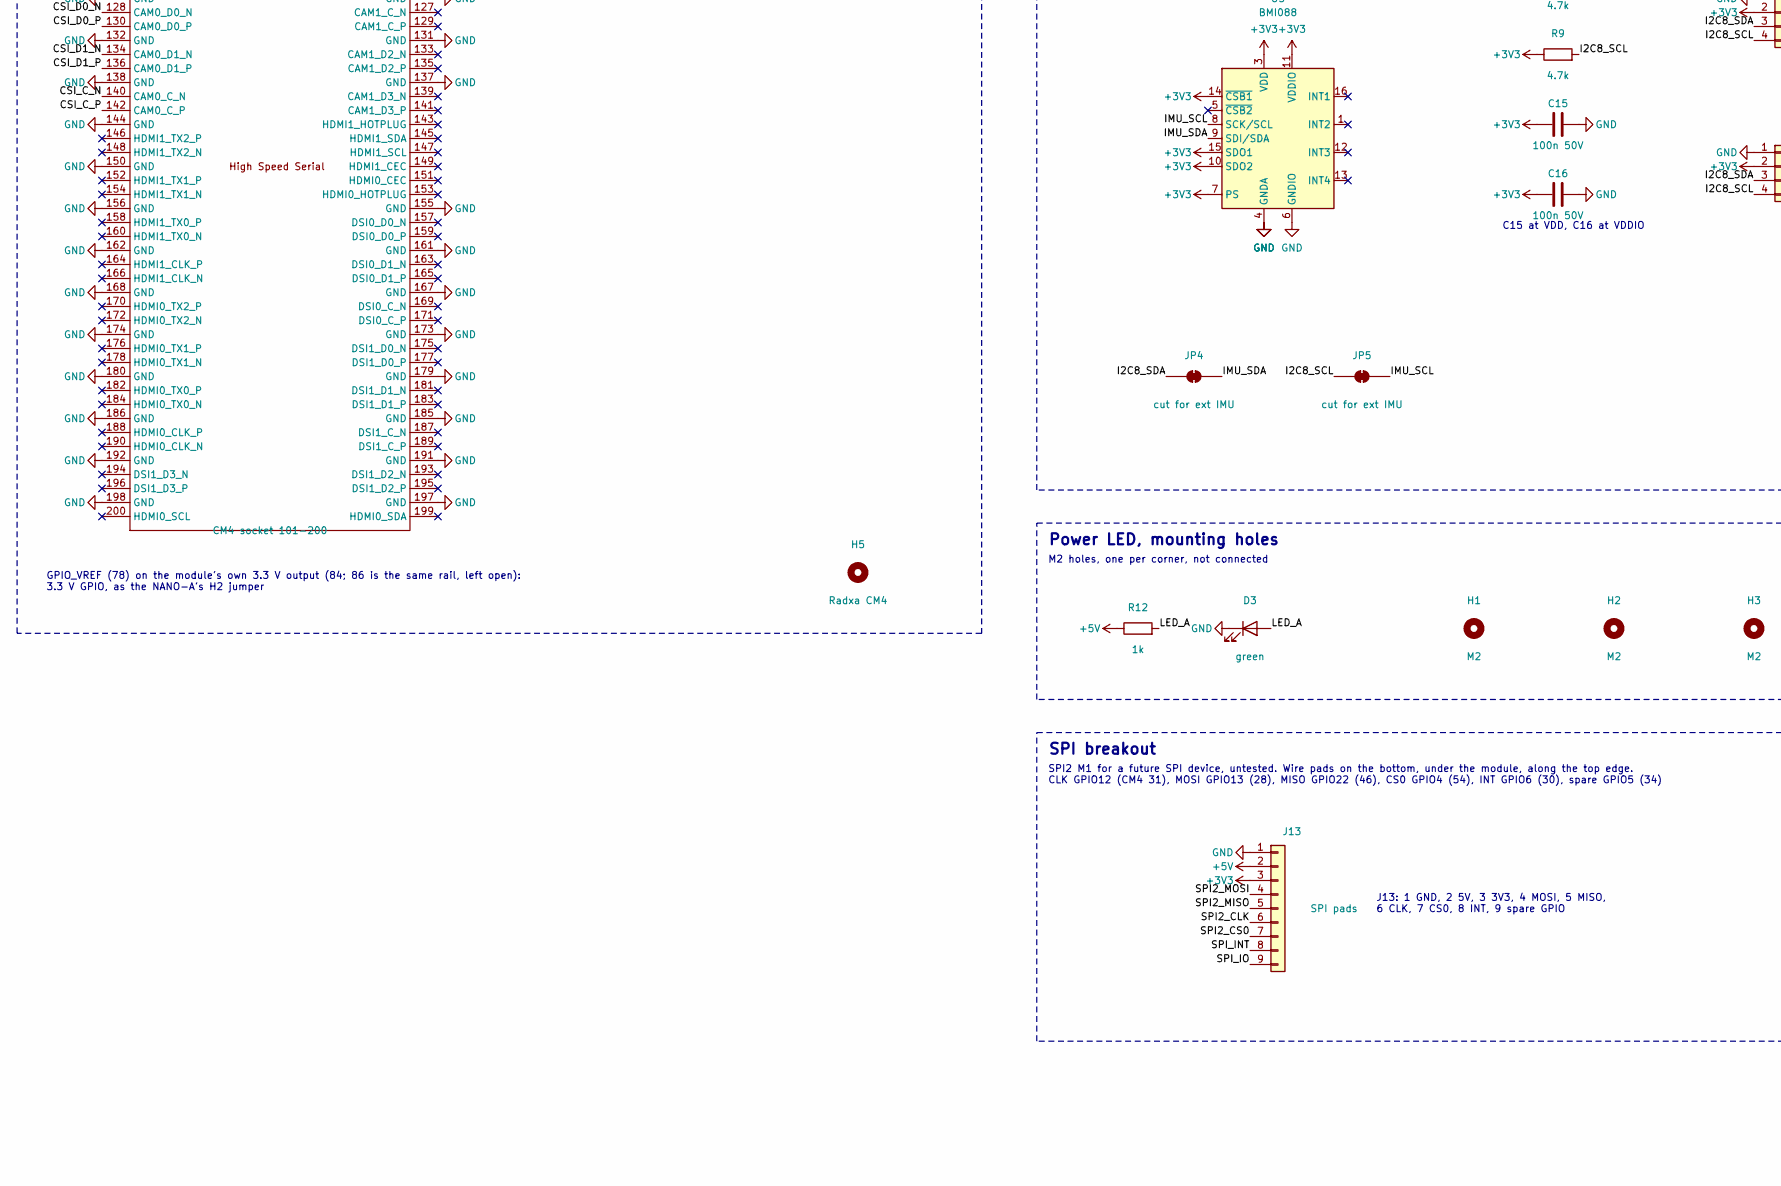
[picture p66: schematic head.kicad_sch, Dukki head carrier, part in row 2, column 1]

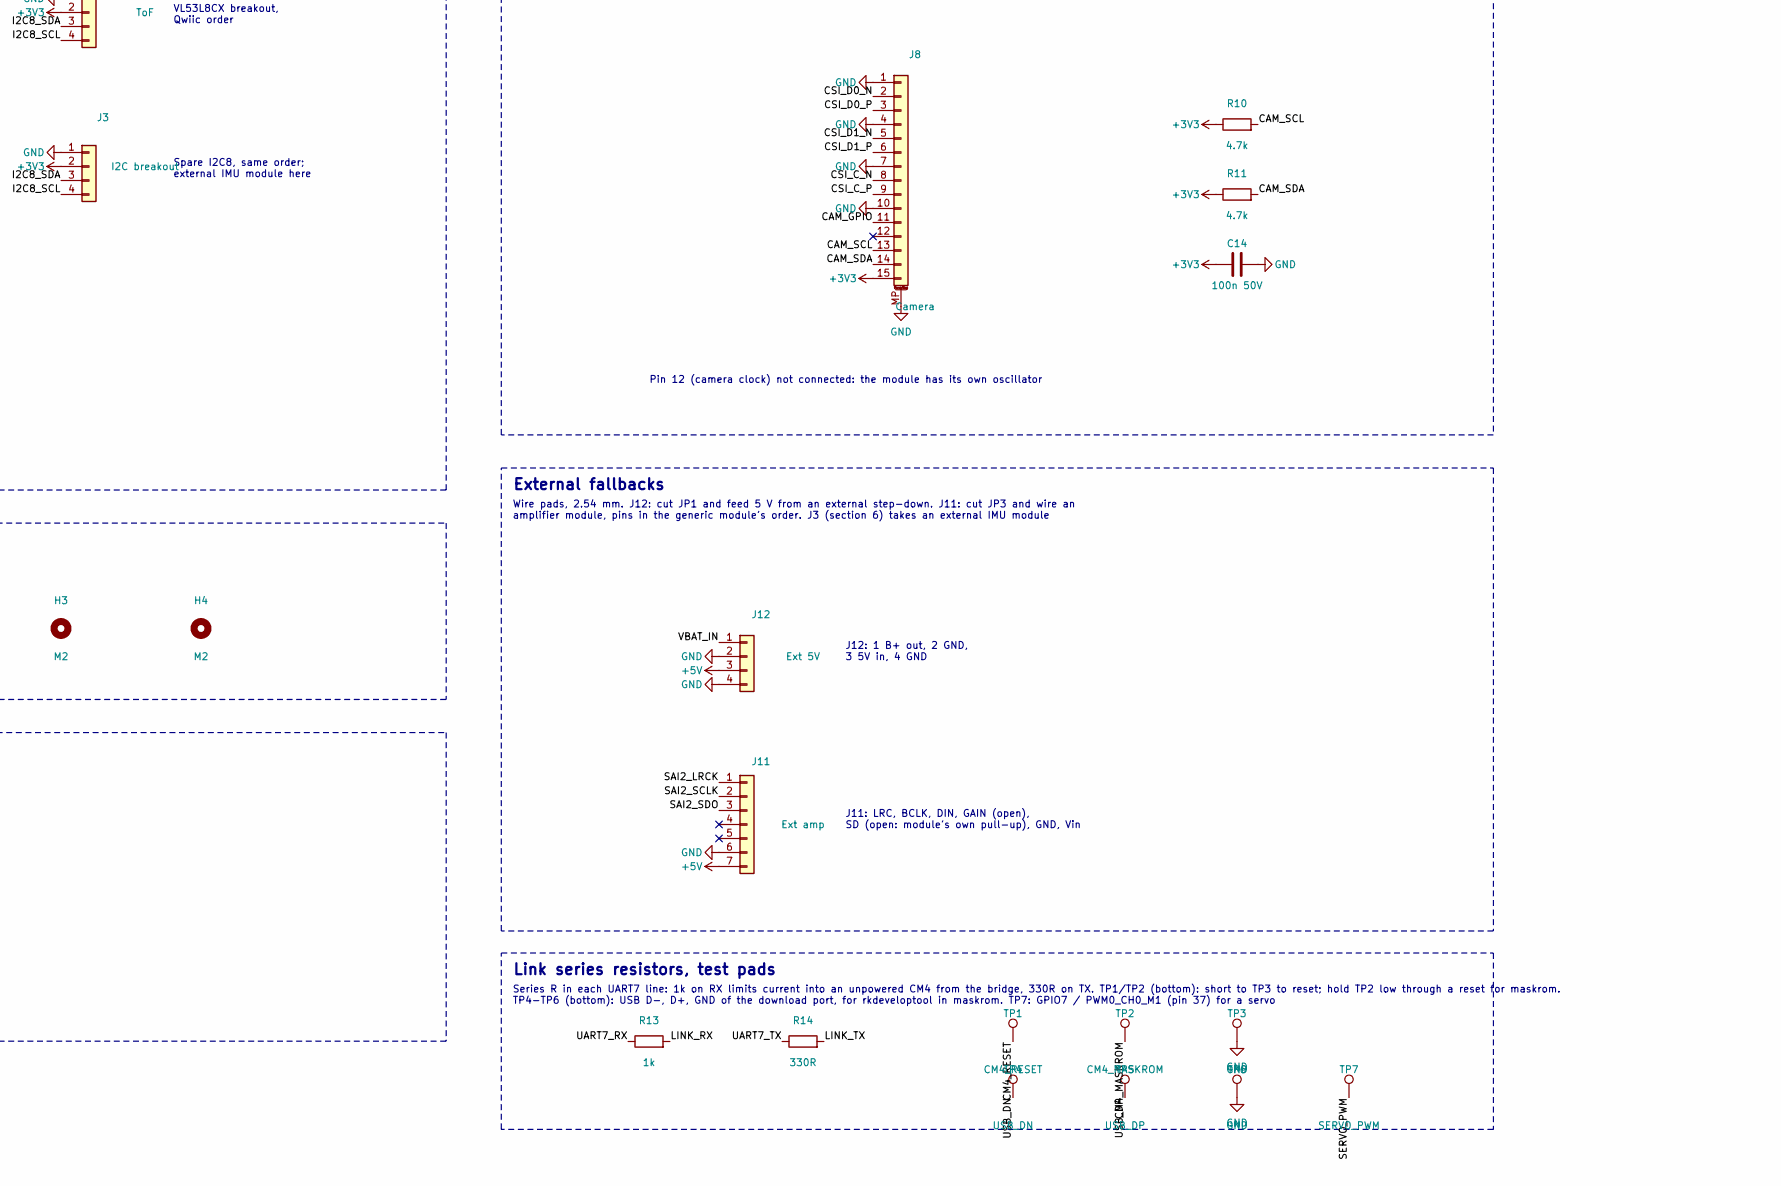
[picture p67: schematic head.kicad_sch, Dukki head carrier, part in row 2, column 2]

Parts:
C1, C2: 10u 50V X7R; C_1210_3225Metric; LCSC C596319
C4, C5, C11, C13, C14, C15, C16: 100n 50V; C_0603_1608Metric; LCSC C14663
C6, C7, C8: 47u 10V; C_1206_3216Metric; LCSC C96123
C9, C12: 10u 25V; C_0805_2012Metric; LCSC C15850
C10: 22u 25V; C_0805_2012Metric; LCSC C45783
C17: 47u 50V; CP_Elec_6.3x7.7; MPN RVT1H470M0607, 47 uF 50 V aluminium, 6.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; LCSC C970679
D1: SMBJ30A; D_SMB; LCSC C19077584
D2: B5819W; D_SOD-123; LCSC C8598
D3: green; LED_0603_1608Metric; LCSC C12624
H1, H2, H3, H4: M2; MountingHole_2.2mm_M2
H5: Radxa CM4; Radxa_CM4_Module
J1: Head bundle; JST_PH_B4B-PH-K_1x04_P2.00mm_Vertical; MPN JST B4B-PH-K-S, through hole, fitted by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
J2: ToF; JST_PH_B4B-PH-K_1x04_P2.00mm_Vertical; MPN JST B4B-PH-K-S, through hole, fitted by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
J3: I2C breakout; JST_PH_B4B-PH-K_1x04_P2.00mm_Vertical; MPN JST B4B-PH-K-S, through hole, fitted by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
J4: Eye LED; JST_PH_B3B-PH-K_1x03_P2.00mm_Vertical; MPN JST B3B-PH-K-S, through hole, fitted by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
J5: Speaker; JST_PH_B2B-PH-K_1x02_P2.00mm_Vertical; MPN JST B2B-PH-K-S, through hole, fitted by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
J6: Fan; JST_PH_B2B-PH-K_1x02_P2.00mm_Vertical; MPN JST B2B-PH-K-S, through hole, fitted by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
J7: Microphone; JST_PH_B5B-PH-K_1x05_P2.00mm_Vertical; MPN JST B5B-PH-K-S, through hole, fitted by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
J8: Camera; FPC_XUNPU_FPC-1.0HF-15PWAR-H20_1x15-1MP_P1.0mm; MPN XUNPU FPC-1.0HF-15PWAR-H20, dual contact; LCSC C19269369
J9: CM4 socket 1-100; DF40C_Socket_CM4_1-100; MPN Hirose DF40C-100DS-0.4V(51); LCSC C597931
J10: CM4 socket 101-200; DF40C_Socket_CM4_101-200; MPN Hirose DF40C-100DS-0.4V(51); LCSC C597931
J11: Ext amp; PinHeader_1x07_P2.54mm_Vertical
J12: Ext 5V; PinHeader_1x04_P2.54mm_Vertical
J13: SPI pads; SolderPads_1x09_P2.54mm_SPI
JP1: cut for ext 5V; SolderJumper-2_Wide_Bridged_3A
JP3: cut for ext amp; SolderJumper-2_Wide_Bridged_3A
JP4, JP5: cut for ext IMU; SolderJumper-2_P1.3mm_Bridged_RoundedPad1.0x1.5mm
L1: 4.7u; L_Sunlord_SWPA6045S; MPN Sunlord SWPA6045S4R7MT, 4.7 uH, 5.5 A s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; LCSC C78804
Q1: AO3400A; SOT-23; LCSC C20917
R1: 82k; R_0603_1608Metric; LCSC C23254
R2: 15k; R_0603_1608Metric; LCSC C22809
R3: 1M; R_0603_1608Metric; LCSC C22935
R4: 100k; R_0603_1608Metric; LCSC C25803; not fitted
R5: 100R; R_0603_1608Metric; LCSC C22775
R6: 100k; R_0603_1608Metric; LCSC C25803
R7, R14: 330R; R_0603_1608Metric; LCSC C23138
R8, R9, R10, R11: 4.7k; R_0603_1608Metric; LCSC C23162
R12, R13: 1k; R_0603_1608Metric; LCSC C21190
TP1: CM4_RESET; TestPoint_Pad_D1.5mm
TP2: CM4_MASKROM; TestPoint_Pad_D1.5mm
TP3, TP6: GND; TestPoint_Pad_D1.5mm
TP4: USB_DN; TestPoint_Pad_D1.5mm
TP5: USB_DP; TestPoint_Pad_D1.5mm
TP7: SERVO_PWM; TestPoint_Pad_D1.5mm
U2: LMR51635YDDCR; TSOT-23-6; LCSC C45262770
U3: AMS1117-3.3; SOT-223-3_TabPin2; LCSC C6186
U4: MAX98357AETE+T; TQFN-16-1EP_3x3mm_P0.5mm_EP1.23x1.23mm; LCSC C910544
U5: BMI088; Bosch_LGA-16_4.5x3mm_P0.5mm_LayoutBorder7x1y_ClockwisePinNu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; LCSC C194919

Connections:
+3V3: C10.1, C11.1, C14.1, C15.1, C16.1, J2.2, J3.2, J7.1, J8.15, J13.3, R8.1, R9.1, R10.1, R11.1, U3.2 (VO), U5.3 (VDD), U5.7 (PS), U5.10 (SDO2), U5.11 (VDDIO), U5.14 (~CSB1), U5.15 (SDO1)
+5V: C9.1, D2.1 (K), J4.1, J6.1, J9.77 (+5v_(Input)), J9.79 (+5v_(Input)), J9.81 (+5v_(Input)), J9.83 (+5v_(Input)), J9.85 (+5v_(Input)), J9.87 (+5v_(Input)), J11.7, J12.3, J13.2, JP1.2 (B), JP3.1 (A), R12.1, U3.3 (VI)
/5V_BUCK: C6.1, C7.1, C8.1, JP1.1 (A), L1.2, R1.1
/AMP_5V: C12.1, C13.1, JP3.2 (B), R3.1, U4.7 (VDD), U4.8 (VDD)
/AMP_GAIN: R4.1, U4.2 (GAIN_SLOT)
/AMP_SD: R3.2, U4.4 (~SD_MODE)
/BUCK_CB: C5.1, U2.6 (CB)
/BUCK_FB: R1.2, R2.1, U2.1 (FB)
/BUCK_SW: C5.2, L1.1, U2.5 (SW)
/CAM_GPIO: J8.11, J9.97 (Camera_GPIO)
/CAM_SCL: J8.13, J9.35 (ID_SC), R10.2
/CAM_SDA: J8.14, J9.36 (ID_SD), R11.2
/CM4_3V3: J9.78 (GPIO_VREF(1.8v/3.3v_Input)), J9.84 (+3.3v_(Output))
/CM4_MASKROM: J9.93 (nRPIBOOT), TP2.1
/CM4_RESET: J9.92 (RUN_PG), TP1.1
/CSI_C_N: J8.8, J10.140 (CAM0_C_N)
/CSI_C_P: J8.9, J10.142 (CAM0_C_P)
/CSI_D0_N: J8.2, J10.128 (CAM0_D0_N)
/CSI_D0_P: J8.3, J10.130 (CAM0_D0_P)
/CSI_D1_N: J8.5, J10.134 (CAM0_D1_N)
/CSI_D1_P: J8.6, J10.136 (CAM0_D1_P)
/EYE_DATA: J9.44 (GPIO10), R7.1
/EYE_DIN: J4.2, R7.2
/FAN_G: Q1.1 (G), R5.2, R6.1
/FAN_N: D2.2 (A), J6.2, Q1.3 (D)
/FAN_PWM: J9.50 (GPIO17), R5.1
/I2C8_SCL: J2.4, J3.4, J9.56 (GPIO3), JP5.1 (A), R9.2
/I2C8_SDA: J2.3, J3.3, J9.58 (GPIO2), JP4.1 (A), R8.2
/IMU_SCL: JP5.2 (B), U5.8 (SCK/SCL)
/IMU_SDA: JP4.2 (B), U5.9 (SDI/SDA)
/LED_A: D3.2 (A), R12.2
/LINK_RX: J1.3, R13.2
/LINK_TX: J1.4, R14.2
/SAI2_LRCK: J7.4, J9.26 (GPIO19), J11.1, U4.14 (LRCLK)
/SAI2_SCLK: J7.3, J9.49 (GPIO18), J11.2, U4.16 (BCLK)
/SAI2_SDI: J7.5, J9.27 (GPIO20)
/SAI2_SDO: J9.25 (GPIO21), J11.3, U4.1 (DIN)
/SERVO_PWM: J9.37 (GPIO7), TP7.1
/SPI2_CLK: J9.31 (GPIO12), J13.6
/SPI2_CS0: J9.54 (GPIO4), J13.7
/SPI2_MISO: J9.46 (GPIO22), J13.5
/SPI2_MOSI: J9.28 (GPIO13), J13.4
/SPI_INT: J9.30 (GPIO6), J13.8
/SPI_IO: J9.34 (GPIO5), J13.9
/SPK_N: J5.2, U4.10 (OUTN)
/SPK_P: J5.1, U4.9 (OUTP)
/UART7_RX: J9.45 (GPIO24), R13.1
/UART7_TX: J9.47 (GPIO23), R14.1
/USB_DN: J10.103 (USB2_N), TP4.1
/USB_DP: J10.105 (USB2_P), TP5.1
/VBAT_IN: C1.1, C2.1, C4.1, C17.1, D1.1 (K), J1.1, J12.1, U2.2 (EN), U2.3 (VIN)
GND: C1.2, C2.2, C4.2, C6.2, C7.2, C8.2, C9.2, C10.2, C11.2, C12.2, C13.2, C14.2, C15.2, C16.2, C17.2, D1.2 (A), D3.1 (K), J1.2, J2.1, J3.1, J4.3, J7.2, J8.1, J8.4, J8.7, J8.10, J8.MP (MountPin), J9.1 (GND), J9.2 (GND), J9.7 (GND), J9.8 (GND), J9.13 (GND), J9.14 (GND), J9.22 (GND), J9.23 (GND), J9.32 (GND), J9.33 (GND), J9.42 (GND), J9.43 (GND), J9.52 (GND), J9.53 (GND), J9.59 (GND), J9.60 (GND), J9.65 (GND), J9.66 (GND), J9.71 (GND), J9.74 (GND), J9.98 (GND), J10.107 (GND), J10.108 (GND), J10.113 (GND), J10.114 (GND), J10.119 (GND), J10.120 (GND), J10.125 (GND), J10.126 (GND), J10.131 (GND), J10.132 (GND), J10.137 (GND), J10.138 (GND), J10.144 (GND), J10.150 (GND), J10.155 (GND), J10.156 (GND), J10.161 (GND), J10.162 (GND), J10.167 (GND), J10.168 (GND), J10.173 (GND), J10.174 (GND), J10.179 (GND), J10.180 (GND), J10.185 (GND), J10.186 (GND), J10.191 (GND), J10.192 (GND), J10.197 (GND), J10.198 (GND), J11.6, J12.2, J12.4, J13.1, Q1.2 (S), R2.2, R4.2, R6.2, TP3.1, TP6.1, U2.4 (GND), U3.1 (GND), U4.3 (GND), U4.11 (GND), U4.15 (GND), U4.17 (PAD), U5.2 (GNDA), U5.4 (GNDA), U5.6 (GNDIO)

Notes on the sheet:
Radxa CM4 on DF40C sockets
Pin allocation: docs/head-pcb.md section 4. Unused pins not connected, as on the NANO-A
GPIO_VREF (78) on the module's own 3.3 V output (84; 86 is the same rail, left open): 3.3 V GPIO, as the NANO-A's H2 jumper
Head bundle in, 5 V buck
LMR51635Y, 1.1 MHz, 4.7 uH (TI table 8-2: 3.3 uH). 82k/15k sets 5.17 V. EN tied to VIN. F6 (2 A) on the bridge fuses this feed. JP1 joins the buck to the 5 V rail: cut it to feed 5 V from outside (J12). The feedback divider stays on the buck side
1 +BATT, 2 GND, 3 bridge TX, 4 bridge RX (bridge J6 order)
3.3 V
AMS1117-3.3 from 5 V, as on the NANO-A. Camera, ToF, IMU, mic, I2C breakout
Speaker amplifier
MAX98357A on SAI2. SD_MODE 1M to 5 V: (L+R)/2 mono. GAIN open = 9 dB; fit R4 (100k to GND) for 15 dB. JP3 feeds it: cut JP3 to use an external amplifier module on J11
Bridge-tied output: neither lead to GND
Fan and eye LED
Fan: low side, PWM1_CH2 (pin 50). Eye: WS2812-type, SPI1 MOSI (pin 44), 3.3 V data
1 +5V, 2 FAN-
1 +5V, 2 DATA, 3 GND
I2C8: head IMU, ToF, breakout
BMI088 on the board, I2C: PS and CSB1 high, CSB2 open (allowed in I2C mode); SDO1 and SDO2 high: accelerometer 0x19, gyroscope 0x69 (strapped so the pin rows need no vias between alternate pins). R8, R9: the bus pull-ups (the ToF breakout adds 10k). Cut JP4 and JP5 to use an external IMU module on 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
C15 at VDD, C16 at VDDIO
VL53L8CX breakout, Qwiic order
Spare I2C8, same order; external IMU module here
Microphone
INMP441 on SAI2. L/R tied to GND on the mic side (left slot)
1 3V3, 2 GND, 3 SCK, 4 WS, 5 SD
Camera FPC
Pi 15-pin camera order. CAM0 lanes (Radxa CSI1), I2C6 with 4.7k pull-ups, CAM_GPIO enable. 100 ohm pairs
Pin 12 (camera clock) not connected: the module has its own oscillator
Power LED, mounting holes
M2 holes, one per corner, not connected
External fallbacks
Wire pads, 2.54 mm. J12: cut JP1 and feed 5 V from an external step-down. J11: cut JP3 and wire an amplifier module, pins in the generic module's order. J3 (section 6) takes an external IMU module
J12: 1 B+ out, 2 GND, 3 5V in, 4 GND
J11: LRC, BCLK, DIN, GAIN (open), SD (open: module's own pull-up), GND, Vin
SPI breakout
SPI2 M1 for a future SPI device, untested. Wire pads on the bottom, under the module, along the top edge. CLK GPIO12 (CM4 31), MOSI GPIO13 (28), MISO GPIO22 (46), CS0 GPIO4 (54), INT GPIO6 (30), spare GPIO5 (34)
J13: 1 GND, 2 5V, 3 3V3, 4 MOSI, 5 MISO, 6 CLK, 7 CS0, 8 INT, 9 spare GPIO
Link series resistors, test pads
Series R in each UART7 line: 1k on RX limits current into an unpowered CM4 from the bridge, 330R on TX. TP1/TP2 (bottom): short to TP3 to reset; hold TP2 low through a reset for maskrom. TP4-TP6 (bottom): USB D-, D+, GND of the download port, for rkdeveloptool in maskrom. TP7: GPIO7 / PWM0_CH0_M1 (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

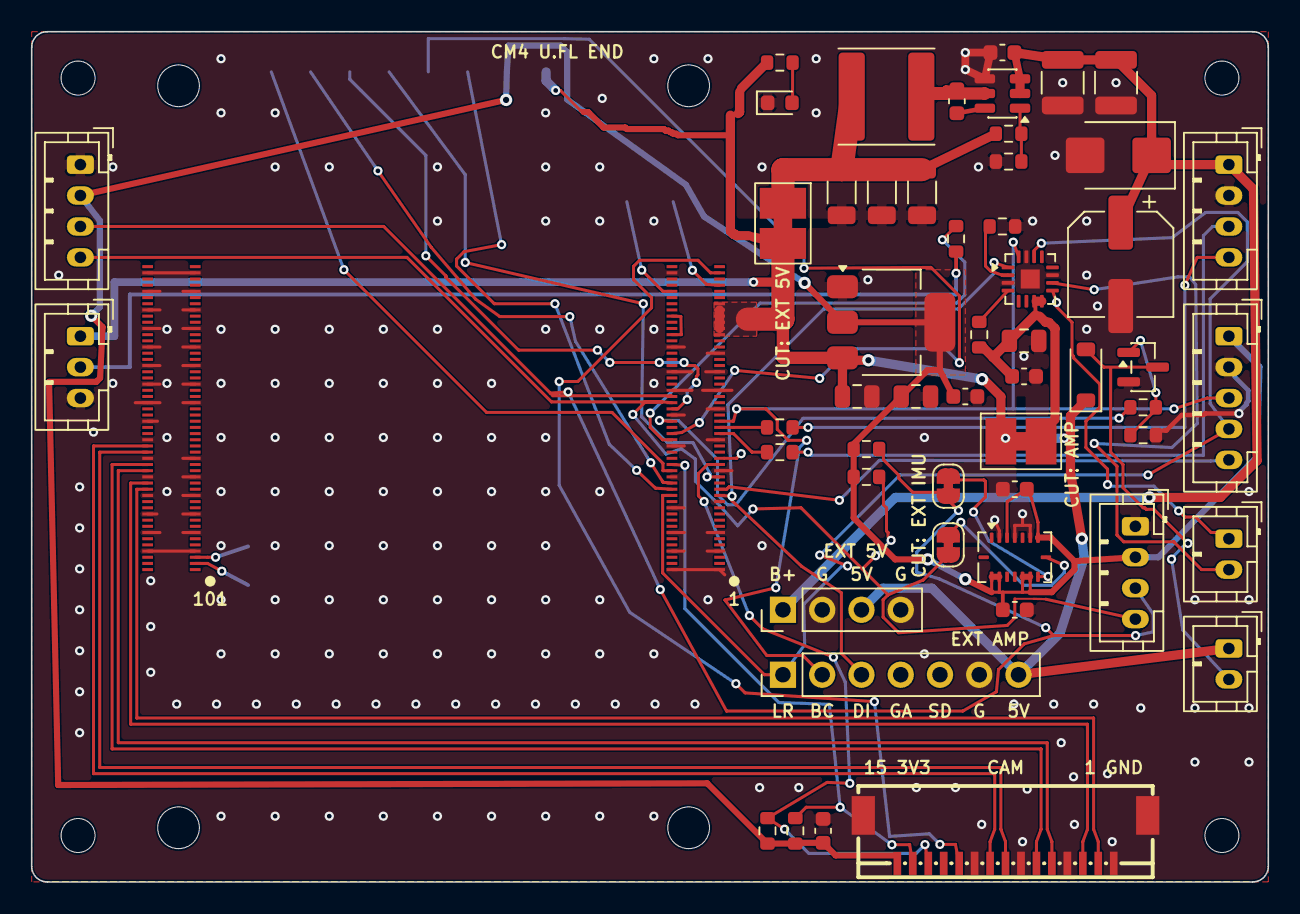
[picture p68: board head.kicad_pcb from above]

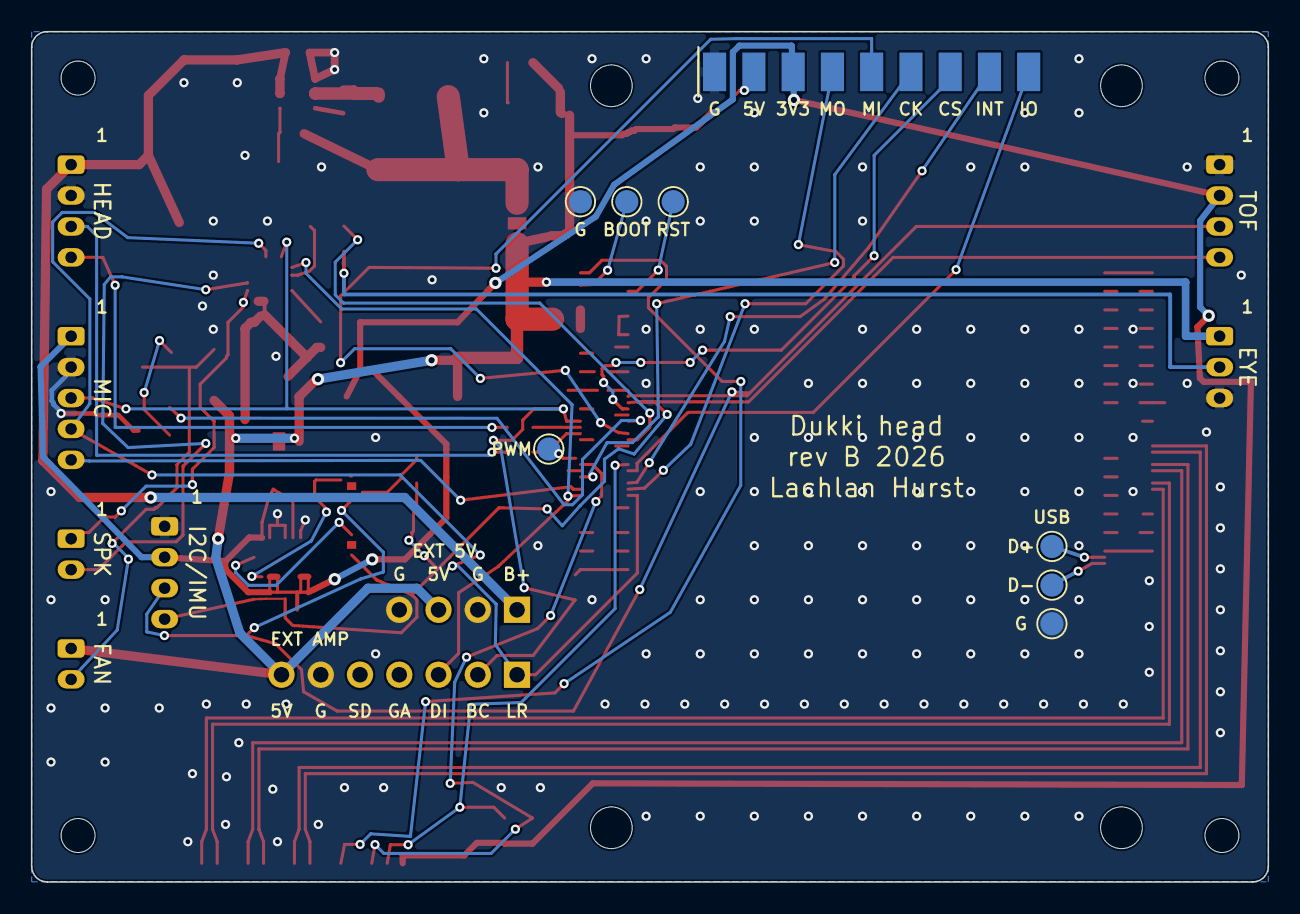
[picture p69: board head.kicad_pcb from below]

Board: 2 copper layers, 80.0 x 55.0 mm, 68 parts (8 on the bottom side), 52 nets.
