lachlanhurst/dukki/hardware/bridge/bridge.kicad_pcb

## KiCad design hardware/bridge/bridge.kicad_pcb (2026-10-16)

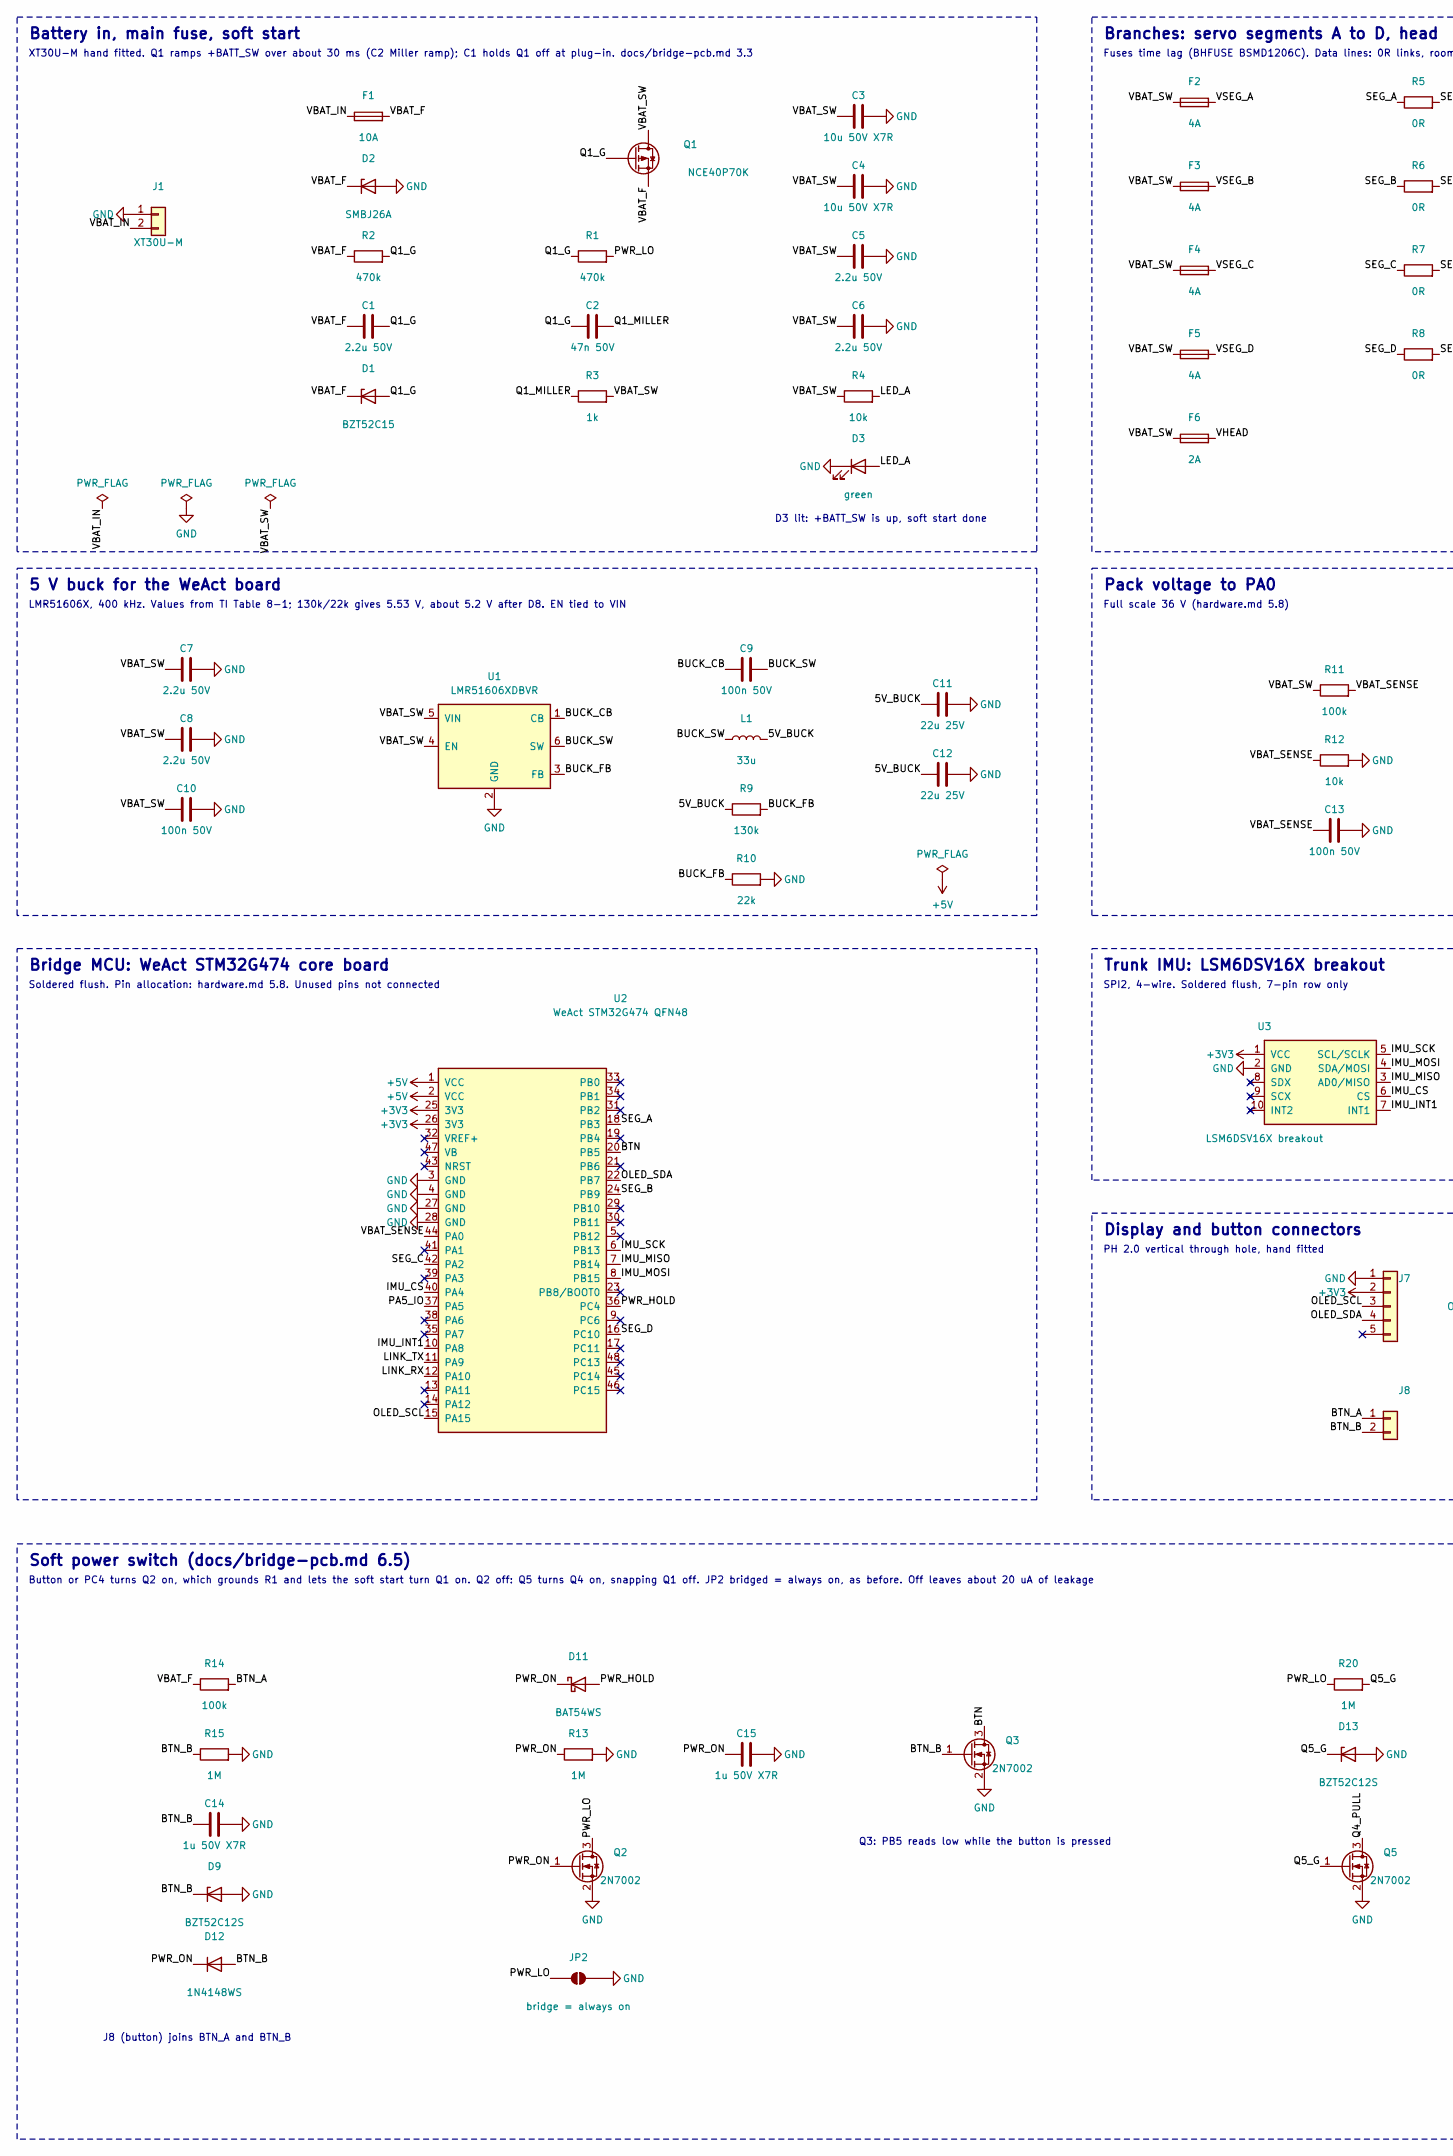
[picture p70: schematic bridge.kicad_sch, Dukki bridge carrier, part in row 1, column 1]

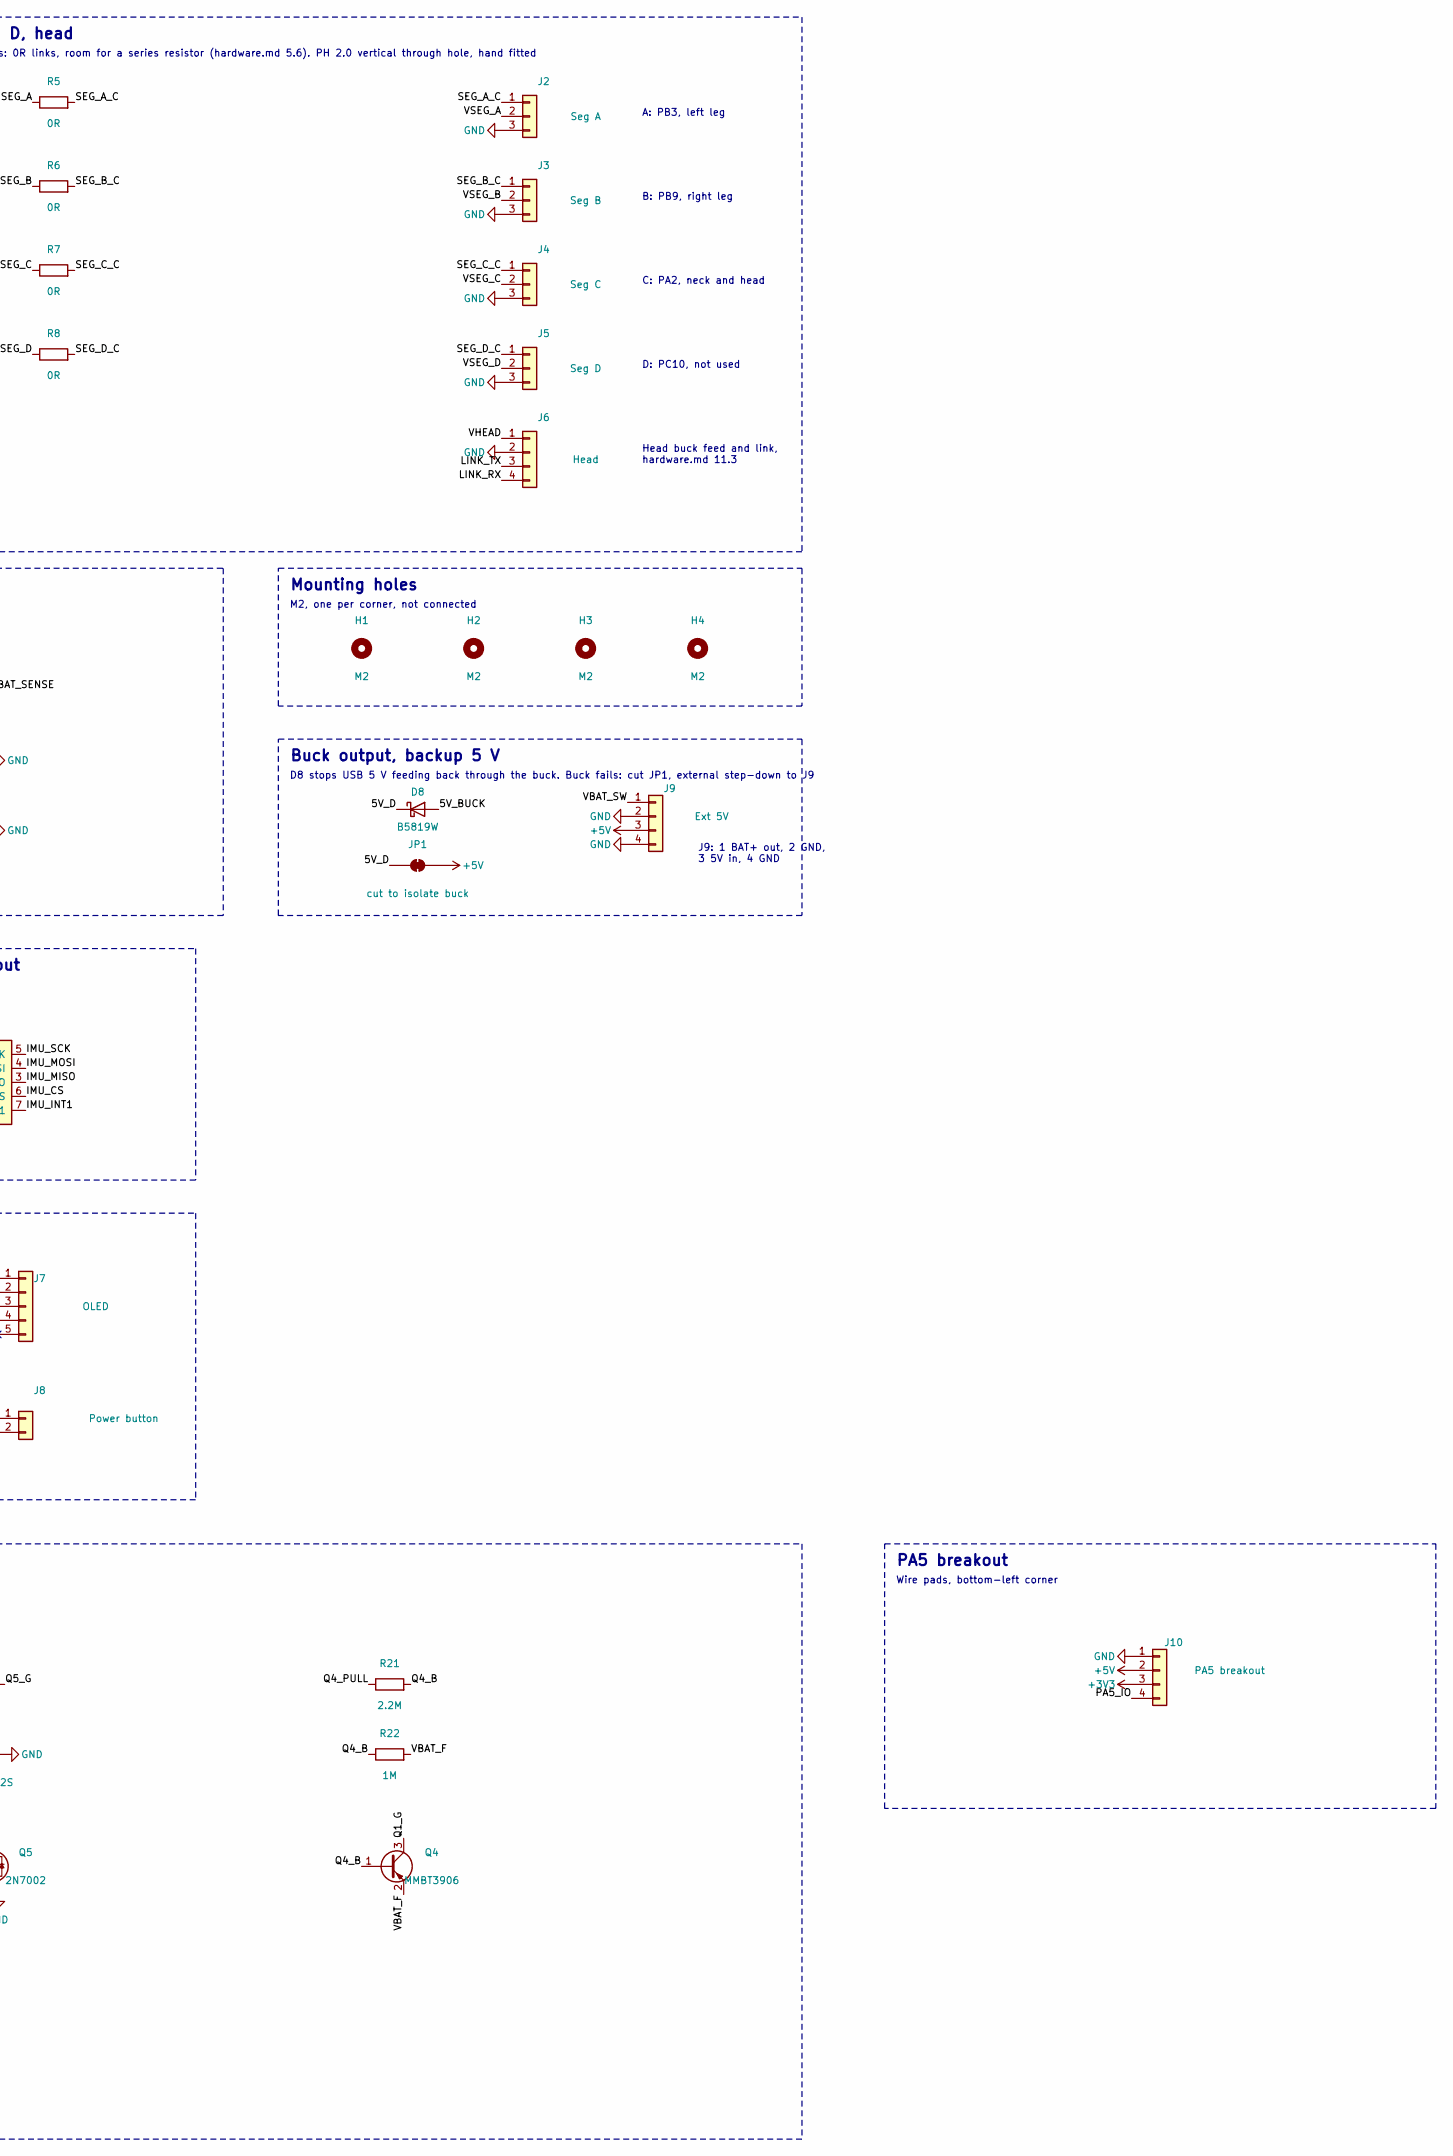
[picture p71: schematic bridge.kicad_sch, Dukki bridge carrier, part in row 1, column 2]

Parts:
C1, C5, C6, C7, C8: 2.2u 50V; C_0805_2012Metric; LCSC C377773
C2: 47n 50V; C_0603_1608Metric; LCSC C1622
C3, C4: 10u 50V X7R; C_1210_3225Metric; LCSC C596319
C9, C10, C13: 100n 50V; C_0603_1608Metric; LCSC C14663
C11, C12: 22u 25V; C_0805_2012Metric; LCSC C45783
C14, C15: 1u 50V X7R; C_0805_2012Metric; LCSC C28323
D1: BZT52C15; D_SOD-123; LCSC C19077412
D2: SMBJ26A; D_SMB; LCSC C19077580
D3: green; LED_0603_1608Metric; LCSC C12624
D8: B5819W; D_SOD-123; LCSC C8598
D9, D13: BZT52C12S; D_SOD-323; LCSC C19077447
D11: BAT54WS; D_SOD-323; LCSC C7502694
D12: 1N4148WS; D_SOD-323; LCSC C2128
F1: 10A; Fuse_1206_3216Metric; MPN BHFUSE BSMD1206C-2100T, 10 A time lag, 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; LCSC C41367232
F2, F3, F4, F5: 4A; Fuse_1206_3216Metric; MPN BHFUSE BSMD1206C-1400T, 4 A time lag, 7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; LCSC C41367227
F6: 2A; Fuse_1206_3216Metric; MPN BHFUSE BSMD1206C-1200T, 2 A time lag, 7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; LCSC C41367223
H1, H2, H3, H4: M2; MountingHole_2.2mm_M2
J1: XT30U-M; AMASS_XT30U-M_1x02_P5.0mm_Vertical
J2: Seg A; JST_PH_B3B-PH-K_1x03_P2.00mm_Vertical; MPN JST B3B-PH-K-S, through hole, fitted by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
J3: Seg B; JST_PH_B3B-PH-K_1x03_P2.00mm_Vertical; MPN JST B3B-PH-K-S, through hole, fitted by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
J4: Seg C; JST_PH_B3B-PH-K_1x03_P2.00mm_Vertical; MPN JST B3B-PH-K-S, through hole, fitted by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
J5: Seg D; JST_PH_B3B-PH-K_1x03_P2.00mm_Vertical; MPN JST B3B-PH-K-S, through hole, fitted by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
J6: Head; JST_PH_B4B-PH-K_1x04_P2.00mm_Vertical; MPN JST B4B-PH-K-S, through hole, fitted by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
J7: OLED; JST_PH_B5B-PH-K_1x05_P2.00mm_Vertical; MPN JST B5B-PH-K-S, through hole, fitted by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
J8: Power button; JST_PH_B2B-PH-K_1x02_P2.00mm_Vertical; MPN JST B2B-PH-K-S, through hole, fitted by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
J9: Ext 5V; PinHeader_1x04_P2.54mm_Vertical
J10: PA5 breakout; PinHeader_1x04_P2.54mm_Vertical
JP1: cut to isolate buck; SolderJumper-2_P1.3mm_Bridged_RoundedPad1.0x1.5mm
JP2: bridge = always on; SolderJumper-2_P1.3mm_Open_RoundedPad1.0x1.5mm
L1: 33u; L_Sunlord_SWPA6045S; MPN Sunlord SWPA6045S330MT; LCSC C83451
Q1: NCE40P70K; TO-252-2; LCSC C130101
Q2, Q3, Q5: 2N7002; SOT-23; LCSC C8545
Q4: MMBT3906; SOT-23; LCSC C7420354
R1, R2: 470k; R_0603_1608Metric; LCSC C23178
R3: 1k; R_0603_1608Metric; LCSC C21190
R4, R12: 10k; R_0603_1608Metric; LCSC C25804
R5, R6, R7, R8: 0R; R_0603_1608Metric; LCSC C21189
R9: 130k; R_0603_1608Metric; LCSC C22795
R10: 22k; R_0603_1608Metric; LCSC C31850
R11, R14: 100k; R_0603_1608Metric; LCSC C25803
R13, R15, R20, R22: 1M; R_0603_1608Metric; LCSC C22935
R21: 2.2M; R_0603_1608Metric; LCSC C22938
U1: LMR51606XDBVR; SOT-23-6; LCSC C21260865
U2: WeAct STM32G474 QFN48; WeAct_STM32G474CoreBoard_QFN48
U3: LSM6DSV16X breakout; LSM6DSV16X_Breakout

Connections:
+3V3: J7.2, J10.3, U2.25 (3V3), U2.26 (3V3), U3.1 (VCC)
+5V: J9.3, J10.2, JP1.2 (B), U2.1 (VCC), U2.2 (VCC)
/5V_BUCK: C11.1, C12.1, D8.2 (A), L1.2, R9.1
/5V_D: D8.1 (K), JP1.1 (A)
/BTN: Q3.3 (D), U2.20 (PB5)
/BTN_A: J8.1, R14.2
/BTN_B: C14.1, D9.1 (K), D12.2 (A), J8.2, Q3.1 (G), R15.1
/BUCK_CB: C9.1, U1.1 (CB)
/BUCK_FB: R9.2, R10.1, U1.3 (FB)
/BUCK_SW: C9.2, L1.1, U1.6 (SW)
/IMU_CS: U2.40 (PA4), U3.6 (CS)
/IMU_INT1: U2.10 (PA8), U3.7 (INT1)
/IMU_MISO: U2.7 (PB14), U3.3 (AD0/MISO)
/IMU_MOSI: U2.8 (PB15), U3.4 (SDA/MOSI)
/IMU_SCK: U2.6 (PB13), U3.5 (SCL/SCLK)
/LED_A: D3.2 (A), R4.2
/LINK_RX: J6.4, U2.12 (PA10)
/LINK_TX: J6.3, U2.11 (PA9)
/OLED_SCL: J7.3, U2.15 (PA15)
/OLED_SDA: J7.4, U2.22 (PB7)
/PA5_IO: J10.4, U2.37 (PA5)
/PWR_HOLD: D11.2 (A), U2.36 (PC4)
/PWR_LO: JP2.1 (A), Q2.3 (D), R1.2, R20.1
/PWR_ON: C15.1, D11.1 (K), D12.1 (K), Q2.1 (G), R13.1
/Q1_G: C1.2, C2.1, D1.2 (A), Q1.1 (G), Q4.3 (C), R1.1, R2.2
/Q1_MILLER: C2.2, R3.1
/Q4_B: Q4.1 (B), R21.2, R22.1
/Q4_PULL: Q5.3 (D), R21.1
/Q5_G: D13.1 (K), Q5.1 (G), R20.2
/SEG_A: R5.1, U2.18 (PB3)
/SEG_A_C: J2.1, R5.2
/SEG_B: R6.1, U2.24 (PB9)
/SEG_B_C: J3.1, R6.2
/SEG_C: R7.1, U2.42 (PA2)
/SEG_C_C: J4.1, R7.2
/SEG_D: R8.1, U2.16 (PC10)
/SEG_D_C: J5.1, R8.2
/VBAT_F: C1.1, D1.1 (K), D2.1 (K), F1.2, Q1.3 (S), Q4.2 (E), R2.1, R14.1, R22.2
/VBAT_IN: F1.1, J1.2
/VBAT_SENSE: C13.1, R11.2, R12.1, U2.44 (PA0)
/VBAT_SW: C3.1, C4.1, C5.1, C6.1, C7.1, C8.1, C10.1, F2.1, F3.1, F4.1, F5.1, F6.1, J9.1, Q1.2 (D), R3.2, R4.1, R11.1, U1.4 (EN), U1.5 (VIN)
/VHEAD: F6.2, J6.1
/VSEG_A: F2.2, J2.2
/VSEG_B: F3.2, J3.2
/VSEG_C: F4.2, J4.2
/VSEG_D: F5.2, J5.2
GND: C3.2, C4.2, C5.2, C6.2, C7.2, C8.2, C10.2, C11.2, C12.2, C13.2, C14.2, C15.2, D2.2 (A), D3.1 (K), D9.2 (A), D13.2 (A), J1.1, J2.3, J3.3, J4.3, J5.3, J6.2, J7.1, J9.2, J9.4, J10.1, JP2.2 (B), Q2.2 (S), Q3.2 (S), Q5.2 (S), R10.2, R12.2, R13.2, R15.2, U1.2 (GND), U2.3 (GND), U2.4 (GND), U2.27 (GND), U2.28 (GND), U3.2 (GND)

Notes on the sheet:
Battery in, main fuse, soft start
XT30U-M hand fitted. Q1 ramps +BATT_SW over about 30 ms (C2 Miller ramp); C1 holds Q1 off at plug-in. docs/bridge-pcb.md 3.3
D3 lit: +BATT_SW is up, soft start done
Branches: servo segments A to D, head
Fuses time lag (BHFUSE BSMD1206C). Data lines: 0R links, room for a series resistor (hardware.md 5.6). PH 2.0 vertical through hole, hand fitted
A: PB3, left leg
B: PB9, right leg
C: PA2, neck and head
D: PC10, not used
Head buck feed and link, hardware.md 11.3
5 V buck for the WeAct board
LMR51606X, 400 kHz. Values from TI Table 8-1; 130k/22k gives 5.53 V, about 5.2 V after D8. EN tied to VIN
Pack voltage to PA0
Full scale 36 V (hardware.md 5.8)
Mounting holes
M2, one per corner, not connected
Buck output, backup 5 V
D8 stops USB 5 V feeding back through the buck. Buck fails: cut JP1, external step-down to J9
J9: 1 BAT+ out, 2 GND, 3 5V in, 4 GND
Bridge MCU: WeAct STM32G474 core board
Soldered flush. Pin allocation: hardware.md 5.8. Unused pins not connected
Trunk IMU: LSM6DSV16X breakout
SPI2, 4-wire. Soldered flush, 7-pin row only
Display and button connectors
PH 2.0 vertical through hole, hand fitted
Soft power switch (docs/bridge-pcb.md 6.5)
Button or PC4 turns Q2 on, which grounds R1 and lets the soft start turn Q1 on. Q2 off: Q5 turns Q4 on, snapping Q1 off. JP2 bridged = always on, as before. Off leaves about 20 uA of leakage
J8 (button) joins BTN_A and BTN_B
Q3: PB5 reads low while the button is pressed
PA5 breakout
Wire pads, bottom-left corner

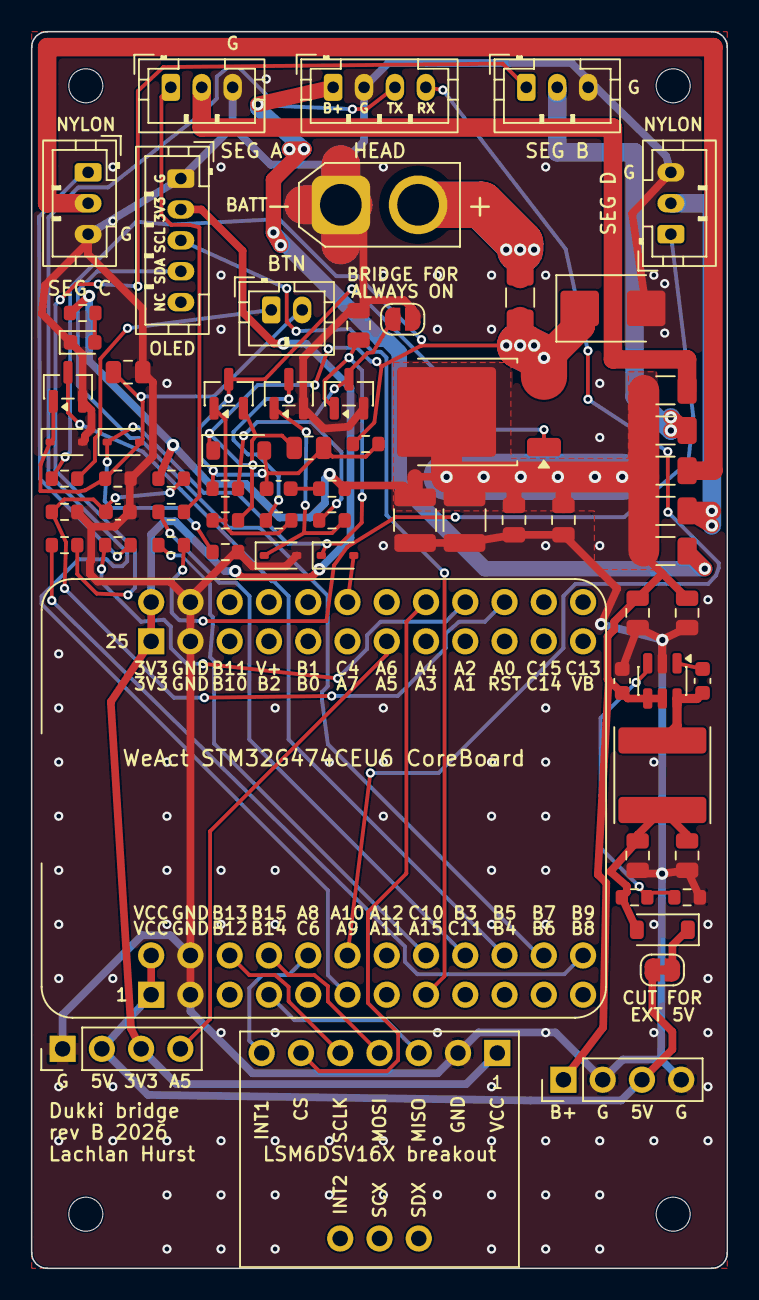
[picture p72: board bridge.kicad_pcb from above]

Board: 2 copper layers, 45.0 x 80.0 mm, 72 parts (0 on the bottom side), 47 nets.
