lachlanhurst/dukki/src/bridge/src/main.rs

//! Dukki servo bridge firmware for the WeAct STM32G474 core board (QFN48,
//! STM32G474CEU6).
//!
//! For now a bench test of everything on the bridge (hardware.md section 5.8):
//! the trunk IMU with SFLP fusion on SPI2, and the J288 servos on up to four bus
//! segments (A: USART2 on PB3, B: USART3 on PB9, C: LPUART1 on PA2, D: UART4 on PC10),
//! single-wire at 6 Mbps, each transaction a polled register loop. Each segment
//! finds its servos by scanning IDs 0 to 14. A USB CDC serial console reports
//! both at 5 Hz and takes single-key commands that set the servos' test mode.
//! The blue LED on PC6 toggles with each report. A small OLED on I2C1 shows a
//! status summary (display.rs), and a button on PB5 asks the compute module to
//! shut down when held (button.rs). On the carrier PCB, PC4 holds the soft power
//! switch on and PA0 reads the switched rail (power.rs).

#![no_std]
#![no_main]

mod battery;
mod button;
mod display;
mod imu;
mod j288;
mod link;
mod power;
mod segment;

use core::cell::Cell;
use core::fmt::Write;

use embassy_executor::Spawner;
use embassy_futures::join::{join, join3, join5};
use embassy_stm32::adc::{Adc, AdcChannel};
use embassy_stm32::exti::{self, ExtiInput};
use embassy_stm32::i2c::{self, I2c};
use embassy_stm32::gpio::{Input, Level, Output, Pull, Speed};
use embassy_stm32::rcc::{self, mux};
use embassy_stm32::spi::{self, Spi};
use embassy_stm32::time::Hertz;
use embassy_stm32::usart::{self, HalfDuplexReadback, OutputConfig, Uart};
use embassy_stm32::usb::{self, Driver};
use embassy_stm32::{bind_interrupts, dma, interrupt, peripherals};
use embassy_time::{Delay, Instant, Timer};
use embassy_usb::class::cdc_acm::{CdcAcmClass, Receiver, Sender, State};
use embassy_usb::driver::EndpointError;
use embassy_usb::Builder;
use embedded_hal_bus::spi::ExclusiveDevice;
use lsm6dsv16x_rs::asynchronous::prelude::Lsm6dsv16x;
use panic_halt as _;

use segment::{Control, Overlap, Raw, SegmentStats, TestMode};

bind_interrupts!(struct Irqs {
    USB_LP => usb::InterruptHandler<peripherals::USB>;
    EXTI9_5 => exti::InterruptHandler<interrupt::typelevel::EXTI9_5>;
    USART1 => usart::InterruptHandler<peripherals::USART1>;
    USART2 => usart::InterruptHandler<peripherals::USART2>;
    USART3 => usart::InterruptHandler<peripherals::USART3>;
    LPUART1 => usart::InterruptHandler<peripherals::LPUART1>;
    DMA1_CHANNEL1 => dma::InterruptHandler<peripherals::DMA1_CH1>;
    DMA1_CHANNEL2 => dma::InterruptHandler<peripherals::DMA1_CH2>;
    DMA1_CHANNEL3 => dma::InterruptHandler<peripherals::DMA1_CH3>;
    DMA1_CHANNEL4 => dma::InterruptHandler<peripherals::DMA1_CH4>;
    DMA1_CHANNEL5 => dma::InterruptHandler<peripherals::DMA1_CH5>;
    DMA1_CHANNEL6 => dma::InterruptHandler<peripherals::DMA1_CH6>;
    DMA1_CHANNEL7 => dma::InterruptHandler<peripherals::DMA1_CH7>;
    DMA1_CHANNEL8 => dma::InterruptHandler<peripherals::DMA1_CH8>;
    DMA2_CHANNEL1 => dma::InterruptHandler<peripherals::DMA2_CH1>;
    DMA2_CHANNEL2 => dma::InterruptHandler<peripherals::DMA2_CH2>;
    UART4 => usart::InterruptHandler<peripherals::UART4>;
    DMA2_CHANNEL3 => dma::InterruptHandler<peripherals::DMA2_CH3>;
    DMA2_CHANNEL4 => dma::InterruptHandler<peripherals::DMA2_CH4>;
    I2C1_EV => i2c::EventInterruptHandler<peripherals::I2C1>;
    I2C1_ER => i2c::ErrorInterruptHandler<peripherals::I2C1>;
    DMA2_CHANNEL5 => dma::InterruptHandler<peripherals::DMA2_CH5>;
    DMA2_CHANNEL6 => dma::InterruptHandler<peripherals::DMA2_CH6>;
});

const SEGMENT_NAMES: [&str; segment::SEGMENTS] = ["A", "B", "C", "D"];

/// Set by the console's `U` just before a reset; `main` then starts the ROM bootloader, so the
/// firmware can be flashed over USB DFU (flash.sh) without the BOOT and reset buttons. In
/// `.uninit`, which the startup code leaves alone, so it survives the reset.
#[unsafe(link_section = ".uninit.BOOTLOADER_REQUEST")]
static mut BOOTLOADER_REQUEST: core::mem::MaybeUninit<u32> = core::mem::MaybeUninit::uninit();
const ENTER_BOOTLOADER: u32 = 0xB007_10AD;
/// The STM32G4's system memory, where its ROM bootloader's vector table starts (AN2606).
const SYSTEM_MEMORY: u32 = 0x1FFF_0000;

/// Where this firmware's vector table is.
const FLASH: u32 = 0x0800_0000;

/// Starts the ROM bootloader if the last reset was the console's request. Runs before anything
/// is configured, so the bootloader starts from the reset state it expects.
///
/// Otherwise points the vector table at this firmware. After a reset it already is, but when
/// the bootloader starts the firmware itself (dfu-util's `:leave`) it jumps in with its own table
/// still in VTOR, and the first interrupt would land in the bootloader.
fn bootloader_if_requested() {
    let request = core::ptr::addr_of_mut!(BOOTLOADER_REQUEST) as *mut u32;
    unsafe {
        if request.read_volatile() != ENTER_BOOTLOADER {
            (*cortex_m::peripheral::SCB::PTR).vtor.write(FLASH);
            return;
        }
        request.write_volatile(0);
        // Map system memory at 0 as BOOT0 would: SYSCFG's clock on (RCC_APB2ENR.SYSCFGEN),
        // then SYSCFG_MEMRMP.MEM_MODE = 001.
        let apb2enr = (0x4002_1000 + 0x60) as *mut u32;
        apb2enr.write_volatile(apb2enr.read_volatile() | 1);
        let memrmp = 0x4001_0000 as *mut u32;
        memrmp.write_volatile((memrmp.read_volatile() & !0b111) | 0b001);
        (*cortex_m::peripheral::SCB::PTR).vtor.write(SYSTEM_MEMORY);
        cortex_m::asm::bootload(SYSTEM_MEMORY as *const u32);
    }
}

/// Resets into the ROM bootloader (see [`bootloader_if_requested`]).
fn reset_to_bootloader() -> ! {
    let request = core::ptr::addr_of_mut!(BOOTLOADER_REQUEST) as *mut u32;
    unsafe { request.write_volatile(ENTER_BOOTLOADER) };
    cortex_m::peripheral::SCB::sys_reset()
}

/// A fixed buffer that `write!` can format into.
struct Line {
    buf: [u8; 256],
    len: usize,
}

impl Line {
    fn new() -> Self {
        Self { buf: [0; 256], len: 0 }
    }
    fn as_bytes(&self) -> &[u8] {
        &self.buf[..self.len]
    }
}

impl Write for Line {
    fn write_str(&mut self, s: &str) -> core::fmt::Result {
        let n = s.len().min(self.buf.len() - self.len);
        self.buf[self.len..self.len + n].copy_from_slice(&s.as_bytes()[..n]);
        self.len += n;
        Ok(())
    }
}

#[embassy_executor::main]
async fn main(_spawner: Spawner) {
    bootloader_if_requested();
    let mut config = embassy_stm32::Config::default();
    // 168 MHz from the 8 MHz crystal (PLL 8 / 1 x 42 / 2): every USART divider is an
    // integer at 6 Mbps (hardware.md section 5.3). Above 150 MHz needs boost mode.
    config.rcc.hse = Some(rcc::Hse { freq: Hertz(8_000_000), mode: rcc::HseMode::Oscillator });
    config.rcc.pll = Some(rcc::Pll {
        source: rcc::PllSource::HSE,
        prediv: rcc::PllPreDiv::DIV1,
        mul: rcc::PllMul::MUL42,
        divp: None,
        divq: None,
        divr: Some(rcc::PllRDiv::DIV2),
    });
    config.rcc.sys = rcc::Sysclk::PLL1_R;
    config.rcc.boost = true;
    // USB runs from HSI48, trimmed by the CRS against the host's start-of-frame packets.
    config.rcc.hsi48 = Some(rcc::Hsi48Config { sync_from_usb: true });
    config.rcc.mux.clk48sel = mux::Clk48sel::HSI48;
    // The ADC reads the switched rail on PA0; 168 MHz divides to 42 MHz, under its 60 MHz.
    config.rcc.mux.adc12sel = mux::Adcsel::SYS;
    let p = embassy_stm32::init(config);

    // Power hold first (power.rs): C15 keeps the soft power switch on for at least 0.22 s
    // after the button's release or a reset, and the clocks above take a few milliseconds.
    // Shutdown button: a switch from PB5 to ground, held up internally (button.rs).
    let button_pin = Input::new(p.PB5, Pull::Up);
    let mut power_hold = Output::new(p.PC4, Level::Low, Speed::Low);
    let mut rail = power::Rail { adc: Adc::new(p.ADC1, Default::default()), pin: p.PA0.degrade_adc() };
    // Let the pull-up lift PB5 before it is read: about 10 µs at 168 MHz.
    cortex_m::asm::delay(1_680);
    let power_state = Cell::new(power::at_boot(&mut power_hold, button_pin.is_low(), &mut rail));

    let mut led = Output::new(p.PC6, Level::Low, Speed::Low);

    // Trunk IMU on SPI2: SCK PB13, MISO PB14, MOSI PB15, CS PA4 (hardware.md 5.8). PC10 and
    // PC11 are left free for UART4, a fourth servo segment if one is ever wanted.
    let mut spi_config = spi::Config::default();
    spi_config.frequency = Hertz(8_000_000);
    spi_config.mode = spi::MODE_3;
    let spi = Spi::new(p.SPI2, p.PB13, p.PB15, p.PB14, p.DMA1_CH1, p.DMA1_CH2, Irqs, spi_config);
    // High at boot: the chip stays in I2C mode until CS first goes low.
    let cs = Output::new(p.PA4, Level::High, Speed::Medium);
    let sensor = Lsm6dsv16x::new_spi(ExclusiveDevice::new_no_delay(spi, cs).unwrap(), Delay);
    let mut int1 = ExtiInput::new(p.PA8, p.EXTI8, Pull::Down, Irqs);

    // Servo segments: single-wire half duplex on the TX pin. The polled loop in
    // segment.rs drives it push-pull while transmitting and open drain otherwise;
    // there is no external pull-up (hardware.md section 5.6). No internal pull-up
    // either: each J288 pulls the line towards 5 V itself, and an FT pin only
    // sustains more than 4 V with its internal pull resistors off (DS12288 table 14).
    let mut uart_config = usart::Config::default();
    uart_config.baudrate = 6_000_000;
    uart_config.tx_config = OutputConfig::OpenDrain;
    // Readback: each transaction reads its own echo and the reply in one transfer.
    let rb = HalfDuplexReadback::Readback;
    let mut seg_a =
        Uart::new_half_duplex(p.USART2, p.PB3, p.DMA1_CH3, p.DMA1_CH4, Irqs, uart_config, rb).unwrap();
    let mut seg_b =
        Uart::new_half_duplex(p.USART3, p.PB9, p.DMA1_CH5, p.DMA1_CH6, Irqs, uart_config, rb).unwrap();
    let mut seg_c =
        Uart::new_half_duplex(p.LPUART1, p.PA2, p.DMA1_CH7, p.DMA1_CH8, Irqs, uart_config, rb).unwrap();
    // Segment D: UART4 on PC10, free since the IMU moved to SPI2. Not wired on this robot; it is
    // here so the same bridge can drive a fourth line on another one.
    let mut seg_d =
        Uart::new_half_duplex(p.UART4, p.PC10, p.DMA2_CH3, p.DMA2_CH4, Irqs, uart_config, rb).unwrap();

    // Link to the compute module: USART1, full duplex, PA9 TX and PA10 RX (link.rs).
    let mut link_config = usart::Config::default();
    link_config.baudrate = link::LINK_BAUD;
    let link_uart = Uart::new(p.USART1, p.PA10, p.PA9, p.DMA2_CH1, p.DMA2_CH2, Irqs, link_config).unwrap();
    // Embassy turns the USART's hardware FIFO on, and with it on the DMA transmits sent
    // nothing after boot: the bytes left the FIFO but never reached PA9, until something
    // wrote TDR directly. With the FIFO off every frame goes out from the first one.
    // FIFOEN can only change with the USART disabled.
    {
        let r = embassy_stm32::pac::USART1;
        r.cr1().modify(|w| w.set_ue(false));
        r.cr1().modify(|w| w.set_fifoen(false));
        r.cr1().modify(|w| w.set_ue(true));
    }
    let (mut link_tx, link_rx) = link_uart.split();
    // About 6 ms of reception at 2 Mbps, several state requests and commands deep. A static
    // rather than a local: everything here lives in the one main task, which the executor
    // builds on the stack at startup, so its size eats into the stack. Keep large buffers
    // out of it.
    let link_rx_buf = cortex_m::singleton!(: [u8; 2048] = [0; 2048]).unwrap();
    let mut link_rx = link_rx.into_ring_buffered(link_rx_buf);

    // Status display on I2C1: SCL PA15, SDA PB7 (hardware.md 5.8). The module carries its own
    // pull-ups. The short timeout bounds the driver's busy-waits (display.rs).
    let mut i2c_config = i2c::Config::default();
    i2c_config.frequency = Hertz::khz(400);
    i2c_config.timeout = display::I2C_TIMEOUT;
    let display_i2c = I2c::new(p.I2C1, p.PA15, p.PB7, p.DMA2_CH5, p.DMA2_CH6, Irqs, i2c_config);

    // USB CDC ACM serial console.
    let driver = Driver::new(p.USB, Irqs, p.PA12, p.PA11);
    let mut usb_config = embassy_usb::Config::new(0x1209, 0x0001);
    usb_config.manufacturer = Some("Dukki");
    usb_config.product = Some("Dukki bridge");
    usb_config.serial_number = Some("bridge-bench");
    let mut config_descriptor = [0; 256];
    let mut bos_descriptor = [0; 256];
    let mut control_buf = [0; 64];
    let mut state = State::new();
    let mut builder = Builder::new(
        driver,
        usb_config,
        &mut config_descriptor,
        &mut bos_descriptor,
        &mut [],
        &mut control_buf,
    );
    let class = CdcAcmClass::new(&mut builder, &mut state, 64);
    let mut usb = builder.build();
    let (mut tx, mut rx) = class.split();

    let imu_shared = Cell::new(imu::Snapshot::default());
    let control = Cell::new(Control::default());
    let host = Cell::new(link::HostCommand::default());
    let arrived = segment::CommandArrived::new();
    let round_done = segment::RoundDone::new();
    let link_stats = Cell::new(link::LinkStats::default());
    let seg_shared: [Cell<SegmentStats>; segment::SEGMENTS] = Default::default();
    let display_stats = Cell::new(display::DisplayStats::default());
    let head_status = Cell::new(link::HeadStatus::default());
    let button_state = Cell::new(button::Button::default());

    // Raw: USART2, USART3, LPUART1 and UART4, and their data pins PB3, PB9, PA2 and PC10
    // (GPIOA at 0x4800_0000, GPIOB at 0x4800_0400, GPIOC at 0x4800_0800), for the polled loop.
    let raws = [
        Raw { uart: 0x4000_4400, gpio: 0x4800_0400, pin: 3 },
        Raw { uart: 0x4000_4800, gpio: 0x4800_0400, pin: 9 },
        Raw { uart: 0x4000_8000, gpio: 0x4800_0000, pin: 2 },
        Raw { uart: 0x4000_4c00, gpio: 0x4800_0800, pin: 10 },
    ];
    // The polled loop serves all four lines at once, about 1.7 µs a byte on each: the 8-byte
    // FIFOs give it slack. FIFOEN only changes with the UART disabled.
    for raw in raws {
        raw.enable_fifo();
    }
    let fifos = raws.map(|r| r.fifo_enabled());
    let [seg_a_shared, seg_b_shared, seg_c_shared, seg_d_shared] = &seg_shared;
    let servos = segment::run(
        [
            segment::Line { uart: &mut seg_a, raw: raws[0], shared: seg_a_shared },
            segment::Line { uart: &mut seg_b, raw: raws[1], shared: seg_b_shared },
            segment::Line { uart: &mut seg_c, raw: raws[2], shared: seg_c_shared },
            segment::Line { uart: &mut seg_d, raw: raws[3], shared: seg_d_shared },
        ],
        &control,
        &host,
        &arrived,
        &round_done,
    );
    let console = join(
        async {
            loop {
                tx.wait_connection().await;
                let _ = report(
                    &mut tx,
                    &imu_shared,
                    &seg_shared,
                    &control,
                    &host,
                    &link_stats,
                    &display_stats,
                    &head_status,
                    &button_state,
                    &power_state,
                    &fifos,
                    &mut led,
                )
                .await;
            }
        },
        async {
            loop {
                rx.wait_connection().await;
                let _ = commands(&mut rx, &control).await;
            }
        },
    );

    let link = link::run(&mut link_tx, &mut link_rx, &host, &arrived, &round_done, &seg_shared, &imu_shared, &link_stats, &head_status, &button_state);
    let sources = display::Sources {
        imu: &imu_shared,
        segs: &seg_shared,
        host: &host,
        head: &head_status,
        button: &button_state,
        power: &power_state,
    };
    let display = display::run(display_i2c, sources, &display_stats);
    let button = button::run(button_pin, &button_state);
    let power = power::run(power_hold, rail, p.IWDG, &power_state, &button_state, &host, &head_status);
    join(
        join5(usb.run(), imu::run(sensor, &mut int1, &imu_shared), servos, console, link),
        join3(display, button, power),
    )
    .await;
}

/// Single-key commands from the console.
async fn commands<'d>(
    rx: &mut Receiver<'d, Driver<'d, peripherals::USB>>,
    control: &Cell<Control>,
) -> Result<(), EndpointError> {
    let mut buf = [0u8; 64];
    loop {
        let n = rx.read_packet(&mut buf).await?;
        for &key in &buf[..n] {
            if key == b'U' {
                // Upper case only, so a stray key cannot do it. The servos stop by themselves
                // when commands stop: they latch their frame timeout.
                reset_to_bootloader();
            }
            if key == b'p' {
                let c = control.get();
                control.set(Control { polled: !c.polled, ..c });
                continue;
            }
            if key == b'a' {
                let c = control.get();
                control.set(Control { active_drive: !c.active_drive, ..c });
                continue;
            }
            if key == b'i' {
                let c = control.get();
                control.set(Control { immediate: !c.immediate, ..c });
                continue;
            }
            if key == b'g' {
                let c = control.get();
                let overlap = match c.overlap {
                    Overlap::Parallel => Overlap::Staggered,
                    Overlap::Staggered => Overlap::Serial,
                    Overlap::Serial => Overlap::Parallel,
                };
                control.set(Control { overlap, ..c });
                continue;
            }
            if key == b'z' {
                let c = control.get();
                control.set(Control { stats_reset: c.stats_reset.wrapping_add(1), ..c });
                continue;
            }
            if key == b'r' {
                let c = control.get();
                control.set(Control { rescan: c.rescan.wrapping_add(1), ..c });
                continue;
            }
            let mode = match key {
                b's' => TestMode::Stop,
                b'd' => TestMode::Damp,
                b'h' => TestMode::Hold,
                b'w' => TestMode::Wiggle,
                b'c' => TestMode::ClearFaults,
                _ => continue,
            };
            let c = control.get();
            control.set(Control { mode, generation: c.generation.wrapping_add(1), ..c });
        }
    }
}

fn mode_name(mode: TestMode) -> &'static str {
    match mode {
        TestMode::Stop => "stop",
        TestMode::Damp => "damp",
        TestMode::Hold => "hold",
        TestMode::Wiggle => "wiggle",
        TestMode::ClearFaults => "clear faults",
    }
}

async fn report<'d>(
    tx: &mut Sender<'d, Driver<'d, peripherals::USB>>,
    imu_shared: &Cell<imu::Snapshot>,
    seg_shared: &[Cell<SegmentStats>; segment::SEGMENTS],
    control: &Cell<Control>,
    host: &Cell<link::HostCommand>,
    link_stats: &Cell<link::LinkStats>,
    display_stats: &Cell<display::DisplayStats>,
    head_status: &Cell<link::HeadStatus>,
    button_state: &Cell<button::Button>,
    power_state: &Cell<power::Power>,
    fifos: &[bool; segment::SEGMENTS],
    led: &mut Output<'_>,
) -> Result<(), EndpointError> {
    let mut line = Line::new();
    let _ = write!(
        line,
        "\r\nDukki bridge bench test. Keys: s stop, d damp, h hold, w wiggle, c clear faults, r rescan, a active drive, p polled or DMA bus, i immediate rounds, g lines parallel, staggered or serial, z zero counters, U restart into the USB bootloader\r\n"
    );
    write_line(tx, &line).await?;
    let mut tick: u32 = 0;
    loop {
        Timer::after_millis(200).await;
        tick += 1;
        led.toggle();

        let mut line = Line::new();
        let c = control.get();
        let _ = write!(
            line,
            "-- mode {}  bus {}  drive {}  rounds on command {}  lines {}\r\n",
            mode_name(c.mode),
            if c.polled { "polled" } else { "DMA" },
            if c.active_drive { "active" } else { "open drain" },
            if c.immediate { "at once" } else { "next tick" },
            match c.overlap {
                Overlap::Parallel => "parallel",
                Overlap::Staggered => "staggered",
                Overlap::Serial => "serial",
            }
        );
        write_line(tx, &line).await?;

        let h = host.get();
        let l = link_stats.get();
        let mut line = Line::new();
        let driver = match h.received_us {
            None => "console (no compute module yet)",
            Some(at) if Instant::now().as_micros().saturating_sub(at) <= link::WATCHDOG.as_micros() => "compute module",
            Some(_) => "WATCHDOG: commands stopped, servos stopped",
        };
        let _ = write!(
            line,
            "link: servos follow {}  frames {} (commands {} of which targets {}, last seq {}, sample requests {}, state requests {}, info {})  sent {} bytes  errors: frames {} uart {} messages {}\r\n",
            driver, l.frames, l.commands, l.targets, h.command.seq, l.sample_requests, l.state_requests, l.info_requests, l.tx_bytes,
            l.frame_errors, l.uart_errors, l.bad_messages
        );
        write_line(tx, &line).await?;

        for ((name, cell), fifo) in SEGMENT_NAMES.iter().zip(seg_shared).zip(fifos) {
            let seg = cell.get();
            let mut line = Line::new();
            let _ = write!(line, "{} {} servo(s){}, ids", name, seg.count, if *fifo { "" } else { " NO FIFO" });
            for servo in &seg.servos[..seg.count] {
                let _ = write!(line, " {}", servo.id);
            }
            let _ = write!(
                line,
                "  scans {} (last: {} frames, echo bad {}, bytes {} to {})",
                seg.scans, seg.scan_frames, seg.scan_echo_bad, seg.scan_bytes_min, seg.scan_bytes_max
            );
            if seg.scanning {
                let _ = write!(line, "  [scanning]");
            }
            if seg.count > 0 {
                let _ = write!(
                    line,
                    "  command to first/last exchange {}/{} us (max {}/{})",
                    seg.apply_first_us, seg.apply_last_us, seg.apply_first_max_us, seg.apply_last_max_us
                );
            }
            if seg.garbled != 0 {
                let _ = write!(line, "  garbled replies from ids");
                for id in 0..15 {
                    if seg.garbled & (1 << id) != 0 {
                        let _ = write!(line, " {}", id);
                    }
                }
                let _ = write!(line, " (duplicate id?)");
            }
            let _ = write!(line, "\r\n");
            write_line(tx, &line).await?;

            for s in &seg.servos[..seg.count] {
                let mut line = Line::new();
                let ok = if s.sent > 0 { s.replies as f32 * 100.0 / s.sent as f32 } else { 0.0 };
                let _ = write!(
                    line,
                    "{} id {} ok {:5.1}% ({} sent, {} none (last {} bytes), {} bad, {} uart: {} noise {} framing {} overrun, {} echo)  rt {}/{} us",
                    name, s.id, ok, s.sent, s.no_reply, s.no_reply_bytes, s.bad_frames, s.uart_errors, s.noise, s.framing, s.overrun,
                    s.echo_mismatch, s.round_trip_us, s.round_trip_max_us
                );
                if let Some(st) = s.last {
                    let _ = write!(
                        line,
                        "  pos {:+7.3} spd {:+6.2} tq {:+6.3}  {:4.1} V  {}/{} C  mode {} to {} err {:#x} warn {}",
                        st.position, st.speed, st.torque, st.volts, st.temp, st.winding_temp,
                        st.mode, st.timeout as u8, st.error, st.warning
                    );
                }
                if s.recovering {
                    let _ = write!(line, "  [clearing timeout]");
                }
                if s.speed_trips > 0 {
                    let _ = write!(line, "  speed trips {}", s.speed_trips);
                }
                let _ = write!(line, "\r\n");
                write_line(tx, &line).await?;
            }
        }

        if tick % 5 == 0 {
            let s = imu_shared.get();
            let mut line = Line::new();
            match s.status {
                imu::Status::Running | imu::Status::BusError => {
                    let e = imu::euler_deg(imu::quaternion(&s.block));
                    let _ = write!(
                        line,
                        "IMU rpy {:+7.2} {:+7.2} {:+7.2}  n {}/{}  ovr {}  int1 to {}{}\r\n",
                        e[0], e[1], e[2], s.gyro_samples, s.rotation_samples, s.fifo_overruns, s.int1_timeouts,
                        if s.status == imu::Status::BusError { "  BUS ERROR" } else { "" }
                    );
                }
                imu::Status::Starting => {
                    let _ = write!(line, "IMU starting\r\n");
                }
                imu::Status::NotFound => {
                    let _ = write!(line, "IMU WHO_AM_I 0x{:02X}, not found\r\n", s.who_am_i);
                }
                imu::Status::ConfigFailed => {
                    let _ = write!(line, "IMU configuration failed\r\n");
                }
            }
            write_line(tx, &line).await?;

            let d = display_stats.get();
            let mut line = Line::new();
            let _ = write!(
                line,
                "OLED {}  frames {}  errors {}  longest hold {} us  longest char {} us  last frame {} us\r\n",
                if d.up { "up" } else { "down" }, d.frames, d.errors, d.slice_max_us, d.char_max_us, d.flush_us
            );
            write_line(tx, &line).await?;

            let mut line = Line::new();
            let _ = match d.battery_v {
                Some(v) => write!(line, "battery {:.2} V averaged  {}\r\n", v, if d.battery_low { "LOW" } else { "ok" }),
                None => write!(line, "battery: power off\r\n"),
            };
            write_line(tx, &line).await?;

            let now = Instant::now();
            let b = button_state.get();
            let mut line = Line::new();
            let _ = match link::head(&host.get(), &head_status.get(), now.as_micros()) {
                link::Head::NoLink => write!(line, "head: no link"),
                link::Head::Running(Some(t)) => write!(line, "head: running, CPU {:.1} C", t),
                link::Head::Running(None) => write!(line, "head: running, no temperature reported"),
                link::Head::Stalled => write!(line, "head: commands stopped (watchdog)"),
                link::Head::ShuttingDown => write!(line, "head: shutting down"),
                link::Head::Off => write!(line, "head: off, safe to cut power"),
            };
            let _ = write!(
                line,
                "  button {}  shutdown requests {}{}\r\n",
                if b.held_since.is_some() { "held" } else if b.down { "down, not counted" } else { "up" },
                b.requests,
                if b.request_pending(now) { " (pending)" } else { "" }
            );
            write_line(tx, &line).await?;

            let pw = power_state.get();
            let mut line = Line::new();
            let _ = write!(
                line,
                "power: hold {}  rail {:.1} V  (at boot: button {}, rail {:.1} V)\r\n",
                match pw.state {
                    power::State::Off => "off",
                    power::State::On => "on",
                    power::State::ShuttingDown { .. } => "on, shutting down",
                    power::State::Released { .. } => "released after shutdown",
                },
                pw.rail_v,
                if pw.boot_button { "down" } else { "up" },
                pw.boot_rail_v
            );
            write_line(tx, &line).await?;
        }
    }
}

/// Writes a line in packets of at most 64 bytes, the CDC endpoint size.
async fn write_line<'d>(
    tx: &mut Sender<'d, Driver<'d, peripherals::USB>>,
    line: &Line,
) -> Result<(), EndpointError> {
    for chunk in line.as_bytes().chunks(64) {
        tx.write_packet(chunk).await?;
    }
    // A full final packet needs a zero-length packet to end the transfer.
    if line.len % 64 == 0 {
        tx.write_packet(&[]).await?;
    }
    Ok(())
}
