lachlanhurst/dukki/src/bridge/src/link.rs

//! The link to the compute module: USART1, full duplex, PA9 (TX) to the CM4
//! carrier's header pin 18 and PA10 (RX) from pin 16, speaking
//! `duck-bridge-proto`.
//!
//! Every control tick the compute module sends a `SampleRequest` and, after its
//! policy runs, `Targets`. A sample request wakes the segments for a round at
//! once, and is answered with a `Sample` when a round that started after it
//! completes, so the positions in it are at most a round old. Targets replace
//! the positions in the last full `Command`, which arrives when a mode, gain or
//! action changes; both are stored for the segments, which are woken to apply
//! them at once rather than on their next 2 ms tick. A `StateRequest`, about
//! once a second, is answered at once from what the segments and the IMU
//! already hold. A `HostStatus` once a
//! second says what the compute module is doing, for the display, and
//! acknowledges a shutdown request from the button (button.rs), which the
//! replies carry as a flag until then. Reception is a circular
//! DMA buffer, which keeps receiving through the polled servo loop's
//! interrupts-off windows: an interrupt-driven receiver would lose bytes there.

use core::cell::Cell;

use duck_bridge_proto::{self as proto, FrameDecoder, Kind, Message};
use embassy_stm32::mode::Async;
use embassy_stm32::usart::{RingBufferedUartRx, UartTx};
use embassy_futures::select::{select, Either};
use embassy_time::{Duration, Instant};

use crate::button::Button;
use crate::imu;
use crate::segment::{self, CommandArrived, RoundDone, SegmentStats};

/// 168 MHz / 2 Mbps is an integer USART divider (84). 4 Mbps (42) is the planned
/// step up once the neck harness has been checked on a scope (hardware.md 5.5).
pub const LINK_BAUD: u32 = 2_000_000;

/// With no command for this long the segments stop every servo. Five ticks at
/// 50 Hz, ten at 100 Hz: long enough to ride out a scheduling hiccup on the
/// compute module, short enough that a crashed robotd cannot leave the robot
/// holding a stale pose.
pub const WATCHDOG: Duration = Duration::from_millis(100);

/// After the compute module reports shutting down, how long commands must have
/// stopped before the head counts as off. robotd stops commanding when systemd
/// stops it, early in the power-off; the rest of the power-off, unmounting and
/// halting, follows within seconds.
pub const OFF_AFTER: Duration = Duration::from_secs(20);

/// A `HostStatus` older than this, by the latest command, no longer counts.
const STATUS_STALE: Duration = Duration::from_secs(5);

/// The compute module's latest `HostStatus` and when it arrived.
#[derive(Clone, Copy, Default)]
pub struct HeadStatus {
    pub status: proto::HostStatus,
    /// Bridge clock when it arrived, µs; `None` until the first one.
    pub received_us: Option<u64>,
}

/// The head as the display and console describe it.
#[derive(Clone, Copy, PartialEq)]
pub enum Head {
    /// No command since the bridge started.
    NoLink,
    /// Commanding; the temperature if it has reported one.
    Running(Option<f32>),
    /// Commands stopped without a shutdown: robotd stopped or crashed.
    Stalled,
    ShuttingDown,
    /// Shut down and silent for `OFF_AFTER`: safe to cut the power.
    Off,
}

pub fn head(host: &HostCommand, head: &HeadStatus, now_us: u64) -> Head {
    let Some(commanded_us) = host.received_us else {
        return Head::NoLink;
    };
    let silent_us = now_us.saturating_sub(commanded_us);
    // A status counts while it is current with the commands: one that stopped arriving while
    // commands went on is from before a restart into software that does not send it.
    let status = head
        .received_us
        .filter(|&at| commanded_us.saturating_sub(at) < STATUS_STALE.as_micros())
        .map(|_| head.status);
    if status.is_some_and(|s| s.state == proto::HeadState::ShuttingDown) {
        return if silent_us >= OFF_AFTER.as_micros() { Head::Off } else { Head::ShuttingDown };
    }
    if silent_us > WATCHDOG.as_micros() {
        return Head::Stalled;
    }
    let temp = status
        .filter(|s| s.cpu_temp_dc != proto::TEMP_UNKNOWN)
        .map(|s| s.cpu_temp_dc as f32 / 10.0);
    Head::Running(temp)
}

/// The compute module's latest command and when it arrived.
#[derive(Clone, Copy)]
pub struct HostCommand {
    pub command: proto::Command,
    /// Bridge clock when it arrived, µs; `None` until the first one.
    pub received_us: Option<u64>,
}

impl Default for HostCommand {
    fn default() -> Self {
        Self { command: proto::Command::default(), received_us: None }
    }
}

/// What the link has seen, for the bench console.
#[derive(Clone, Copy, Default)]
pub struct LinkStats {
    pub frames: u32,
    pub commands: u32,
    /// Targets frames, counted in `commands` too.
    pub targets: u32,
    pub state_requests: u32,
    pub sample_requests: u32,
    pub info_requests: u32,
    /// Frames the decoder rejected (CRC, version, length).
    pub frame_errors: u32,
    /// Receive overruns and other UART errors.
    pub uart_errors: u32,
    /// Well-formed frames whose payload did not decode, or of a kind the bridge
    /// does not accept.
    pub bad_messages: u32,
    /// Bytes handed to the transmit DMA.
    pub tx_bytes: u32,
}

enum Request {
    Command(proto::Command),
    Targets(proto::Targets),
    State(proto::StateRequest),
    Sample(proto::SampleRequest),
    Info,
    HostStatus(proto::HostStatus),
}

pub async fn run(
    tx: &mut UartTx<'_, Async>,
    rx: &mut RingBufferedUartRx<'_>,
    host: &Cell<HostCommand>,
    arrived: &CommandArrived,
    round_done: &RoundDone,
    segs: &[Cell<SegmentStats>; segment::SEGMENTS],
    imu_shared: &Cell<imu::Snapshot>,
    stats: &Cell<LinkStats>,
    head: &Cell<HeadStatus>,
    button: &Cell<Button>,
) {
    let mut decoder = FrameDecoder::new();
    let mut chunk = [0u8; 256];
    let mut out = [0u8; proto::MAX_FRAME];
    let mut state_seq: u32 = 0;
    let mut sample_seq: u32 = 0;
    // A sample request waiting for a round that started after it arrived, and when it arrived.
    let mut pending: Option<(proto::SampleRequest, u64)> = None;
    let mut ls = LinkStats::default();

    loop {
        let read = match select(rx.read(&mut chunk), round_done.wait()).await {
            Either::First(read) => read,
            Either::Second(started_us) => {
                if let Some((req, _)) = pending.filter(|&(_, at)| started_us >= at) {
                    pending = None;
                    sample_seq = sample_seq.wrapping_add(1);
                    let mut sample = build_sample(sample_seq, req, &host.get(), segs, &imu_shared.get());
                    if button.get().request_pending(Instant::now()) {
                        sample.flags |= proto::state_flags::SHUTDOWN_REQUESTED;
                    }
                    if let Ok(len) = sample.encode(&mut out) {
                        let _ = tx.write(&out[..len]).await;
                        ls.tx_bytes += len as u32;
                    }
                    stats.set(ls);
                }
                continue;
            }
        };
        let n = match read {
            Ok(n) => n,
            Err(_) => {
                // The ring buffer stops on an error and restarts on the next read.
                ls.uart_errors += 1;
                stats.set(ls);
                continue;
            }
        };
        let mut taken = 0;
        while taken < n {
            taken += decoder.push(&chunk[taken..n]);
            loop {
                let request = match decoder.next_frame() {
                    None => break,
                    Some(frame) => {
                        ls.frames += 1;
                        match frame.kind {
                            Kind::Command => proto::Command::decode(&frame).map(Request::Command),
                            Kind::Targets => proto::Targets::decode(&frame).map(Request::Targets),
                            Kind::StateRequest => proto::StateRequest::decode(&frame).map(Request::State),
                            Kind::SampleRequest => proto::SampleRequest::decode(&frame).map(Request::Sample),
                            Kind::InfoRequest => proto::InfoRequest::decode(&frame).map(|_| Request::Info),
                            Kind::HostStatus => proto::HostStatus::decode(&frame).map(Request::HostStatus),
                            _ => Err(proto::Error::WrongKind),
                        }
                    }
                };
                match request {
                    Err(_) => ls.bad_messages += 1,
                    Ok(Request::Command(command)) => {
                        ls.commands += 1;
                        host.set(HostCommand { command, received_us: Some(Instant::now().as_micros()) });
                        arrived.signal(());
                    }
                    Ok(Request::Targets(t)) => {
                        ls.commands += 1;
                        ls.targets += 1;
                        // Everything but the positions stays as the last full command set it.
                        let mut command = host.get().command;
                        command.seq = t.seq;
                        command.host_time_us = t.host_time_us;
                        for (servo, position) in command.servos.iter_mut().zip(t.positions) {
                            servo.position = position;
                        }
                        host.set(HostCommand { command, received_us: Some(Instant::now().as_micros()) });
                        arrived.signal(());
                    }
                    Ok(Request::Sample(req)) => {
                        // A newer request replaces one still waiting: the compute module has
                        // given up on that one.
                        ls.sample_requests += 1;
                        pending = Some((req, Instant::now().as_micros()));
                        arrived.signal(());
                    }
                    Ok(Request::State(req)) => {
                        ls.state_requests += 1;
                        state_seq = state_seq.wrapping_add(1);
                        let errors = (decoder.errors + ls.uart_errors + ls.bad_messages) as u16;
                        let mut state = build_state(state_seq, req, &host.get(), segs, &imu_shared.get(), errors);
                        if button.get().request_pending(Instant::now()) {
                            state.flags |= proto::state_flags::SHUTDOWN_REQUESTED;
                        }
                        if let Ok(len) = state.encode(&mut out) {
                            let _ = tx.write(&out[..len]).await;
                            ls.tx_bytes += len as u32;
                        }
                    }
                    Ok(Request::HostStatus(status)) => {
                        head.set(HeadStatus { status, received_us: Some(Instant::now().as_micros()) });
                        if status.state == proto::HeadState::ShuttingDown {
                            // Acknowledged: stop asking.
                            let mut b = button.get();
                            b.requested_at = None;
                            button.set(b);
                        }
                    }
                    Ok(Request::Info) => {
                        ls.info_requests += 1;
                        if let Ok(len) = build_info(segs).encode(&mut out) {
                            let _ = tx.write(&out[..len]).await;
                            ls.tx_bytes += len as u32;
                        }
                    }
                }
            }
        }
        ls.frame_errors = decoder.errors;
        stats.set(ls);
    }
}

fn build_state(
    seq: u32,
    req: proto::StateRequest,
    host: &HostCommand,
    segs: &[Cell<SegmentStats>; segment::SEGMENTS],
    imu_snap: &imu::Snapshot,
    link_errors: u16,
) -> proto::State {
    let now_us = Instant::now().as_micros();
    let mut state = proto::State {
        seq,
        request_host_time_us: req.host_time_us,
        bridge_time_us: now_us,
        link_errors,
        imu: imu::imu_state(imu_snap, now_us),
        ..Default::default()
    };
    if let Some(at) = host.received_us {
        let age = now_us.saturating_sub(at);
        state.command_seq = host.command.seq;
        state.command_age_us = age.min(u32::MAX as u64) as u32;
        state.flags |= proto::state_flags::COMMANDED;
        if age > WATCHDOG.as_micros() {
            state.flags |= proto::state_flags::WATCHDOG;
        }
    }
    for s in &mut state.servos {
        s.segment = proto::ABSENT;
    }
    let mut rounds = u32::MAX;
    for (index, cell) in segs.iter().enumerate() {
        let seg = cell.get();
        for stats in &seg.servos[..seg.count] {
            if let Some(slot) = state.servos.get_mut(stats.id as usize) {
                *slot = segment::servo_state(index as u8, stats, now_us);
            }
        }
        if seg.count > 0 {
            rounds = rounds.min(seg.rounds);
            state.round_us = state.round_us.max(seg.round_us.min(u16::MAX as u32) as u16);
        }
    }
    state.rounds = if rounds == u32::MAX { 0 } else { rounds };
    state
}

fn build_sample(
    seq: u32,
    req: proto::SampleRequest,
    host: &HostCommand,
    segs: &[Cell<SegmentStats>; segment::SEGMENTS],
    imu_snap: &imu::Snapshot,
) -> proto::Sample {
    let now_us = Instant::now().as_micros();
    let imu = imu::imu_state(imu_snap, now_us);
    let mut sample = proto::Sample {
        seq,
        request_host_time_us: req.host_time_us,
        bridge_time_us: now_us,
        imu: proto::ImuSample {
            status: imu.status,
            block: imu.block,
            age_us: imu.age_us,
            rotation_samples: imu.rotation_samples,
        },
        ..Default::default()
    };
    if let Some(at) = host.received_us {
        let age = now_us.saturating_sub(at);
        sample.command_seq = host.command.seq;
        sample.command_age_us = age.min(u32::MAX as u64) as u32;
        sample.flags |= proto::state_flags::COMMANDED;
        if age > WATCHDOG.as_micros() {
            sample.flags |= proto::state_flags::WATCHDOG;
        }
    }
    for s in &mut sample.servos {
        s.segment = proto::ABSENT;
    }
    for (index, cell) in segs.iter().enumerate() {
        let seg = cell.get();
        for stats in &seg.servos[..seg.count] {
            if let Some(slot) = sample.servos.get_mut(stats.id as usize) {
                *slot = segment::servo_sample(index as u8, stats, now_us);
            }
        }
    }
    sample
}

fn build_info(segs: &[Cell<SegmentStats>; segment::SEGMENTS]) -> proto::Info {
    let mut info = proto::Info {
        protocol_version: proto::PROTOCOL_VERSION,
        sysclk_mhz: 168,
        link_baud: LINK_BAUD,
        watchdog_ms: WATCHDOG.as_millis() as u16,
        segments: [proto::ABSENT; proto::NUM_SERVOS],
        ..Default::default()
    };
    let version = concat!("bridge ", env!("CARGO_PKG_VERSION")).as_bytes();
    info.firmware[..version.len()].copy_from_slice(version);
    for (index, cell) in segs.iter().enumerate() {
        let seg = cell.get();
        for stats in &seg.servos[..seg.count] {
            if let Some(slot) = info.segments.get_mut(stats.id as usize) {
                *slot = index as u8;
            }
        }
    }
    info
}
