lachlanhurst/dukki/scripts/kicad/tidy_head_pcb.py

#!/usr/bin/env python3
"""Tidy the routed head board: remove the ground stitching, straighten and widen the autorouted
tracks, then stitch again sparingly.

1. Unlocked ground vias with no track on them (the stitching grid) are removed.
1b. Unlocked ground tracks are removed: the pours carry ground.
2. Wherever exactly two unlocked segments of one net meet on one layer, with no pad or via at the
   joint, they are replaced by one straight segment if it clears every other net's copper by the
   larger of the two net classes' clearances and stays out of the keep-outs. Repeated until nothing
   changes: this takes out Freerouting's small jogs and the maze router's staircase.
3. Every unlocked segment narrower than its net class is widened to it where it fits.
4. Ground stitching again: a 3.5 mm grid, plus rows beside the camera pairs, only where both ground
   pours are filled; then the pours are refilled.

Runs on the KiCad VM after route_head_pcb.py and finish_head_pcb.py (and route_one_net.py), one
stage per process (pcbnew's Python crashes when a long edit session reuses wrappers of tracks it
added), the straightening repeated until it reports 0:
    python3 scripts/kicad/tidy_head_pcb.py unstitch
    python3 scripts/kicad/tidy_head_pcb.py unground
    python3 scripts/kicad/tidy_head_pcb.py dedupe
    python3 scripts/kicad/tidy_head_pcb.py undangle       # after a rip-up: stubs and lone vias, until 0
    python3 scripts/kicad/tidy_head_pcb.py straighten      # until "0 joints straightened"
    python3 scripts/kicad/tidy_head_pcb.py widen
    python3 scripts/kicad/tidy_head_pcb.py stitch
A second argument picks the board: `head_ext` tidies the external IMU head board, `bridge` tidies the bridge carrier after route_bridge_pcb.py
(its stitching comes from that script, so the stitch stage replaces it the same way).
"""
import math, sys
from pathlib import Path
import pcbnew

BOARD = sys.argv[2] if len(sys.argv) > 2 else "head"
PCB = Path(f"hardware/{BOARD}/{BOARD}.kicad_pcb")
O = (100.0, 50.0)
W, H = {"head": (80.0, 55.0), "head_ext": (80.0, 55.0), "bridge": (45.0, 80.0)}[BOARD]
HOLE_INSET = {"head": 3.0, "head_ext": 3.0, "bridge": 3.5}[BOARD]
mm, tomm = pcbnew.FromMM, pcbnew.ToMM
STAGE = sys.argv[1]
b = pcbnew.LoadBoard(str(PCB))
LAYERS = (pcbnew.F_Cu, pcbnew.B_Cu)

def pt(x, y):
    return pcbnew.VECTOR2I(mm(O[0] + x), mm(O[1] + y))

# ------------------------------------------------------------------ 1. stitching off
if STAGE == "unstitch":
    tracks = [t for t in b.GetTracks()]
    ends = {}
    for t in tracks:
        if t.Type() == pcbnew.PCB_TRACE_T:
            for p in (t.GetStart(), t.GetEnd()):
                ends.setdefault((p.x, p.y), []).append(t)
    removed = 0
    for v in [t for t in tracks if t.Type() == pcbnew.PCB_VIA_T and not t.IsLocked() and t.GetNetname() == "GND"]:
        if not ends.get((v.GetPosition().x, v.GetPosition().y)):
            b.Remove(v); removed += 1
    print("stitching vias removed:", removed)
    for z in b.Zones():
        if not z.GetIsRuleArea():
            z.UnFill()

# ------------------------------------------------------------------ 1b. ground tracks off
# Freerouting routes GND as tracks before any pour exists; on the finished board they only duplicate
# the pours and show as copper across the ground pads' thermal-relief gaps. All unlocked GND tracks
# go (the hand-drawn ones are locked and stay); the pours then reach every ground pad, checked by
# DRC. C9's ground pad gets a solid connection: with its track gone too few spokes reached the pour.
if STAGE == "unground":
    # keep ground tracks into the module sockets' pads: their inner rows are boxed in, and a pad there
    # may have no other way to the pour (J9 pad 60 lost its only connection on 16/10/2026)
    socket = [p for r in ("J9", "J10") if b.FindFootprintByReference(r) for p in b.FindFootprintByReference(r).Pads()]
    def on_socket(t):
        return any(p.HitTest(t.GetStart()) or p.HitTest(t.GetEnd()) for p in socket)
    gt = [t for t in b.GetTracks() if t.Type() == pcbnew.PCB_TRACE_T and t.GetNetname() == "GND" and not t.IsLocked()
          and not on_socket(t)]
    for t in gt:
        b.Remove(t)
    print("ground tracks removed:", len(gt))
    for ref, num in (("C9", "2"), ("C15", "2")):      # C15 is not on the external IMU board
        if b.FindFootprintByReference(ref):
            b.FindFootprintByReference(ref).FindPadByNumber(num).SetLocalZoneConnection(pcbnew.ZONE_CONNECTION_FULL)

# ------------------------------------------------------------------ 1c. duplicates
# Freerouting hands locked tracks back as second copies, and leaves zero-length segments.
if STAGE == "dedupe":
    groups, drop, zero = {}, set(), 0
    for t in b.GetTracks():
        if t.Type() != pcbnew.PCB_TRACE_T:
            continue
        s_, e_ = (t.GetStart().x, t.GetStart().y), (t.GetEnd().x, t.GetEnd().y)
        uid = t.m_Uuid.AsString()
        if s_ == e_:
            drop.add(uid); zero += 1
            continue
        k = (t.GetLayer(), t.GetNetCode(), t.GetWidth()) + tuple(sorted((s_, e_)))
        groups.setdefault(k, []).append((t.IsLocked(), uid))
    dup = 0
    for members in groups.values():
        members.sort(reverse=True)            # a locked copy first: keep it
        for _, uid in members[1:]:
            drop.add(uid); dup += 1
    for t in [t for t in b.GetTracks() if t.m_Uuid.AsString() in drop]:
        b.Remove(t)
    print(f"duplicates removed: {dup}, zero-length: {zero}")
    pcbnew.SaveBoard(str(PCB), b)              # save and stop here: touching the zones after these
    sys.exit(0)                                # removals crashes pcbnew's Python

# ------------------------------------------------------------------ 1d. dangling ends
# After a rip-up: unlocked segments with a free end, and unlocked non-ground vias with copper on
# fewer than two layers, removed until none are left. A third argument `all` takes locked ones too
# (after rip_under_pads.py, whose cuts leave locked pieces hanging).
if STAGE == "undangle":
    ALL = len(sys.argv) > 3 and sys.argv[3] == "all"
    # one pass per process, repeated by the caller until it removes nothing: rebuilding connectivity
    # after removals in the same session segfaults pcbnew's Python
    total = 0
    for _ in range(1):
        b.BuildConnectivity()
        con = b.GetConnectivity()
        drop = [t.m_Uuid.AsString() for t in b.GetTracks() if t.Type() == pcbnew.PCB_TRACE_T
                and (ALL or not t.IsLocked()) and t.GetNetname() != "GND"      # ground ends in the pour
                and con.TestTrackEndpointDangling(t, False)]
        for v in b.GetTracks():
            if v.Type() == pcbnew.PCB_VIA_T and (ALL or not v.IsLocked()) and v.GetNetname() != "GND":
                layers = {t.GetLayer() for t in b.GetTracks() if t.Type() == pcbnew.PCB_TRACE_T
                          and t.GetNetCode() == v.GetNetCode() and v.GetPosition() in (t.GetStart(), t.GetEnd())}
                # a via inside a same-net pad joins it on the pad's layers with no track (TP7's
                # via on the servo PWM): count those layers too
                layers |= {l for f in b.GetFootprints() for p in f.Pads() if p.GetNetCode() == v.GetNetCode()
                           and p.HitTest(v.GetPosition()) for l in (pcbnew.F_Cu, pcbnew.B_Cu) if p.IsOnLayer(l)}
                if len(layers) < 2:
                    drop.append(v.m_Uuid.AsString())
        if not drop:
            break
        for t in [t for t in b.GetTracks() if t.m_Uuid.AsString() in drop]:
            b.Remove(t)
        total += len(drop)
    print("dangling removed:", total)
    pcbnew.SaveBoard(str(PCB), b)
    sys.exit(0)

# ------------------------------------------------------------------ obstacle checks
rules = [z for z in b.Zones() if z.GetIsRuleArea() and z.GetDoNotAllowTracks()]
rules += [z for f in b.GetFootprints() for z in f.Zones() if z.GetIsRuleArea() and z.GetDoNotAllowTracks()]
# locked copper areas (the head's 5 V pad over the module's pins) are obstacles to other nets: the
# pours are unfilled during these stages, so without this a straightened track could cut one in two
fixed = [z for z in b.Zones() if not z.GetIsRuleArea() and z.IsLocked()]
pads = [p for fp in b.GetFootprints() for p in fp.Pads()]
holes = [p for p in pads if p.HasHole()]

# net classes by net name, from the board's own rules (a track not yet on the board reports the
# default class, so its own lookup cannot be trusted)
NS = b.GetDesignSettings().m_NetSettings
def netclass(item):
    return NS.GetEffectiveNetClass(item.GetNetname())

def clearance_of(item):
    if item.Type() != pcbnew.PCB_PAD_T and not hasattr(item, "GetNetname"):
        return mm(0.2)
    try:
        if item.GetNetCode() <= 0:
            return mm(0.2)
    except Exception:
        return mm(0.2)
    return netclass(item).GetClearance()

def width_of_class(item):
    return netclass(item).GetTrackWidth()

EDGE = mm(0.3)
def fits(seg, ignore):
    """seg: a PCB_TRACK, on the board or not; ignore: UUIDs of items to leave out (the ones it replaces). True if it clears every other net's copper on its layer,
    the holes, the keep-outs and the board edge."""
    layer, net = seg.GetLayer(), seg.GetNetCode()
    shape = seg.GetEffectiveShape(layer)
    half = seg.GetWidth() // 2
    for p in (seg.GetStart(), seg.GetEnd()):
        x, y = tomm(p.x) - O[0], tomm(p.y) - O[1]
        if min(x, y, W - x, H - y) < tomm(EDGE + half):
            return False
    bb = seg.GetBoundingBox()
    bb.Inflate(mm(0.8))
    cl_self = clearance_of(seg)
    for it in candidates(layer):
        if it.GetNetCode() == net or it.m_Uuid.AsString() in ignore:
            continue
        if not bb.Intersects(it.GetBoundingBox()):
            continue
        cl = max(cl_self, clearance_of(it))
        if it.GetEffectiveShape(layer).Collide(shape, cl - 1):
            return False
    for h in holes:
        if h.GetNetCode() != net and bb.Intersects(h.GetBoundingBox()):
            if h.GetEffectiveHoleShape().Collide(shape, mm(0.25)):
                return False
    for z in rules:
        if z.IsOnLayer(layer) and z.Outline().Collide(pcbnew.SEG(seg.GetStart(), seg.GetEnd()), half):
            return False
    for z in fixed:
        if z.GetNetCode() != net and z.IsOnLayer(layer) and \
                z.Outline().Collide(pcbnew.SEG(seg.GetStart(), seg.GetEnd()), half + cl_self):
            return False
    return True

FP_COPPER = [g for f in b.GetFootprints() for g in f.GraphicalItems()   # jumper bridges and the like
             if g.IsOnLayer(pcbnew.F_Cu) or g.IsOnLayer(pcbnew.B_Cu)]
def candidates(layer):
    out = [p for p in pads if p.IsOnLayer(layer)]
    out += [g for g in FP_COPPER if g.IsOnLayer(layer)]
    out += [t for t in b.GetTracks() if t.IsOnLayer(layer)]
    return out

def temp_track(a, c, layer, net, width):
    t = pcbnew.PCB_TRACK(b)
    t.SetStart(a); t.SetEnd(c); t.SetLayer(layer); t.SetNet(net); t.SetWidth(width)
    return t

def anchored(p, layer, net, pair):
    """A via or a pad of the net at p: the joint is a real connection, not a free bend. (Letting a pad
    go when another segment also reached it cut a pad out of its net on the bridge: within one sweep
    that other segment could be the merge just made through the same pad.)"""
    for v in b.GetTracks():
        if v.Type() == pcbnew.PCB_VIA_T and v.GetPosition() == p:
            return True
    for pd in pads:
        if pd.GetNetCode() == net and pd.IsOnLayer(layer) and pd.HitTest(p):
            return True
    return False

# ------------------------------------------------------------------ 2. straighten
merged = 0
for sweep in range(1 if STAGE == "straighten" else 0):
    changed = 0
    joints = {}
    for t in b.GetTracks():
        if t.Type() == pcbnew.PCB_TRACE_T:
            for p in (t.GetStart(), t.GetEnd()):
                joints.setdefault((p.x, p.y, t.GetLayer()), []).append(t)
    done = set()
    for (x, y, layer), ts in joints.items():
        if len(ts) != 2:
            continue
        t1, t2 = ts
        if t1.IsLocked() or t2.IsLocked() or t1.GetNetCode() != t2.GetNetCode():
            continue
        if id(t1) in done or id(t2) in done:
            continue
        p = pcbnew.VECTOR2I(x, y)
        if anchored(p, layer, t1.GetNetCode(), {t1.m_Uuid.AsString(), t2.m_Uuid.AsString()}):
            continue
        a = t1.GetEnd() if t1.GetStart() == p else t1.GetStart()
        c = t2.GetEnd() if t2.GetStart() == p else t2.GetStart()
        if a == c:
            continue
        width = max(t1.GetWidth(), t2.GetWidth(), width_of_class(t1))
        new = temp_track(a, c, layer, t1.GetNet(), width)
        if not fits(new, {t1.m_Uuid.AsString(), t2.m_Uuid.AsString()}):
            width = max(t1.GetWidth(), t2.GetWidth())
            new = temp_track(a, c, layer, t1.GetNet(), width)
            if not fits(new, {t1.m_Uuid.AsString(), t2.m_Uuid.AsString()}):
                continue
        b.Remove(t1); b.Remove(t2); b.Add(new); new.thisown = 0
        done.update((id(t1), id(t2)))
        changed += 1
    merged += changed
    print(f"sweep {sweep}: {changed} joints straightened", flush=True)
    if not changed:
        break

# ------------------------------------------------------------------ 3. widen
widened = narrow = 0
for t in [t for t in b.GetTracks() if STAGE == "widen" and t.Type() == pcbnew.PCB_TRACE_T and not t.IsLocked()]:
    want = width_of_class(t)
    if t.GetWidth() >= want:
        continue
    narrow += 1
    old = t.GetWidth()
    t.SetWidth(want)
    if fits(t, {t.m_Uuid.AsString()}):
        widened += 1
    else:
        t.SetWidth(old)
if STAGE == "widen":
    print(f"widened {widened} of {narrow} narrow segments")

# ------------------------------------------------------------------ 4. sparse stitching
filler = pcbnew.ZONE_FILLER(b)
if STAGE != "stitch":
    for z in b.Zones():
        if not z.GetIsRuleArea():
            z.UnFill()
    pcbnew.SaveBoard(str(PCB), b)
    print("saved", PCB, "after", STAGE)
    sys.exit(0)
# ground fragments that no via or pad reaches are dropped rather than left floating
for z in b.Zones():
    if not z.GetIsRuleArea() and z.GetNetname() == "GND" and hasattr(pcbnew, "ISLAND_REMOVAL_MODE_ALWAYS"):
        z.SetIslandRemovalMode(pcbnew.ISLAND_REMOVAL_MODE_ALWAYS)
filler.Fill(b.Zones())
gnd = b.FindNet("GND")
others = list(pads)                           # every pad, ground ones too: no via in a pad
others += [t for t in b.GetTracks() if t.GetNetCode() != gnd.GetNetCode()]
drilled = [p for p in holes] + [t for t in b.GetTracks() if t.Type() == pcbnew.PCB_VIA_T]
p5 = [z.Outline() for z in b.Zones() if not z.GetIsRuleArea() and z.GetNetname() == "+5V"]
corner_holes = [(x, y) for x in (HOLE_INSET, W - HOLE_INSET) for y in (HOLE_INSET, H - HOLE_INSET)]
added = []
def place(x, y, spacing):
    q = pt(x, y)
    if any((x - hx) ** 2 + (y - hy) ** 2 < 3.4 ** 2 for hx, hy in corner_holes):
        return
    if any(o.Contains(q) for o in p5):
        return
    v = pcbnew.PCB_VIA(b)
    v.SetPosition(q); v.SetWidth(mm(0.6)); v.SetDrill(mm(0.3)); v.SetNet(gnd)
    for o in added:
        if (o.GetPosition() - q).EuclideanNorm() < mm(spacing):
            return
    for d in drilled:
        if v.GetEffectiveShape(pcbnew.F_Cu).Collide(d.GetEffectiveShape(pcbnew.F_Cu), mm(0.4)):
            return
    for it in others:
        for L in LAYERS:
            if it.IsOnLayer(L) and v.GetEffectiveShape(L).Collide(it.GetEffectiveShape(L), mm(0.25)):
                return
    b.Add(v); v.thisown = 0; added.append(v)
# rows beside the camera pairs first: the pairs' coplanar ground, about 1 mm out, every 2.5 mm
csi = [t for t in b.GetTracks() if t.Type() == pcbnew.PCB_TRACE_T and t.GetNetname().startswith("/CSI_")]
for t in csi:
    a, c = t.GetStart(), t.GetEnd()
    ax, ay, cx, cy = tomm(a.x) - O[0], tomm(a.y) - O[1], tomm(c.x) - O[0], tomm(c.y) - O[1]
    n = max(1, int(math.hypot(cx - ax, cy - ay) / 2.5))
    dx, dy = (cx - ax), (cy - ay)
    ln = math.hypot(dx, dy) or 1
    nx_, ny_ = -dy / ln, dx / ln
    for k in range(n + 1):
        x, y = ax + dx * k / n, ay + dy * k / n
        for s in (0.9, -0.9):
            place(x + nx_ * s, y + ny_ * s, 2.0)
y = 1.75
while y < H - 1.0:
    x = 1.75
    while x < W - 1.0:
        place(x, y, 3.0)
        x += 3.5
    y += 3.5
filler.Fill(b.Zones())
gz = {z.GetLayer(): z for z in b.Zones() if not z.GetIsRuleArea() and z.GetNetname() == "GND"}
if len(gz) < 2:
    raise SystemExit("no ground pours on both layers: run route_head_pcb.py first")
kept = 0
for v in added:
    if all(gz[L].HitTestFilledArea(L, v.GetPosition()) for L in LAYERS):
        kept += 1
    else:
        b.Remove(v)
filler.Fill(b.Zones())
# second pass: any ground fragment (either layer) with no via in it gets one, on a 1 mm grid inside it,
# so no piece of pour is left floating
gz = {z.GetLayer(): z for z in b.Zones() if not z.GetIsRuleArea() and z.GetNetname() == "GND"}
gvias = [v for v in b.GetTracks() if v.Type() == pcbnew.PCB_VIA_T and v.GetNetCode() == gnd.GetNetCode()]
extra = 0
for L in LAYERS:
    polys = gz[L].GetFilledPolysList(L)
    for i in range(polys.OutlineCount()):
        outline = polys.Outline(i)
        if any(outline.PointInside(v.GetPosition()) for v in gvias):
            continue
        bb = outline.BBox()
        x = tomm(bb.GetX()) - O[0] + 0.5
        placed = False
        while not placed and x < tomm(bb.GetRight()) - O[0]:
            y = tomm(bb.GetY()) - O[1] + 0.5
            while not placed and y < tomm(bb.GetBottom()) - O[1]:
                if outline.PointInside(pt(x, y)):
                    n0 = len(added)
                    place(x, y, 0.0)
                    if len(added) > n0:
                        v = added[-1]
                        other = LAYERS[1] if L == LAYERS[0] else LAYERS[0]
                        if gz[other].HitTestFilledArea(other, v.GetPosition()):
                            placed = True; extra += 1; gvias.append(v)
                        else:
                            b.Remove(v); added.pop()
                y += 0.25
            x += 0.25          # fine: a fragment can be a strip barely wider than a via
filler.Fill(b.Zones())
print(f"straightened {merged} joints; stitching vias: {kept} + {extra} into otherwise floating pieces")
pcbnew.SaveBoard(str(PCB), b)
print("saved", PCB)
