lachlanhurst/dukki/(commit log)

2026-09-10 hardware change to use radxa cm4 module, stm32 based driver for servo comms
2026-09-15 updated hardware docs with inclusion of head IMU
2026-09-19 draft autogenerated footprint of stm32 bridge
2026-09-19 hookup details for stm32 bridge
2026-09-24 camera (imx219) setup
2026-09-24 audio (max98357a speaker, inmp441 mic) setup
    SAI2 overlay with a dummy-codec simple card on the NANO-A header, ALSA
    defaults with softvol, dmix and dsnoop at 48 kHz S32_LE, and a setup
    script with check and test modes. Speaker and mic verified on the board.
2026-09-24 docs: head i2c setup script, pull-ups, remaining overlay gaps
    List setup-head-i2c.sh in the compute setup scripts table, point the
    known gaps at the camera, head i2c and audio scripts (UART7 still to do),
    and correct the ToF pull-up advice to match the i2c8 overlay.
2026-09-24 robotctl, tofd and fake robotd hand install; monitor running on the board
2026-09-24 mediad on the RK3576: media stack setup, full-frame camera, monitor camera block working
2026-09-24 mediad: camera mount angle 0 on this board, set by CAMERA_ROTATE
2026-09-27 j288 test results so far
    Just stall torque testing for now
    [explore.py]
2026-09-30 j288 test code and BAM calibration results
2026-10-02 J288 gear play test, and a trained policy on the pendulum
    explore.py backlash: torque cycles with the output clamped, zero-current
    rests to read the output encoder. j288-testing.md sections 16 and 17:
    the bench sim2real runs and the gear play (about 6 mrad inside the
    servo; the output encoder appears to be disturbed by winding current,
    not yet confirmed).
    [explore.py]
2026-10-03 Head BMI088 wired on I2C8 and detected by tofd
    The module arrived with its PS link in the SPI position, which leaves the accelerometer on I2C
    and takes the gyroscope off it; moved to IIC, i2cdetect shows 0x18, 0x29 and 0x68 with the
    right chip IDs. The driver change became address detection by chip ID rather than a config key
    (`../bmi088-rs` branch `configurable-addresses`, which also fixes the temperature sign), and
    `tofd --imu` streams at 100 Hz.
2026-10-03 Eye LED on SPI1, and the eyed daemon
    A WS2812-type LED in the head, data on header pin 19 (SPI1 MOSI), 5 V from pins 2 or 4.
    setup-eye.sh installs the SPI1 overlay and a udev rule for /dev/spidev-eye; eye-test.py checks
    the colour order with no daemon. push-daemons.sh learns eyed, whose crate is on the microduck
    dukki branch. eye-setup.md covers the wiring, the layer stack and the socket protocol.
2026-10-03 Track the VS Code spell-check word list
2026-10-03 Rename the eye setup to express, after the microduck daemon
    eyed became expressd (crate express) because it is about to drive the head fan too.
    setup-eye.sh is setup-express.sh, scripts/compute/eye is scripts/compute/express, and
    eye-setup.md is express-setup.md. The overlay and /dev/spidev-eye keep their names: they are
    still the eye's.
2026-10-03 Head fan on PWM1 channel 2, header pin 11, driven by expressd
    The fan is a 2-wire 5 V fan on a low-side MOSFET; its speed is the duty of PWM1 channel 2. The
    microduck-nano-a-pwm-fan overlay enables the channel and setup-express.sh installs it with a udev
    rule that gives its sysfs files to the robot group. Verified with an LED standing in for the
    MOSFET: full, bursts, and the cooling floor.
    Header pin 11, not 33: Radxa's device tree labels GPIO1_C2 PIN_33 and GPIO1_C4 PIN_11, and on this
    module and carrier they are the other way round (measured). hardware.md's pin table records both,
    and express-setup.md records how to find a pin safely: a bulk scan of GPIO lines remuxed the
    eMMC's pins and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
2026-10-03 hardware.md: the eye LED and head fan in the design table, the 5 V row and the head contents
2026-10-03 camera-setup.md: a mediad restart can, rarely, crash the vendor ISP driver
    Seen once during a deploy; a reboot recovers it. Recorded with the log lines to look for and
    what to try if it recurs.
2026-10-03 Bridge firmware: embassy blinky for the WeAct G474 board, flashed over USB DFU
    A standalone embassy-stm32 crate in src/bridge for the STM32G474CEU6 that blinks the board's
    blue LED on PC6, one second on and one off, to prove the toolchain and the flashing path.
    flash.sh builds a .bin and writes it with dfu-util after the board is put in its ROM
    bootloader (hold BOOT, tap RST). The chip needs the dual-bank feature, the factory option-byte
    setting. Verified on the board.
2026-10-03 hardware.md: the bridge board is the QFN48 WeAct variant; pins moved off its flash chip
    The delivered WeAct G474 board carries the STM32G474CEU6 (QFN48), not the LQFP48 part the
    15/09/2026 revision was drawn from. It brings out PC4, PC6, PC10 and PC11, has its blue LED on
    PC6, and adds a W25Q64 QSPI flash on PA6, PA7, PB0, PB1, PB10 and PB11. Its schematic and
    outline are added to docs/datasheets.
    Section 5.8 now keeps all six flash pins unused: the trunk IMU moves to SPI3 (PC10, PC11, PB5,
    CS on PA15, INT1 on PA8), the pack voltage to PA0 and segment C's buffered DE to PB12. The
    servo data pins and the compute link do not move. UART4 on PC10 and PC11 becomes segment C's
    fallback. Pins chec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
2026-10-03 Bridge firmware: LSM6DSV16X bench test on SPI3, readings over USB serial
    Replaces the blinky. The bridge reads the trunk IMU over SPI3 (PC10, PC11, PB5, CS on PA15)
    with raw register access, takes data-ready on INT1 (PA8), and prints accel, gyro and
    temperature at 10 Hz on a USB CDC serial port; the LED on PC6 toggles with each line or
    blinks fast if WHO_AM_I is wrong. USB runs from HSI48 trimmed by the CRS. embassy-stm32
    needs its exti feature for the interrupt input.
    On the bench: WHO_AM_I 0x70, no INT1 timeouts at 120 Hz, gravity 0.99 g. After a DFU flash
    the board needs a reset before it enumerates.
    [main.rs]
2026-10-03 Bridge firmware: trunk IMU through ST's lsm6dsv16x-rs driver with SFLP fusion
    The raw register test is replaced by ST's async driver on SPI3 with DMA. The chip runs the
    configuration the compute side decodes (hardware.md 6.1): gyro +-500 dps and the SFLP game
    rotation vector at 120 Hz, with gravity and gyro bias, all through the FIFO and a four-entry
    threshold on INT1. Each interrupt drains the FIFO into the 12-byte block duck-control/imu.rs
    reads. IMU reading and the USB serial report run separately so a closed port cannot stall
    the FIFO; the report decodes the quaternion to roll, pitch and yaw for checking by eye.
    bisync, which the driver and st-mems-bus depend on, was archived and yanked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
    [main.rs]
2026-10-03 hardware.md: trunk IMU at rest, SFLP bias settles and yaw drifts 0.08°/min
    Three minutes still on the bench: the SFLP gyro bias estimate held within 5 mdps of the
    measured gyro offset, yaw drifted 0.08°/min, roll and pitch under 0.07°/min, gravity
    999.4 ± 0.3 mg, 119 Hz with no FIFO overruns. Closes the open item in section 13.
2026-10-04 Bridge firmware: J288 servo bus on all three segments, polled single-wire at 6 Mbps
    j288.rs ports the J288 protocol from bam's digital_servo.py (frames, Unitree's CRC32, reply
    parsing in output-side SI units), with host tests against frames from the Python driver.
    segment.rs polls one servo per segment at 500 Hz: each transaction sends the 20-byte
    command with the receiver on and collects the echo and the 26-byte reply in one 46-byte read,
    clears a latched frame timeout at first contact and after any 200 ms gap, and runs bench test
    modes (stop, damp, hold, wiggle, clear faults) chosen from the USB console, with a 10 rad/s
    speed trip. The IMU code moves to imu.rs unchanged.
    The core now runs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
2026-10-04 hardware.md: the J288 bus is 5 V; pull-ups to VCC, power sequencing, first bus results
    Measured on an idle line: Unitree's adapter idles the bus at 5.2 V, and a servo alone pulls
    its SIGNAL weakly to 4.5 to 5 V. Section 5.6 now puts each segment's pull-up on the bridge's
    VCC (1 k on the bench, 470 to 680 R for five servos), requires the internal pull-up off on
    the FT data pins, moves the clamp to a 5.6 V zener, and explains why the pull-up to VCC
    keeps the pins safe whichever side powers first, so the robot's single battery switch is
    fine. Section 5.8 describes the echo-and-reply transaction and the polled loop.
    Sections 12 and 13 close the signal-level item, record one servo per segment ru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
2026-10-04 Bridge firmware: five servos per segment, ID discovery and active drive
    Each segment now scans IDs 0 to 14 with stop frames at startup, on the r key and every
    second while it has found none, then polls every servo it found each 2 ms tick with its own
    statistics, hold origin, timeout recovery and speed trip. A valid reply from the wrong ID
    counts as a bad frame, and IDs that answer only with corrupt frames are reported as a
    possible duplicate. The scan reports echo mismatches and bytes received per frame.
    The polled loop drives the data pin push-pull while sending each command and switches it
    back to open drain on transmission complete, before the servo replies, so no pull-up is
    needed. With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
    [main.rs, segment.rs]
2026-10-04 hardware.md: active drive, no pull-ups, five servos per segment verified
    The 1 k pull-up to VCC worked for one servo per segment but not for several: with three on
    a segment one servo missed 9% of its replies, with five none answered, and removing the
    pull-up left the bridge's own open-drain edges too slow. Section 5.6 now makes active drive
    the design (push-pull while transmitting, open drain for the reply, no pull-up), records
    how it was found, and turns power sequencing into an open item: without the pull-up to VCC,
    a servo powered before the bridge puts about 4.5 V on an unpowered pin. A weak pull-up to
    VCC is the likely fix, sized once the servos' own pull-up is measured.
    Section 5.8 c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
2026-10-05 Bridge firmware: the link to the compute module over USART1, duck-bridge-proto
    link.rs runs USART1 at 2 Mbps on PA9 (TX) and PA10 (RX) to UART7 on the CM4 carrier, speaking
    duck-bridge-proto, the protocol crate in microduck's workspace, by path from the sibling
    checkout. Reception is a circular DMA buffer, which keeps receiving through the polled servo
    loop's interrupts-off windows. Commands are stored for the segments; state requests are
    answered at once from what the segments and the IMU hold; info requests report the firmware,
    protocol, link baud, watchdog and the servo map.
    USART1's hardware FIFO is turned off at startup: with embassy's default of on, DMA transmits
    after boot left the F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
2026-10-05 Compute-to-bridge link: UART7 overlay and setup, pins and bench results in hardware.md
    setup-bridge-link.sh installs an Armbian user overlay enabling UART7 M0 on the CM4-NANO-A
    header (pins 16 and 18), masks any login console on /dev/ttyS7, and installs a boot service
    that moves the port's interrupt to CPU 3, away from CPU 0 and its other interrupts. The
    service opens the port first, because the driver only requests the interrupt on the first
    open. --check reports the node, the port, the interrupt and the receive error counters.
    hardware.md 5.4 now points at microduck's bridge-protocol.md and the duck-bridge-proto crate;
    5.5 has the pin table, the bridge's FIFO finding, why the CM4 receives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
2026-10-05 hardware.md: five minutes of the bridge link at 100 Hz, and a 19.2 s pattern in the misses
    With both boards on one USB host and the servos powered, 16 of 30,000 state requests went
    unanswered, all receive overruns on the CM4, no framing errors, and the camera stayed clean.
    Several misses are exactly 19.2 s apart, so the open item now points at a periodic task on the
    CM4 delaying the UART interrupt.
2026-10-06 changes to head and bridge power supplies
2026-10-06 Trunk IMU on SPI2, freeing UART4 on PC10 and PC11 for a fourth servo segment
    The LSM6DSV16X moves from SPI3 (PC10, PC11, PB5, CS PA15) to SPI2: SCK PB13, MISO PB14, MOSI
    PB15, CS PA4, INT1 still on PA8. PC10 and PC11 are UART4's only pins on this package, so the
    move leaves UART4 free for a segment D; PB14 was free because active drive needs no DE pin.
    hardware.md 5.3, 5.8, 6.1, 13 and 18 follow, and 5.8 says what a fourth segment would and
    would not buy: fewer servos per line, not a shorter pass.
    On the bench after the rewire: the IMU streaming at 120 Hz with no FIFO overruns or INT1
    timeouts, and the same through the link from the CM4, 500 of 500 state requests at 100 Hz.
    [main.rs]
2026-10-06 Bridge firmware: segment D on UART4 (PC10), for a robot with a fourth servo line
    UART4 runs single-wire on PC10 like the other segments: active drive, the polled loop (its
    registers sit at the same offsets), ID discovery. It is not wired on this robot; an empty
    segment rescans its IDs once a second. SEGMENTS is now 4 and the link's state and info frames,
    the console and the servo map carry segment D.
    On the bench, segment C's five servos moved to PC10 were found on D and answered every frame,
    3,000 of 3,000 state requests at 100 Hz; moved back, they were found on C again. hardware.md
    5.8 shows segment D in the diagram and pin table.
2026-10-06 Vendor datasheets and schematics stay local, with a list of their sources
    docs/datasheets is gitignored apart from a README that lists each file the docs refer to, what
    it is and where to download it. The two WeAct PDFs are untracked: WeAct's repository carries no
    licence. They remain in the history from 53e8666.
2026-10-09 bridge now has i2c oled display
2026-10-09 Bridge OLED shows a flashing low-battery warning
    The pack voltage is the highest supply reading any servo reports, until the
    bridge reads its own divider on PA0. The decision is made on a 10 s average,
    so the sag from a burst of movement does not trigger it: it warns below
    21.0 V (3.50 V per cell) and clears above 23.0 V. The warning replaces the
    status screen with a battery outline over "LOW BATTERY", drawn once at
    startup and flashed with the controller's invert command every 0.5 s, so it
    costs the servo loop nothing while it shows.
    The warning image and the link's receive buffer are statics, keeping 3 KB
    out of the main task, which the executor builds on the stack at startup.
    [battery.rs, display.rs, main.rs]
2026-10-09 Bridge shutdown button and head status on the OLED
    A normally open switch from PB5 (header P1-20) to ground, on the internal pull-up, polled every
    10 ms and debounced over 30 ms. Held for 3 s it asks the compute module to shut down, once per
    press, through SHUTDOWN_REQUESTED in the State replies. The request clears when the compute
    module reports shutting down, or lapses after 10 s so a press with robotd not running cannot
    shut the head down later.
    The OLED counts down while the button is held, then shows SHUTTING DOWN until it is released,
    and the countdown and request take the screen over the low-battery warning. The status screen's
    second line now describes the head from its HostStatus a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
2026-10-10 Docs: the low-battery warning, the shutdown button, and the trunk diagram
    hardware.md 5.8 describes the low-battery warning (servo voltage readings until the PA0
    divider is read, a 10 s average, 21.0 V to warn and 23.0 V to clear, flashed with the
    controller's invert) and the shutdown button (PB5 to ground, debounce and the 3 s hold, the
    request and HostStatus over the link, the head's states on the display, the 20 s before it
    shows the head off). PB5 joins the pin table and leaves the spare pins; both text diagrams,
    the trunk layout, the open items and a new change-log section follow. The distribution board
    is XT30 in, with no XT60 anywhere.
    The README's block diagram gains the OLED displa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
2026-10-11 Bridge carrier PCB: schematic, layout and JLC package
    A 45 x 80 mm, 2-layer trunk board for the bridge, designed in KiCad 10 for
    JLCPCB assembly (docs/bridge-pcb.md):
    - The WeAct STM32G474 core board and the LSM6DSV16X breakout on short
    header pins with a 1 mm gap; the IMU's unused 3-pin row gets support holes.
    - Male XT30U-M battery input, 10 A main fuse and input TVS, a P-FET soft start
    (about 30 ms ramp) to stop plug-in sparks, branch fuses to four servo
    segments and the head feed.
    - 5 V from an LMR51606 buck through a Schottky (no USB backfeed into the
    battery side) and a cuttable jumper, with wire pads for an external
    step-down as a backup.
    - Through-hole vertical JST PH head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
2026-10-12 Bridge PCB: soft power switch, PA5 breakout, time-lag fuses
    - Soft power switch: Q2 grounds the soft start's R1, so the button (J8,
    now BTN_A and BTN_B) or the bridge's PC4 hold turns the robot on. A
    stretch RC lets a tap last until the bridge has booted; Q3 gives PB5 an
    active-low button sense with no battery voltage on the pin; Q5 and Q4
    snap Q1 off in about 20 ms. Off leaves about 20 uA. JP2, open, bridges
    back to the old always-on behaviour.
    - PA5 breakout pads (G 5V 3V3 A5) in the bottom-left corner, name block
    moved below them.
    - Data-line zener footprints D4 to D7 dropped to make room; never fitted.
    - Segment B and D feeds get a second via at their layer change; SEG C's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
2026-10-12 Bridge PCB: head feed fuse F6 raised to 2 A
    The head carrier's 5 V, 3 A buck draws about 0.85 A from a nearly flat
    pack before amplifier peaks, too close to a 1 A rating. F6 is now the
    BSMD1206C-1200T (C41367223), same 1206 footprint; fab outputs and the
    schematic PDF regenerated, ERC clean.
2026-10-12 Head carrier PCB: design note
    Requirements, module pin allocation from the NANO-A schematic, connector
    pinouts, power budget, parts (LMR51635 60 V 3.5 A buck, MAX98357A,
    dual-contact camera FPC, DF40C sockets), two-layer stack and the camera
    lanes, module orientation and floor plan. The BMI088 module pictures are
    listed in the datasheets README.
2026-10-12 Head carrier PCB: mounting orientation, camera cable, GPIO_VREF
    The board lies module side down with the camera connector forward, so
    the camera cable runs straight from J8 with no fold. Propose PH headers
    on the back face. GPIO_VREF confirmed at 3.3 V.
2026-10-12 Head carrier PCB: PH headers and IMU module on the top face
2026-10-12 Head carrier PCB: library and schematic
    DukkiHead library from scripts/kicad/gen_head_kicad.py: the CM4 sockets
    and module outline split out of Raspberry Pi's CM4 IO footprint (two
    DF40C parts for JLC), the CM4 symbol as one symbol per socket, the
    XUNPU camera FPC from LCSC's EasyEDA library, LMR51635 renumbered to its
    own pinout, MAX98357A with a passive pad, and the BMI088 module.
    Schematic bootstrapped by scripts/kicad/gen_head_sch.py: head bundle
    in, 60 V 3.5 A buck at 5.17 V, AMS1117, MAX98357A, fan FET, eye LED,
    I2C8 devices, microphone and camera connector. ERC clean; netlist
    checked against docs/head-pcb.md.
2026-10-12 Head carrier PCB: first layout pass
    Placement from the netlist (scripts/kicad/gen_head_pcb.py): module and
    sockets locked at their fixed offsets, side headers in the strip left of
    the module and down the right edge, camera FPC facing the bottom edge.
    Routing (scripts/kicad/route_head_pcb.py): camera pairs and the 5 V
    trunk drawn by hand and locked, the rest by Freerouting, pours and
    stitching. 11 connections still open; see docs/head-pcb.md 9.1.
2026-10-12 Head carrier PCB: module turned 180 degrees, routing round two
    J9 now faces the free block, so 5 V and most signals leave the socket
    straight towards their parts; only the camera pairs cross the module,
    drawn as offset polylines down the left strip and under its lower edge.
    Eye LED and ToF headers in the left strip, microphone on the right.
    12 connections still open, all where J9's outer row meets the 5 V run
    and the AMS1117; see docs/head-pcb.md 9.1.
2026-10-12 Head carrier PCB: routed, DRC clean, JLC package
    UART7 and the SAI2 bit clock drawn by hand on the bottom layer from vias
    beside J9; a finishing Freerouting pass (scripts/kicad/finish_head_pcb.py)
    routes the rest at 0.13 mm signal clearance. DRC with schematic parity
    is clean. export_jlc.py now takes the board name; the head's Gerbers,
    BOM and CPL are in hardware/head/fab, with 3D renders beside the board.
2026-10-13 Head carrier PCB: BMI088 on board, fallbacks, 1.1 MHz buck (one connection open)
    BMI088 chip in place of the module, with links to cut for an external
    module on J3; a wide 3 A link (JP1) between the buck and the 5 V rail
    with external 5 V pads (J12); a link (JP3) in the amplifier's 5 V with
    module pads (J11). Buck now LMR51635YDDCR with a 4.7 uH SWPA6045.
    Silkscreen labels and the name block on the back. ToF and eye headers
    moved 0.3 mm clear of the module's edge. One I2C SCL connection still
    open; fab outputs not regenerated. See docs/head-pcb.md 9.3.
2026-10-13 Head carrier PCB: last connection routed, DRC clean, JLC package regenerated
    The I2C8 SCL pull-up and JP5's bus side, stranded by Freerouting, are
    joined by scripts/kicad/route_one_net.py, a small two-layer maze router
    for a single net. DRC with schematic parity: 0 violations, 0
    unconnected. Gerbers, BOM (26 lines) and CPL (39 placements)
    regenerated, with renders and the schematic PDF; about AUD 159 for 5
    assembled boards before bare boards and shipping.
2026-10-13 Head carrier PCB: layout PDF
    One page per layer as for the bridge, plus the back silkscreen mirrored
    so its connector names and name block read as seen from the back.
2026-10-13 Head carrier PCB: tidy the routing, sparser stitching
    scripts/kicad/tidy_head_pcb.py removes the 610 stitching vias, replaces
    pairs of segments meeting at a bare joint with one straight segment
    where it clears other copper and the keep-outs (306 joints), widens
    necked segments to their net class where they fit, and stitches again
    on a 3.5 mm grid plus rows beside the camera pairs (163 vias). DRC with
    schematic parity still clean. Fab package, renders and layout PDF
    regenerated.
2026-10-13 Head carrier PCB: remove the autorouter's redundant ground tracks
    Freerouting routed GND as tracks before the pours existed; they showed
    as copper across ground pads' thermal reliefs. All were ground on
    ground. The tidy's new unground stage removes the 215 unlocked GND
    segments; the pours reach every ground pad (C9's now solid). DRC with
    schematic parity clean; fab package, renders and layout PDF
    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
2026-10-13 Head carrier PCB: no vias in pads, duplicate tracks removed
    The re-stitching had put five ground vias inside ground pads, among
    them the amplifier's exposed pad; it now keeps clear of every pad.
    The tidy's new dedupe stage removes the 97 copies Freerouting made of
    the locked tracks, and straightening may now pass through a pad joint
    when another track still reaches the pad. DRC with schematic parity
    clean; fab package, renders and layout PDF regenerated.
2026-10-15 Head carrier PCB: SPI breakout pads (SPI2 M1) on the bottom
    J13: nine wire pads under the module along the top edge (GND, 5V,
    3V3, MOSI, MISO, CLK, CS0, INT, spare GPIO) on SPI2 M1, the RK3576 SPI
    the eye LED leaves free, plus GPIO6 and GPIO5. The board is routed
    again from placement with J13 in it; new scripts/kicad/sync_head_pcb.py
    syncs a routed board with its schematic. The maze router now keeps
    holes and footprint keep-outs clear, sees jumper bridges and uses
    per-net clearances; the tidy gains an undangle stage and stitches
    floating pour. DRC 0 violations; two module ground pins (J9 32, 33)
    are boxed in and left unconnected, documented in docs/head-pcb.md 6.2.
2026-10-16 Bridge PCB rev B: WeAct header fix and pre-order review changes
    - WeAct footprint: the VCC-side header (P1) had its rows swapped. The
    generator put odd pins on the inner row of both headers, but the two
    headers are the same part placed the same way round, so P1's odd pins
    are on its outer row (confirmed on the board: PB13 is on P1's inner
    row). Every P1 signal would have met its column neighbour.
    - J7 (display) is now a 5-pin PH so the 4-pin head cable cannot go in it.
    - C15, 1 uF X7R on PWR_ON: holds the power switch through a bridge reset
    and stretches a tap; C14 now X7R 0805, R14 220k.
    - L1 SWPA6045S330MT (1.65 A saturation), D2 SMBJ26A (C19077580,
    Preferred).
    - Buck column re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
2026-10-16 Head carrier PCB rev B: pre-order review changes, USB download pads
    - Buck input loop: C4 straight across U2's VIN and GND pins with ground
    vias beside them; boot cap and feedback divider at their pins.
    - Input chain J1, TVS, C17 (47 uF 50 V electrolytic, C970679), then the
    ceramics; C3 dropped; fan parts moved down.
    - 330R series resistors (R13, R14) in the link UART; J1 pins 3 and 4
    are now LINK_RX and LINK_TX.
    - Bottom test pads: RST and BOOT (CM4 pins 92, 93), and USB D+, D-, G
    for the RK3576 download port (pins 105, 103) to flash in place.
    Pins checked against Radxa's CM4 schematic v1.20, sheets 8, 21, 22.
    - J13 moved 2.5 mm clear of the module's M2.5 holes; J8 ends marked
    1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
2026-10-16 Bridge PCB: module pin labels and ground marks on the silkscreen
    - Pin labels for the WeAct board in its own silkscreen style (two lines
    per column between the header rows, the upper line naming the upper
    row) and for the LSM6DSV16X breakout beside each pin, from the new
    scripts/kicad/module_labels.py. They lie under the modules once fitted,
    for checking orientation as each goes on.
    - A G beside the ground pin of each segment connector, outside the
    housing: a reversed pigtail swaps SIGNAL and GND.
    - Silkscreen only, no copper changes; DRC clean with schematic parity.
    JLC package, layout PDF and render regenerated.
2026-10-16 Bridge PCB: pin names inside the head and display connector outlines
    - J6 (head: B+, G, TX, RX) and J7 (display: G, 3V3, SCL, SDA, NC) get
    their pin names on the front silkscreen inside the housing outlines,
    in 0.6 mm text to fit between the pads and the outline. Hidden once
    the connectors are fitted; a reference on an unpopulated board.
    - The board's minimum silkscreen text height is lowered to 0.5 mm for
    them (JLC recommends 0.8 to 1.0 mm, so they print a little soft).
    Gerbers and layout PDF regenerated.
    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
2026-10-16 Bridge PCB: second pre-order review fixes
    - R14 220k to 100k (C25803, already on the board): a 70 ms tap latches
    at an 18 V pack with worst-case parts (220k needed about 150 ms).
    - Buck feedback re-routed: from U1's FB pin straight to the bottom layer
    and down the west side to the divider, 17 mm, at least 1.9 mm from
    switch-node copper (it ran between the CB and SW pins and 0.22 mm
    beside L1's switch pad).
    - Local copper: F3's segment B vias moved off its output pad; D2's
    ground pad solid with two stitching vias; 0.75 mm clearance round the
    XT30's + pad and a shorter ground bar beside it; JP2's ground pad on
    thermal spokes; a second via at two of VHEAD's layer changes.
    - Silksc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
2026-10-16 Bridge PCB: polarity check picture for JLC's placement preview
    - hardware/bridge/bridge-polarity.png: top render with every assembled
    polarised part's pin 1 or cathode ringed and its CPL rotation
    labelled, hand-fitted parts hidden as in JLC's preview.
    - scripts/kicad/polarity_check.py makes it (VM, PIL).
2026-10-16 Head carrier PCB: PWM pad for a possible mouth servo
    - TP7, a bottom pad beside J9 on CM4 pin 37 (GPIO7, RK3576 GPIO1_C0,
    PWM0_CH0_M1), in case the mouth J288 is swapped for a hobby servo. The
    servo would run from its own buck module fed from J12's B+ and G, not
    the head's 5 V buck. PWM0 is separate from the fan's PWM1.
    - Pin 48 (PWM1_CH0_M2) was tried first; on J9's inner row it is boxed in.
    - Design note: J13 already gives spare GPIOs with 3V3 and GND (pads 8, 9
    and the SPI2 lines); a separate breakout under the module was tried and
    dropped (only a 130 mm, 11-via route).
    - DRC 0 violations with schematic parity (J9 pad 23 as before); JLC
    package, PDFs and bottom render regenera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
2026-10-17 Head PCB: rev B second review, head_ext variant with the BMI088 module
    Rev B (hardware/head), second pre-order review (docs/head-pcb.md 9.5):
    - R13 1k on the link RX line; J13's 5 V re-routed clear of the module
    hole; ground vias and solid ground pads at C1, C2, D1 and C17; 3.3 V
    copper on the AMS1117 tab
    - CM4 orientation marks (CM4 U.FL END, pin 1 and 101 dots); J11 and J12
    names on the back
    - polarity picture for JLC's placement preview
    head_ext (hardware/head_ext, 9.6): rev B with the generic BMI088 module
    hand-fitted in place of the chip, so the board needs only Economic PCBA
    - U5 chip, C15, C16, JP4, JP5, R8, R9 and the J3 PH header removed
    - module on the front, rows 11.3 mm ap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
2026-10-21 Bridge: new commands reach the servos at once; flash through the console
    Every exchange now takes the latest host command rather than each round
    taking it once at its start. Rounds of the three interleaved segments run
    nearly back to back (about 3.5 ms), so a command arriving mid-round used to
    wait for the next round. A command also wakes an idle segment at once.
    Measured with bridge_latency at kp 1: the median from a servo's sample to
    its torque response fell from about 12.75 ms to 10.75 ms. On the console,
    the first exchange to carry a command now follows it by 0.07 to 0.6 ms.
    The console reports, per segment, the time from a command arriving to its
    first and last servo exchange; `i` swit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
2026-10-21 Docs: flashing the bridge through its console, without the buttons
    hardware.md 5.8 describes the console's U, how the firmware enters the ROM
    bootloader and why it sets VTOR, what flash.sh does, the first flash of a
    new board by hand, and keeping USB connected on the power-latch PCB.
    AGENTS.md points future sessions at it.
2026-10-21 Bridge: serve the servo segments side by side
    One loop now serves every segment. A round is a run of slots, and in each
    slot every segment has one exchange, run side by side in one
    interrupts-off loop (transact_all), so a round over five servos a segment
    takes five exchange times rather than fifteen. A scanning segment asks one
    ID per slot instead of pausing the others. Timeouts count CPU cycles (DWT)
    rather than loop passes, and the UART FIFOs are turned on: the loop fills
    the transmit FIFO and drains the receive one as far as they go, because
    one byte a pass left gaps inside the outgoing frame and the servos ignored
    those frames.
    The console's `g` cycles the lines between parallel (the de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
2026-10-21 Bridge: protocol 2, a fresh sample per tick and targets alone
    A SampleRequest wakes the segments for a round at once, and the link
    answers with a Sample (226 bytes) once a round that started after the
    request has finished, so the positions in it are under a millisecond old.
    Targets (82 bytes) replace the positions in the last full Command, which
    now only goes when a mode, gain or action changes. The full State and
    Command stay for diagnostics and setup.
    The segment loop no longer spins without yielding when every segment is
    empty and no scan is due: it waits for the tick as when polling.
    Measured with bridge_latency at kp 1: a servo's sample to its torque
    response 4.75 ms at the median, fr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
2026-10-21 hardware.md: control-loop delay with every servo moving, and no missed replies
2026-10-21 STEP files for the assembled bridge and head_ext boards
    scripts/kicad/export_step.py exports a temporary copy of a board from its
    drill origin, adding approximate models for the head's CM4, DF40C sockets,
    camera FPC connector and BMI088 module, and swapping the WeAct board's
    model (no licence) for our own stand-in so the bridge STEP can be committed.
2026-10-23 Bridge: power hold on PC4, rail on PA0 and the watchdog
    The carrier PCB's soft power switch: PC4 holds it on after the button's
    press, PA0 reads the switched rail through its divider. At boot the hold
    goes on if the button is down or the rail is live; a press that powered
    the robot on does not count towards the 3 s shutdown hold; a committed
    shutdown releases the hold once the head is off. On USB a fresh press
    turns the robot on again. The IWDG resets a hung bridge so the hold
    cannot stick. The OLED's top line shows the rail voltage.
    bridge-pcb.md 6.5 rewritten to the rules as implemented.
2026-10-23 Bridge: low-battery warning from PA0, not the servos
    The servos' supply readings come in 0.5 V steps, and a servo that loses
    power keeps its last reply, taken as the rail fell, so the warning
    flashed after every power-off. The warning now averages the switched
    rail on PA0, counted once it has been live for a second; with the power
    off there is no reading and the warning clears.
    Checked 23/10/2026 on the rev B carrier: all fifteen servos on segments
    A, C and D answered every frame through damp, hold, wiggle and stop,
    rail 24.0 V on PA0 against 23.5 to 24.0 V from the servos.
2026-10-24 hardware.md: shutdown timed end to end on the carrier boards
    bridge_probe standing in for robotd, a real systemctl poweroff on the
    head, and the bridge releasing the power hold 20 s after the last
    command: the CM4 finished its shutdown about 2 s after poweroff began,
    so the 20 s has about 18 s of margin.
2026-10-24 hardware.md: robotd answers the shutdown button
    robotd now acknowledges the bridge's request and powers off (microduck
    dukki 48dedf2); tested on the carrier boards with the robot not enabled.
2026-10-24 express-setup.md: the head fan at 100 Hz, minimum 25 %
    At 25 kHz the head's 2-wire fan stalled at every duty short of full; at
    100 Hz it holds at 20 %. expressd's defaults change to match (microduck
    dukki). The fan running at switch-on before expressd starts stays open.
2026-10-24 express-setup.md: the head fan at 200 Hz
    Still holds at 20 %, with less hum than at 100 Hz.
2026-10-24 PCB docs: renders, and both boards made and tested
    Small 3D renders at the top of bridge-pcb.md and head-pcb.md (head_ext,
    the board that was built). Status lines updated: bridge rev B and head_ext
    assembled by JLC and tested on the bench. Two bring-up findings corrected:
    the J288 pigtail has pin 1 GND, so the segment headers are fitted turned
    180 degrees; J8 is laid out 180 degrees off, and a cable turned over still
    connects with its pins reversed.
2026-11-07 CAD STL exports, and the Fusion to MJCF converter
    hardware/cad/stl: the 3D printed and titanium parts from claude_test, one
    STL each in mm.
    scripts/f360_to_mjcf: puts the Fusion geometry into microduck_rl's seven
    robot models: low-resolution meshes, collision roles carried over, the
    battery as a 132 g box, and the imu site moved to the LSM6DSV16X on the
    bridge, with an imu_chip site carrying the chip's axes.
    hardware.md: the new IMU position, and the mount quaternion for the CAD
    placement, (0.5, -0.5, -0.5, 0.5).
2026-11-07 f360_to_mjcf: level the soles, J288 from primitives
    fit_links.py turns each foot about its ankle axis until the sole's
    underside is level, heel to toe, with the Onshape sole's: claude_test's
    feet are about 1.5 degrees toe-down. build_mjcf.py keeps the soles at
    full resolution and builds the J288 as a box plus a cylinder for the
    driven horn.
2026-11-07 f360_to_mjcf: inertials from Fusion and weighed parts
    fusion_phys.py dumps every part's mass, centre of mass and inertia from
    claude_test, whose printed parts are now PA12 SLS (and the soles TPU).
    masses.json holds the weighed bought parts, with optional centres of
    mass, and the parts not on the robot (the soft jaw). build_mjcf.py sums
    the parts into each body's inertial, replacing the battery swap.
2026-11-08 f360_to_mjcf: colours and appearance from Fusion
    fusion_appearance.py dumps each part's effective appearance (occurrence
    overrides included) and exports the multi-coloured parts body by body.
    build_mjcf.py takes each part's material from its main appearance and
    draws the bridge, head compute and camera in one visual mesh per
    appearance, in place of the old Onshape colours.
2026-11-08 f360_to_mjcf: lift near-black colours to dark grey
    Near-black, near-neutral appearances (the black PA12 parts, J288s, soles,
    dark electronics) rendered as a featureless silhouette in MuJoCo.
    lift_dark() maps each channel v to 0.25 + 0.5 v when the brightest channel
    is at most 0.2 and the channels are within 0.04 of each other, so the
    printed parts go from 0.086 to 0.29 and the soles from 0.15 to 0.33,
    keeping their order. Coloured parts are left alone.
